LlamaLuLu/EEE4022S-AR-Spine-Registration/docs/figures/fig_atp6_timing.pdf

## Wireframe on Wireframe off

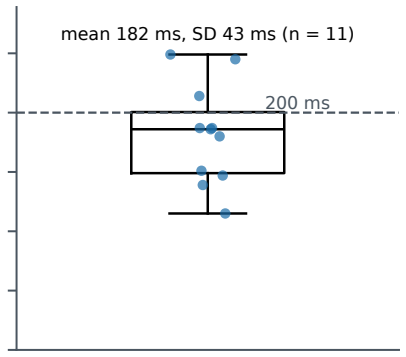
[picture p6: figure]
mean 182 ms, SD 43 ms (n = 11)

0

10

20

30

40

## Processing time per frame (ms)

29.7 ms
30.4 FPS

10.6 ms
31.3 FPS

## (a) Pipeline timing

Frame grab
Detect + PnP
Overlay
Qt display

0

50

100

150

200

250

## Camera-to-screen latency (ms)

## (b) End-to-end latency
