LlamaLuLu/EEE4022S-AR-Spine-Registration/docs/figures/fig_calib_depth.pdf

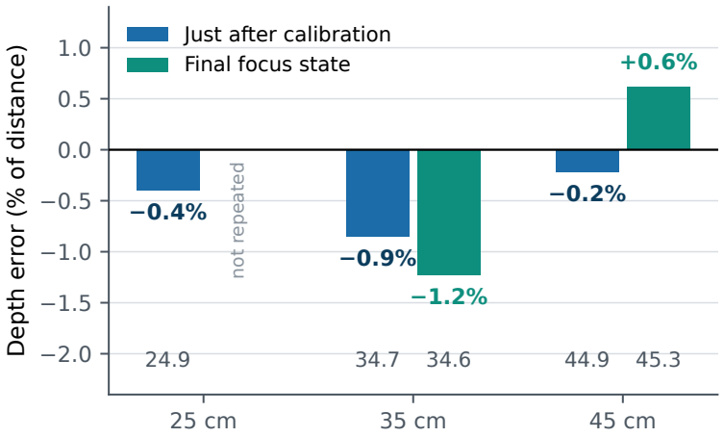
[picture p7: figure]
Depth error (% of distance); not repeated; Just after calibration Final focus state

Measured distance (ruler). Grey numbers: recovered depth (cm)
