LlamaLuLu/EEE4022S-AR-Spine-Registration/docs/figures/fig_envelope_diagram.pdf

(a) Plan view: azimuth and distance
(b) Side view: elevation and distance

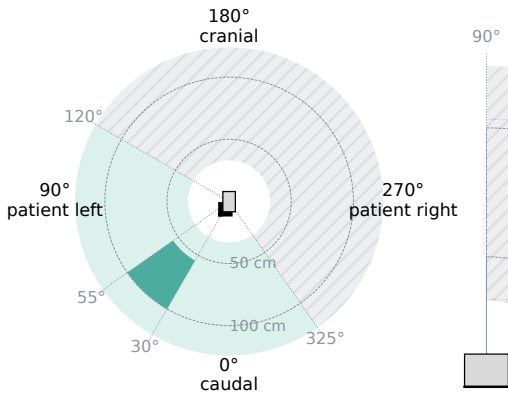
[picture p8: figure]
0° caudal; 90° patient left; 180° cranial; 270° patient right
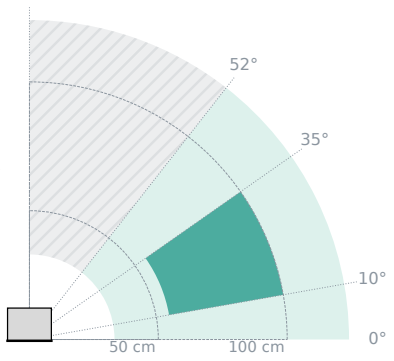
[picture p9: figure]

Full accuracy: both faces, 55-100 cm, azimuth 30-55°, elevation 10-35°
Reduced: tracking holds, one face or steeper view (to 124 cm, elevation up to 52°) Outside: tracking unreliable or lost
