LlamaLuLu/EEE4022S-AR-Spine-Registration/docs/figures/fig_error_budget.pdf

L5 | L4 | L3 | L2 | L1
Pedicle level (L5 nearest the markers)

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
Overlay error, RMS (mm)

Calibrated focus

L5 | L4 | L3 | L2 | L1
Pedicle level (L5 nearest the markers)

Drifted focus

Measured | Random (simulated) | Remaining error
