LlamaLuLu/EEE4022S-AR-Spine-Registration/docs/figures/fig_method_states.pdf

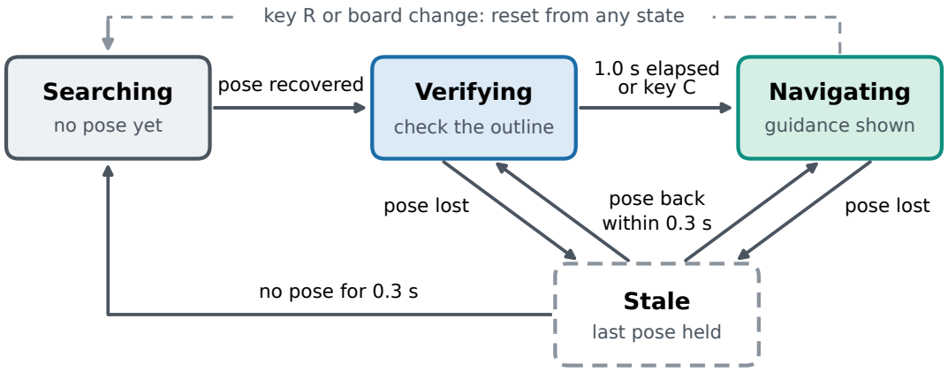
[picture p10: figure]
Searching; no pose yet; Verifying; check the outline; Navigating; guidance shown; Stale; last pose held; pose recovered; 1.0 s elapsed or key C; pose lost; pose lost pose back; within 0.3 s; no pose for 0.3 s

a pose that returns resumes the state it left key R or board change: reset from any state
