LlamaLuLu/EEE4022S-AR-Spine-Registration/docs/figures/fig_method_visibility.pdf

marker

θ | normal
w ∝ cos θ | image camera
(a) What the detector sees
(b) Falls with view angle

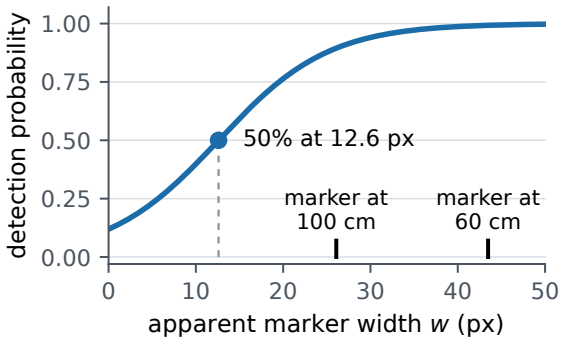
[picture p11: figure]
apparent marker width w (px); detection probability; marker at 100 cm; marker at 60 cm

(c) Rises with apparent width

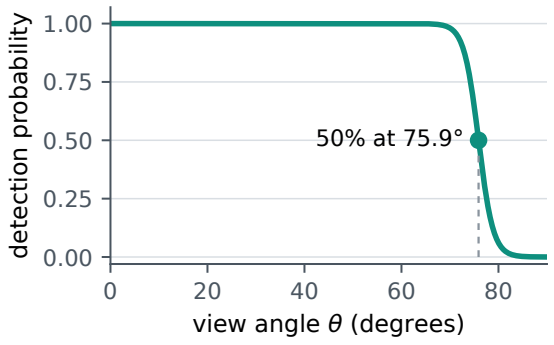
[picture p12: figure]
view angle θ (degrees); detection probability
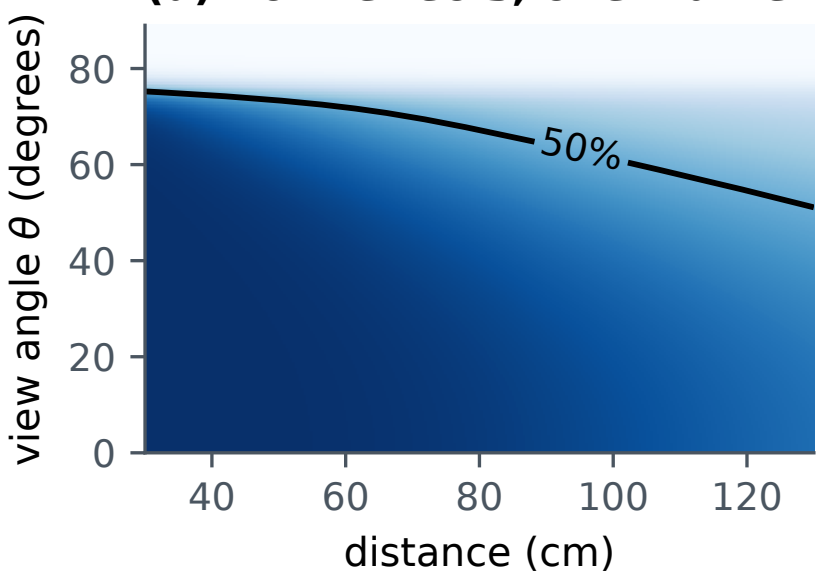
[picture p13: figure]
distance (cm); vie; w angle; gre

(d) Both effects, one marker

0.0

0.2

0.4

0.6

0.8

1.0
detection probability
