LlamaLuLu/EEE4022S-AR-Spine-Registration/docs/figures/fig_method_visibility_row.pdf

marker

θ | normal
w ∝ cos θ | image

camera

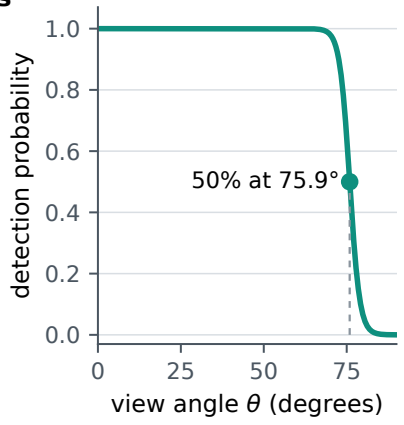
[picture p14: figure]
view angle θ (degrees); detection probability

(a) What the detector sees
(b) Falls with view angle

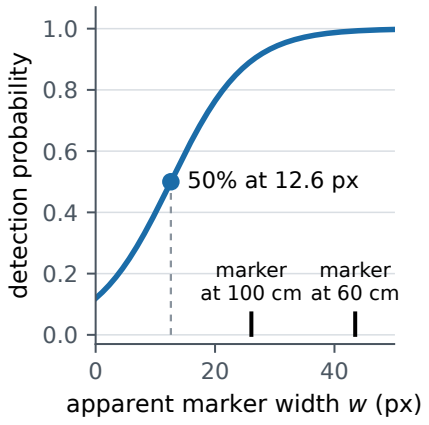
[picture p15: figure]
apparent marker width w (px); detection probability; marker at 100 cm; marker at 60 cm

(c) Rises with width

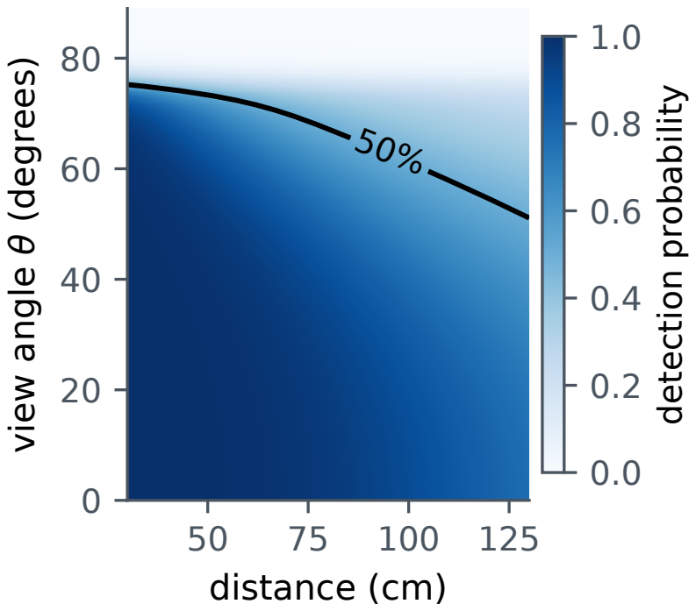
[picture p16: figure]
distance (cm); vie; w angle; gre; detection probability

(d) Both effects, one marker
