LlamaLuLu/EEE4022S-AR-Spine-Registration/docs/figures/fig_tier_comparison.pdf

Full
(6.8)

Reduced
(5.4)

Outside
(2.0)

0

25

50

75

100

Share of frames (%)

(a) Tracking

PnP success
Overlay lost

Full
(6.8)

Reduced
(5.4)

Outside
(2.0)

0

1

2

3

4

Predicted TRE (mm)

(b) Predicted TRE

Mean over targets
Worst target, p95
