LlamaLuLu/EEE4022S-AR-Spine-Registration/docs/figures/lit_registration_taxonomy.pdf

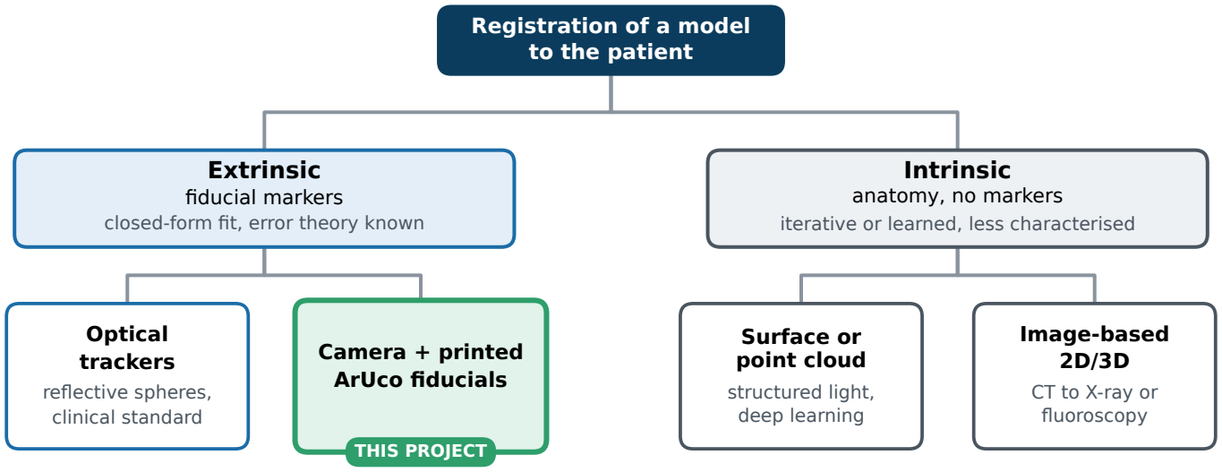
[picture p18: figure]
Registration of a model to the patient; Extrinsic fiducial markers closed-form fit, error theory known; Intrinsic anatomy, no markers iterative or learned, less characterised; Optical trackers reflective spheres, clinical standard; Camera + printed ArUco fiducials; THIS PROJECT; Surface or point cloud; structured light, deep learning; Image-based 2D/3D; CT to X-ray or fluoroscopy
