LlamaLuLu/EEE4022S-AR-Spine-Registration/docs/figures/fig_method_variants.pdf

## V0 Flat baseline board

4 coplanar markers on the base plate, seen from above

## V1 L-bracket, spread

6 markers, centres 15 to 65 mm from the face edges

## V2 L-bracket, clustered

6 markers, centres 27 to 53 mm from the face edges

## V3 L-bracket, 8 markers (fabricated)

8 markers, centres 15 to 65 mm from the face edges

Key

Face A, caudal wall

Face B, patient-left wall

n | 20 mm marker, ID n
| 20 mm, same scale

Plan view at left: where the bracket sits on the plate. V1 to V3 are
unfolded as seen from outside the bracket corner (arrow), junction in the middle.

spine (occludes the plate markers)

patient left

patient right

caudal end | cranial end

1 0

2

3

Face B | Face A
| 0 1

2

3 4

5

Face B | Face A

0 1

2

3 4

5

Face B | Face A
| 0 1

2 3

4 5

6 7

A

B
