LlamaLuLu/EEE4022S-AR-Spine-Registration/data/atp/azimuth_dial.pdf

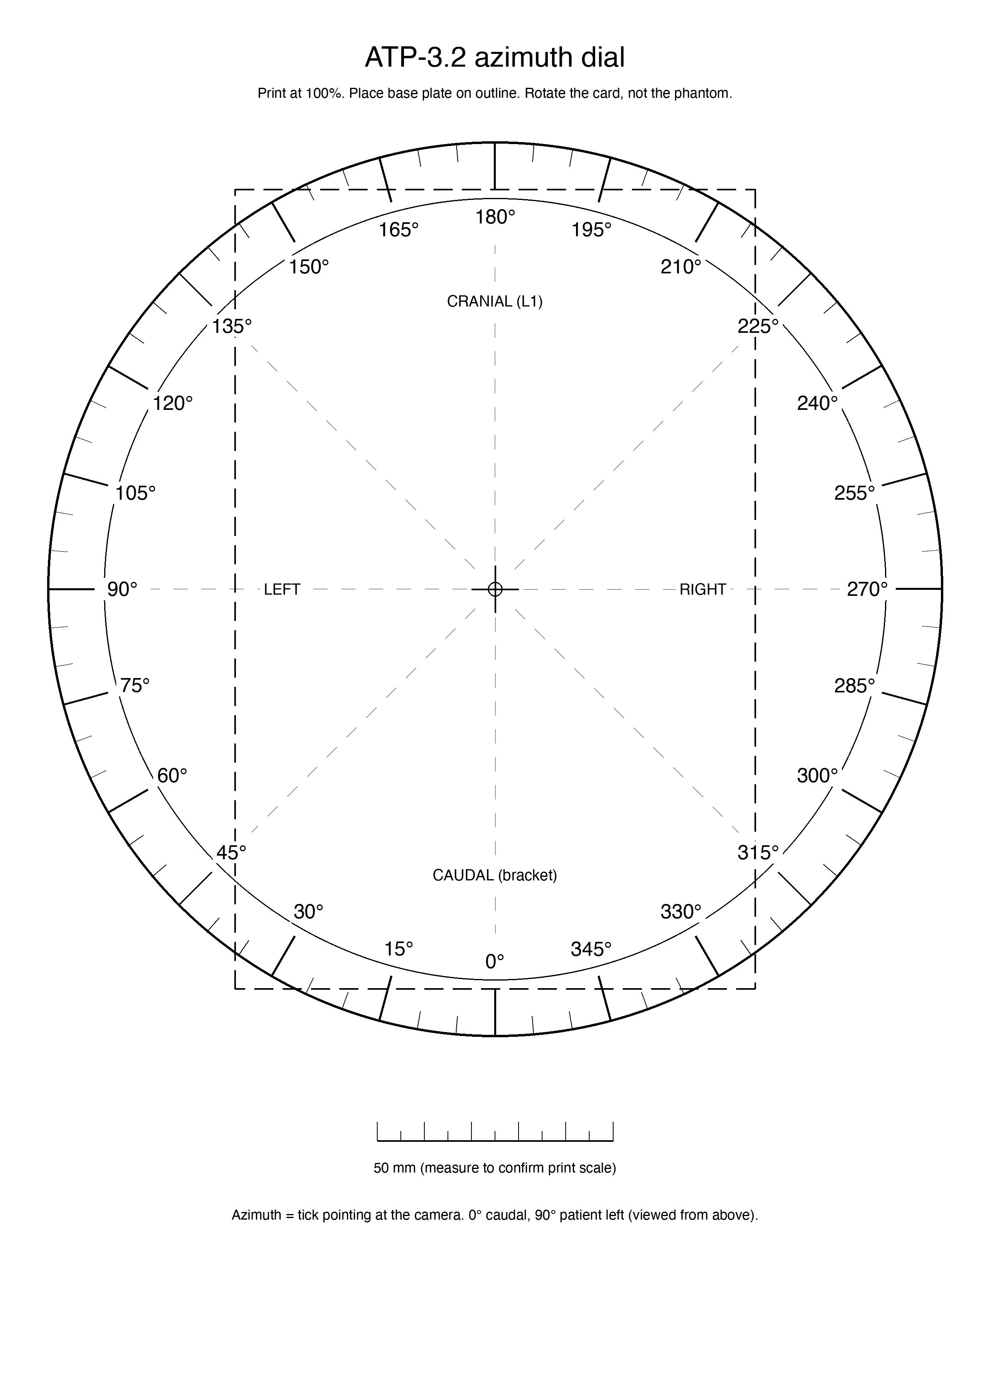
[picture p19: page 1]
