LlamaLuLu/EEE4022S-AR-Spine-Registration/data/bracket_markers/bracket_face_blocks.pdf

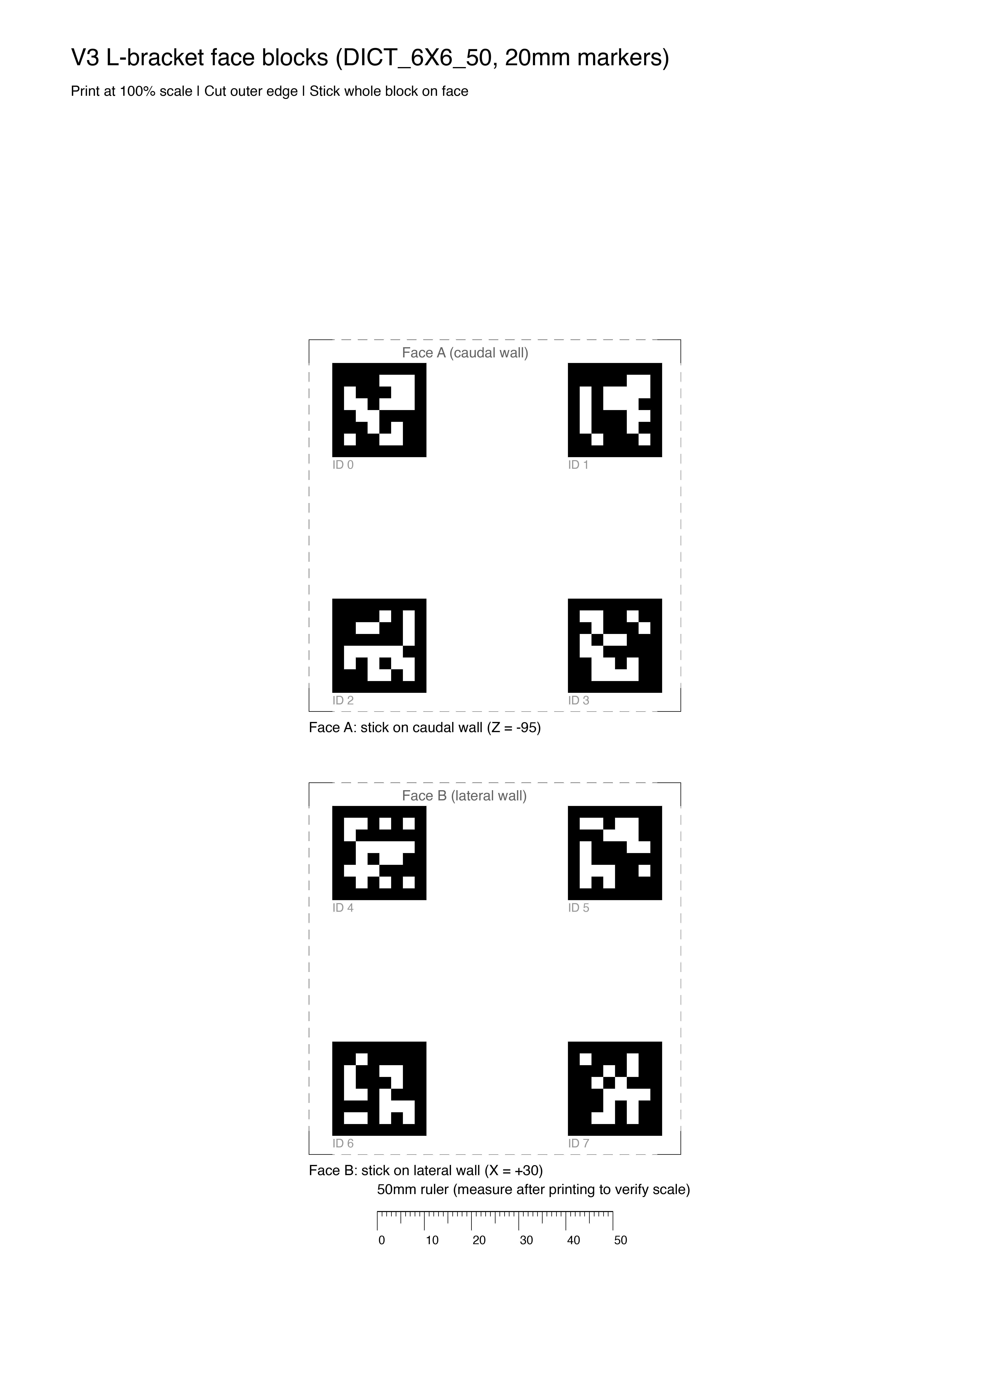
[picture p20: page 1]
