LlamaLuLu/EEE4022S-AR-Spine-Registration/data/bracket_markers/bracket_markers.pdf

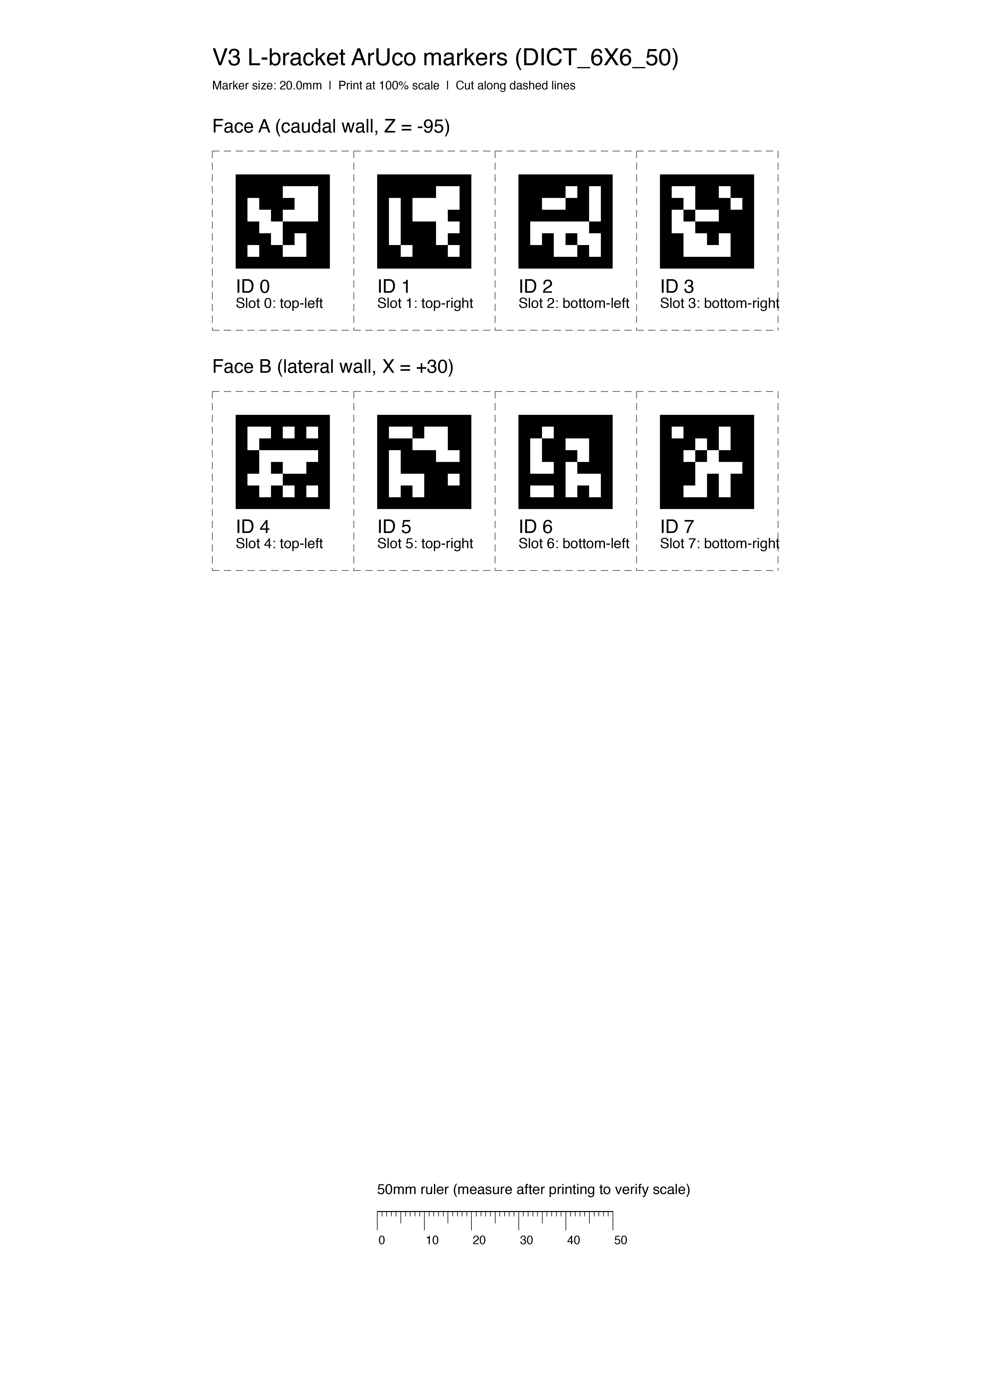
[picture p21: page 1]
