LlamaLuLu/EEE4022S-AR-Spine-Registration/appendix_figs/new_ui/ui_a_p1_tracking_good.png

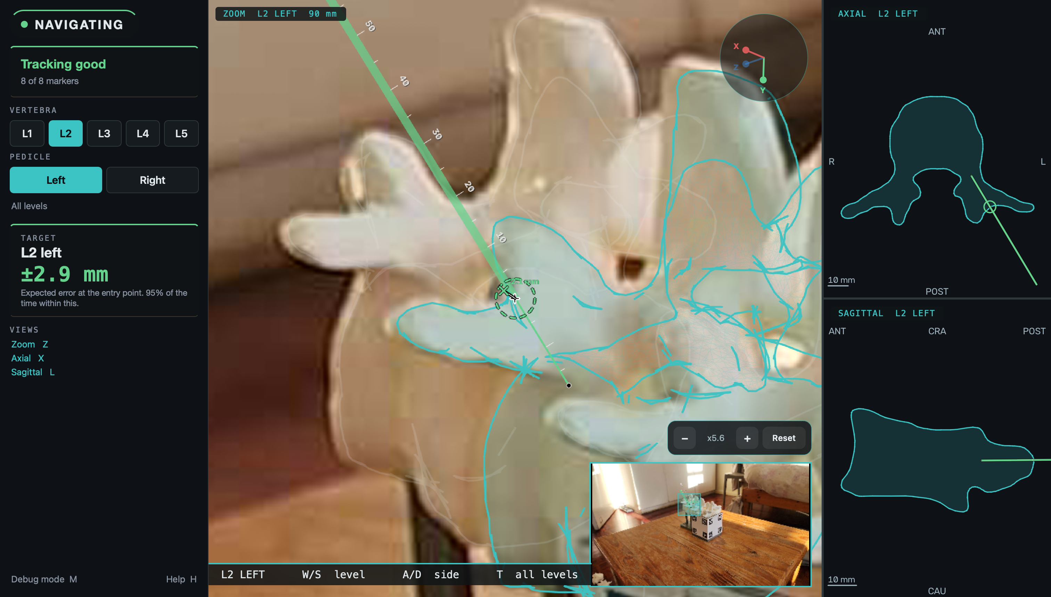
appendix_figs/new_ui/ui_a_p1_tracking_good.png
