LlamaLuLu/EEE4022S-AR-Spine-Registration/appendix_figs/new_ui/ui_b_p1_tracking_limited.png

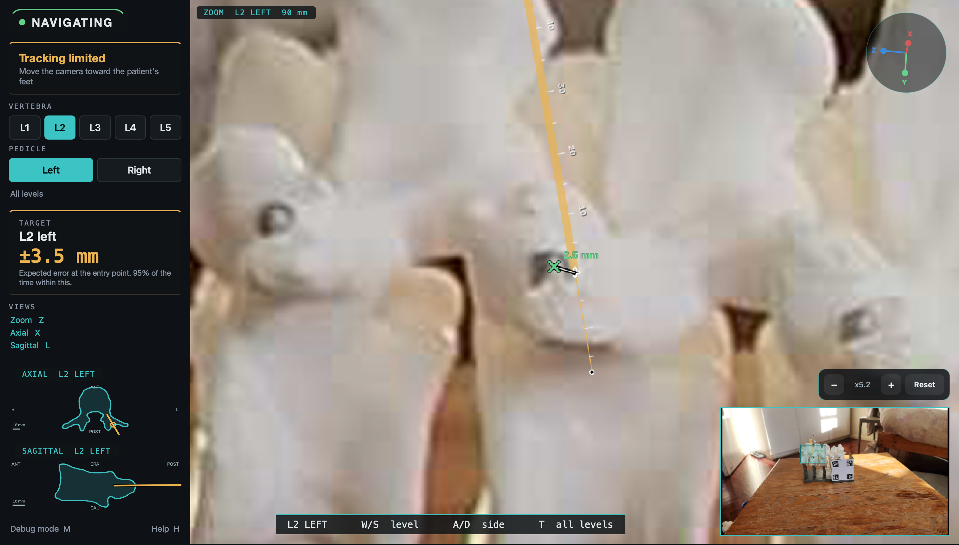
appendix_figs/new_ui/ui_b_p1_tracking_limited.png
