LlamaLuLu/EEE4022S-AR-Spine-Registration/appendix_figs/new_ui/ui_c_p1_poor_4of8.png

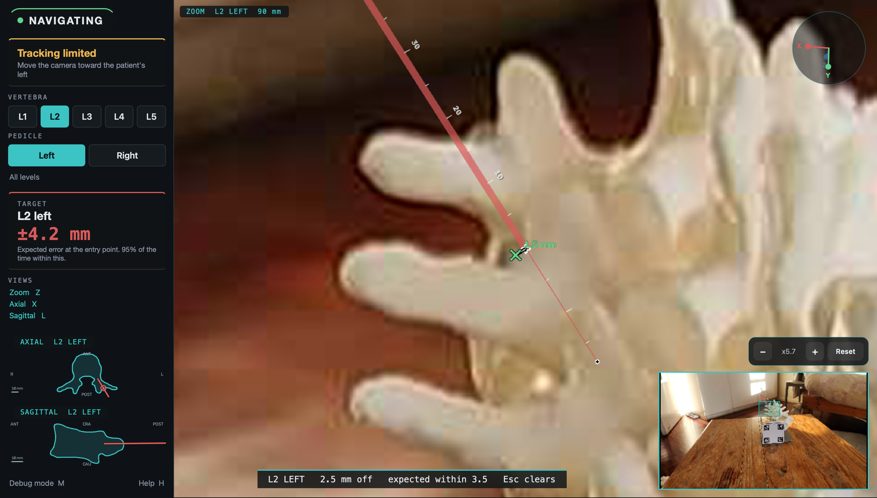
appendix_figs/new_ui/ui_c_p1_poor_4of8.png
