LlamaLuLu/EEE4022S-AR-Spine-Registration/appendix_figs/new_ui/ui_d_p2_tracking_good.png

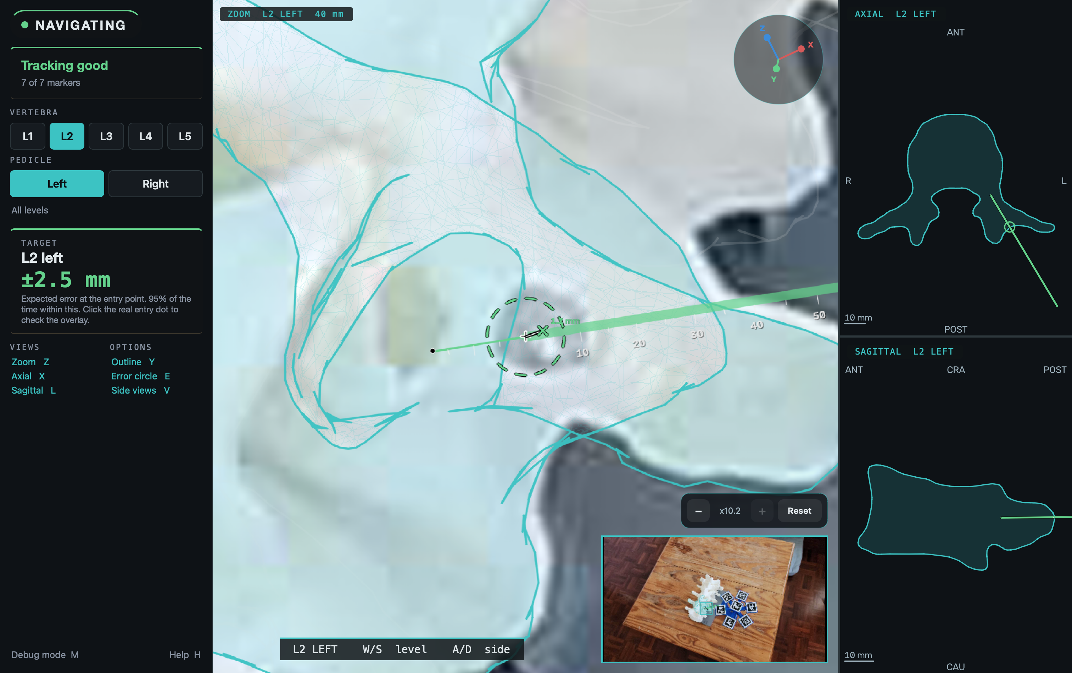
appendix_figs/new_ui/ui_d_p2_tracking_good.png
