LlamaLuLu/EEE4022S-AR-Spine-Registration/appendix_figs/p1_lighting/p1_light_a_normal.png

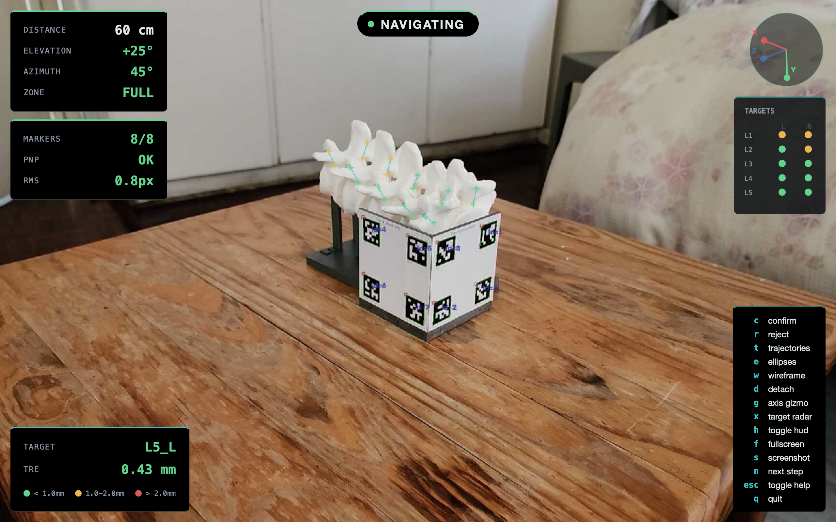
appendix_figs/p1_lighting/p1_light_a_normal.png
