LlamaLuLu/EEE4022S-AR-Spine-Registration/appendix_figs/p1_occlusion/p1_occ_a_8of8.png

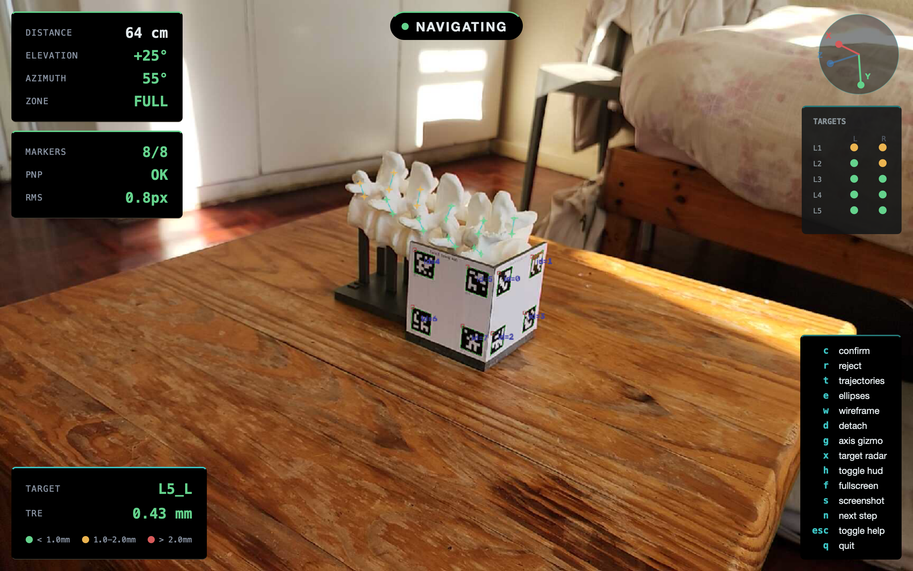
appendix_figs/p1_occlusion/p1_occ_a_8of8.png
