LlamaLuLu/EEE4022S-AR-Spine-Registration/appendix_figs/p1_occlusion/p1_occ_b_4of8_reduced.png

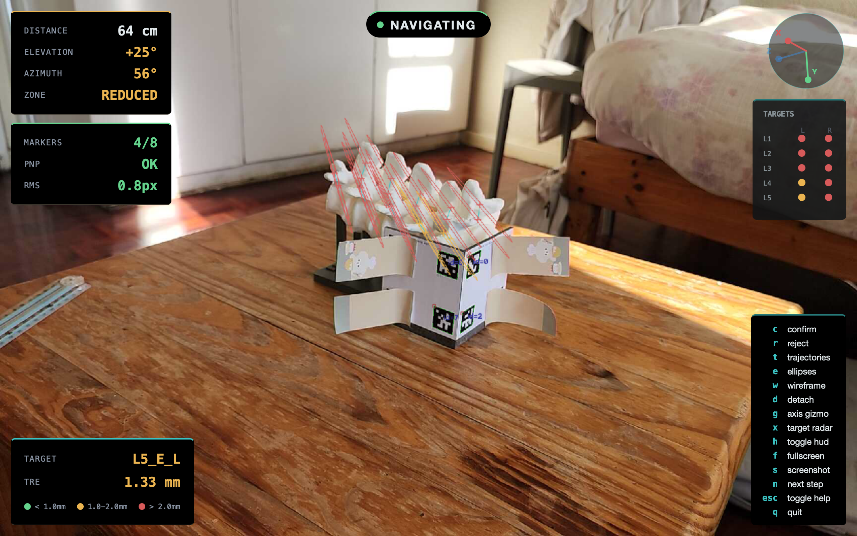
appendix_figs/p1_occlusion/p1_occ_b_4of8_reduced.png
