LlamaLuLu/EEE4022S-AR-Spine-Registration/appendix_figs/p1_occlusion/p1_occ_c_3of8_fail_searching.png

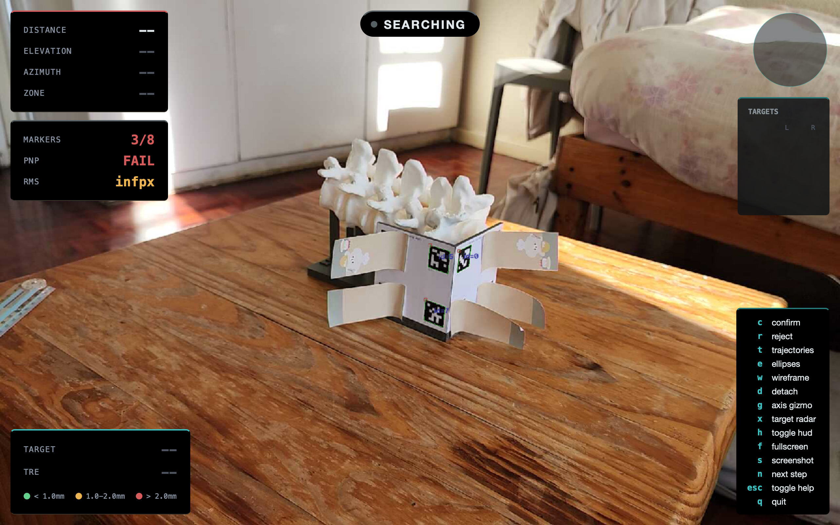
appendix_figs/p1_occlusion/p1_occ_c_3of8_fail_searching.png
