LlamaLuLu/EEE4022S-AR-Spine-Registration/appendix_figs/p1_occlusion/p1_occ_d_3of8_stale_pose.png

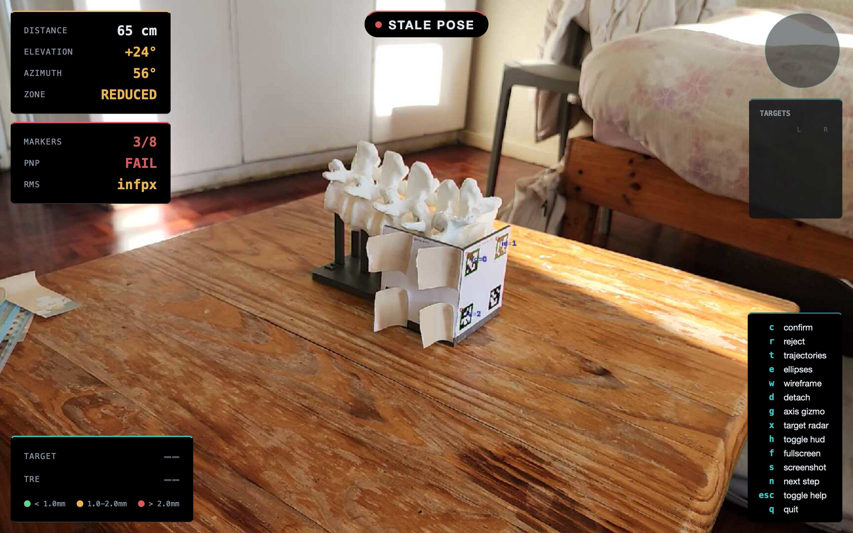
appendix_figs/p1_occlusion/p1_occ_d_3of8_stale_pose.png
