LlamaLuLu/EEE4022S-AR-Spine-Registration/appendix_figs/p1_viewpoints/p1_view_a_8of8_az45_el26.png

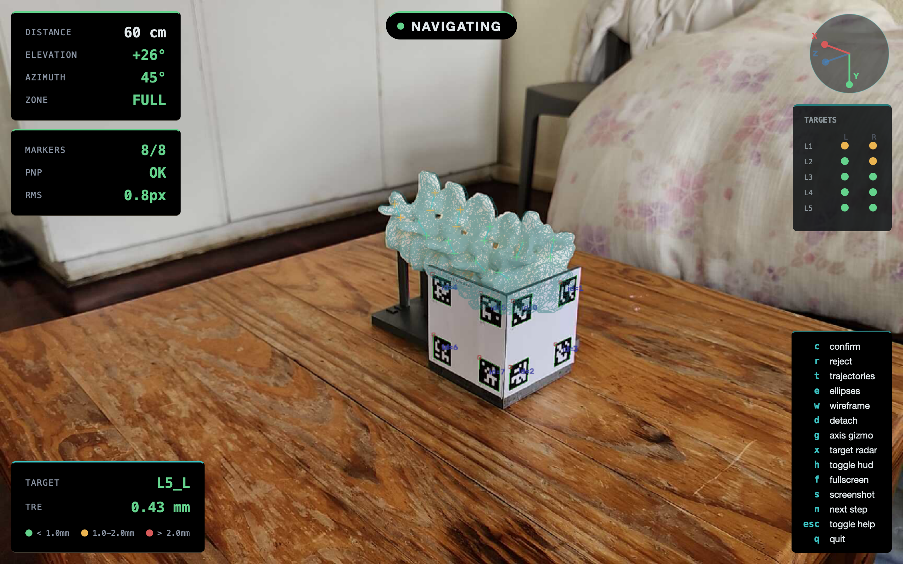
appendix_figs/p1_viewpoints/p1_view_a_8of8_az45_el26.png
