LlamaLuLu/EEE4022S-AR-Spine-Registration/appendix_figs/p1_viewpoints/p1_view_b_4of8_az90_el25.png

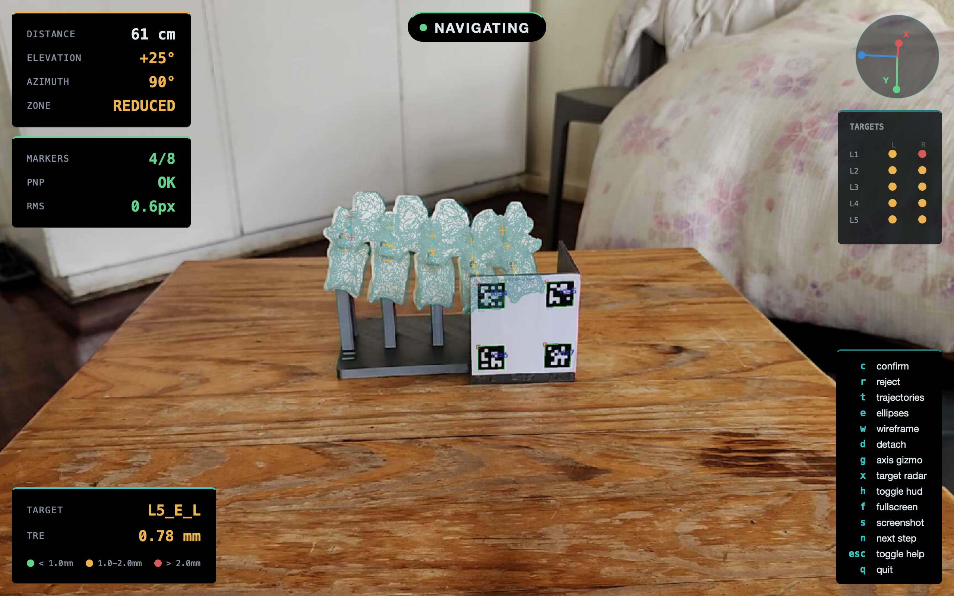
appendix_figs/p1_viewpoints/p1_view_b_4of8_az90_el25.png
