LlamaLuLu/EEE4022S-AR-Spine-Registration/appendix_figs/p1_viewpoints/p1_view_c_4of8_az10_el26.png

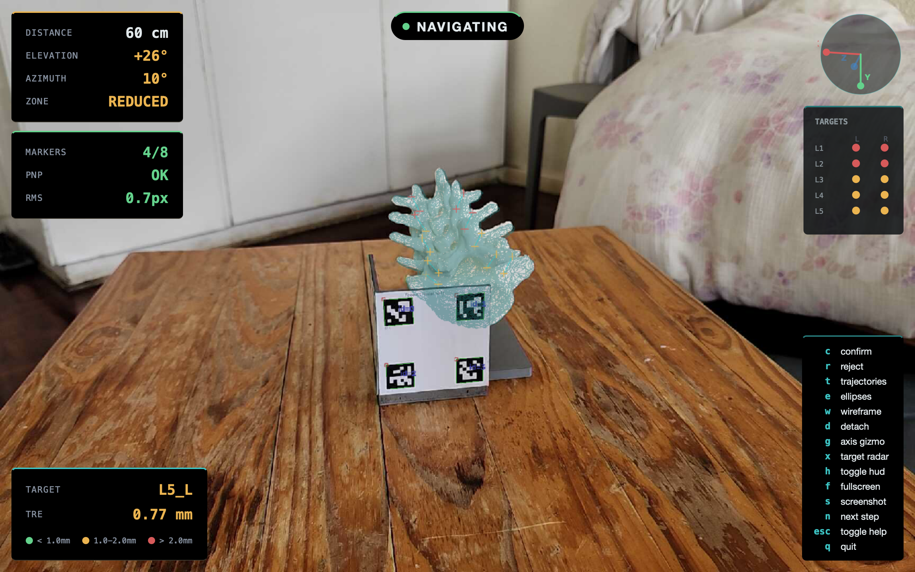
appendix_figs/p1_viewpoints/p1_view_c_4of8_az10_el26.png
