LlamaLuLu/EEE4022S-AR-Spine-Registration/appendix_figs/p2_glare/p2_glare_a_reference.png

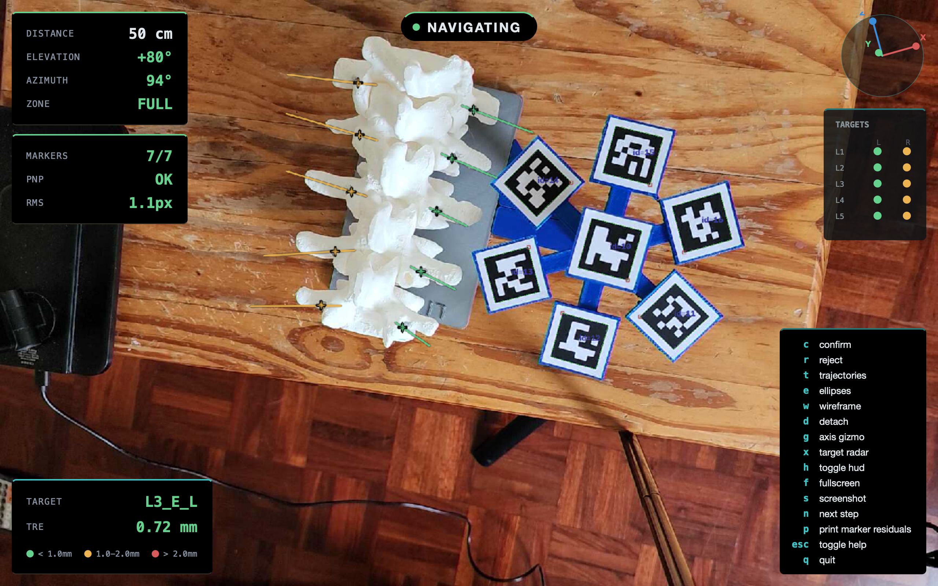
appendix_figs/p2_glare/p2_glare_a_reference.png
