LlamaLuLu/EEE4022S-AR-Spine-Registration/appendix_figs/p2_glare/p2_glare_b_lamp.png

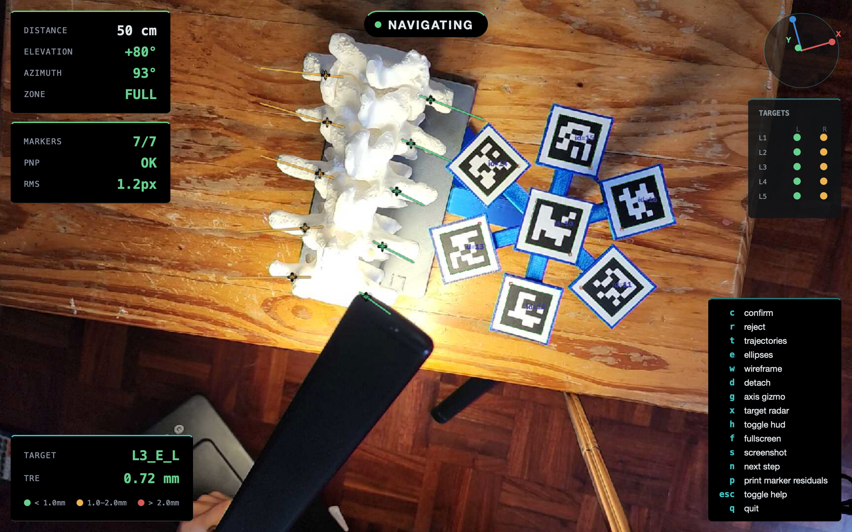
appendix_figs/p2_glare/p2_glare_b_lamp.png
