LlamaLuLu/EEE4022S-AR-Spine-Registration/appendix_figs/p2_glare/p2_glare_c.png

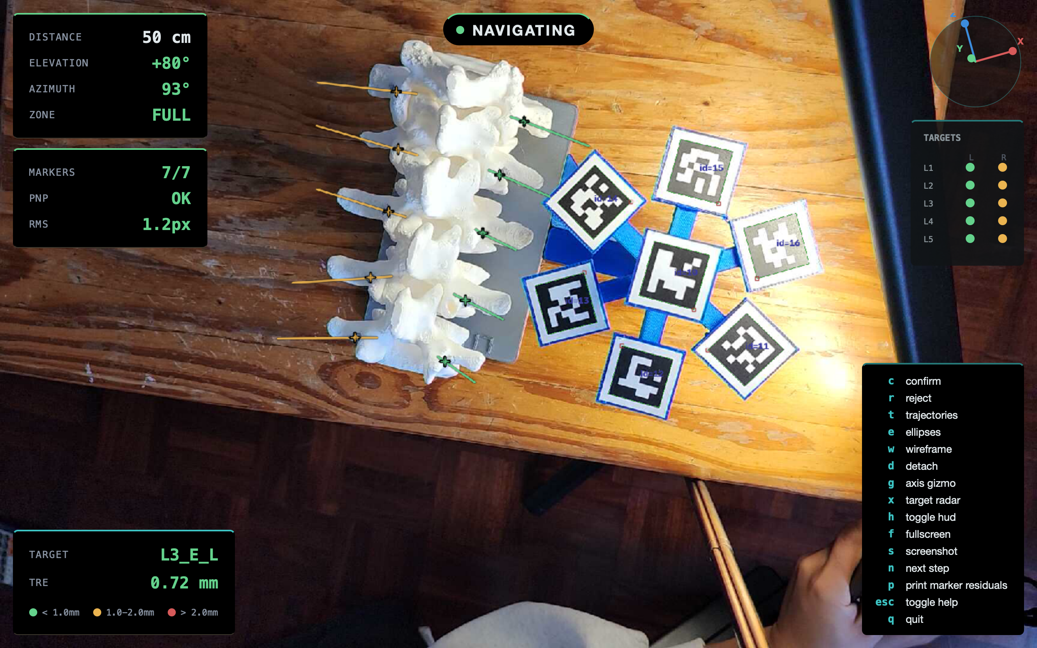
appendix_figs/p2_glare/p2_glare_c.png
