LlamaLuLu/EEE4022S-AR-Spine-Registration/appendix_figs/p2_lighting/p2_light_a.png

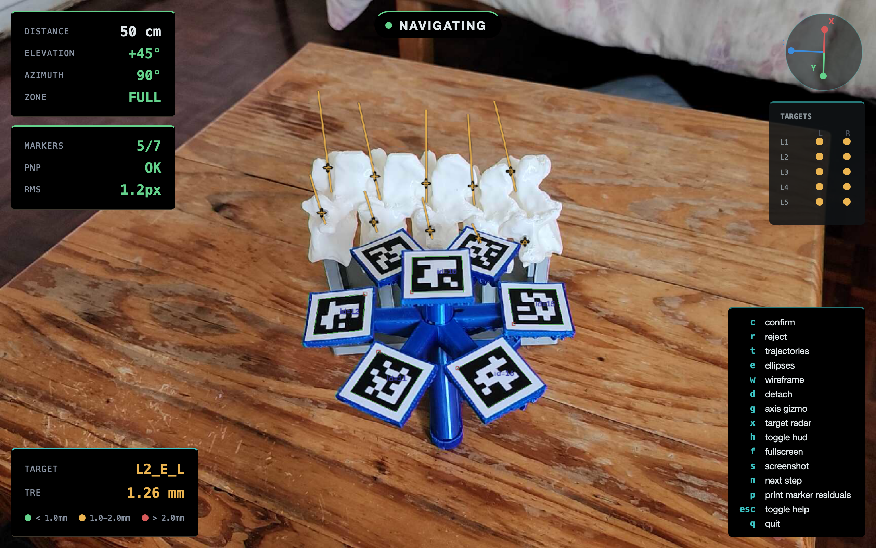
appendix_figs/p2_lighting/p2_light_a.png
