LlamaLuLu/EEE4022S-AR-Spine-Registration/appendix_figs/p2_lighting/p2_light_d_partial_shadow.png

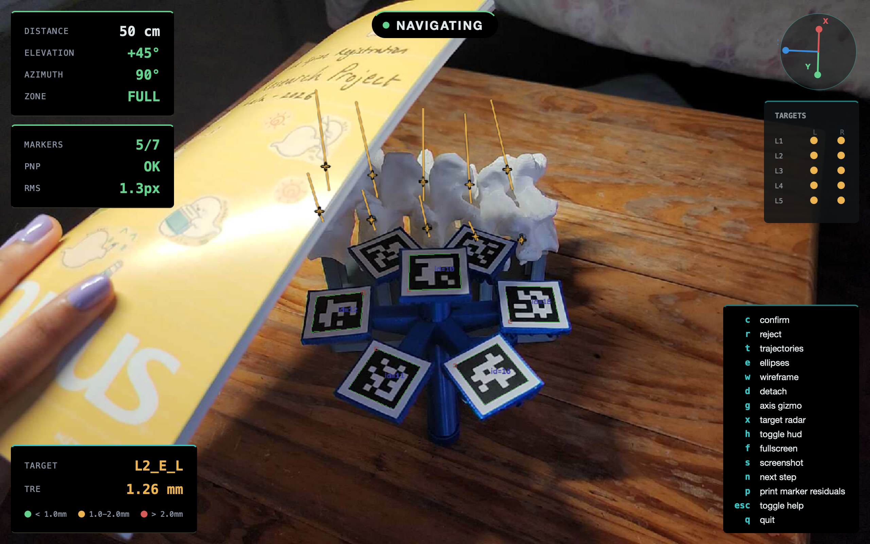
appendix_figs/p2_lighting/p2_light_d_partial_shadow.png
