LlamaLuLu/EEE4022S-AR-Spine-Registration/appendix_figs/p2_viewpoints/p2_view_a_az3_el25.png

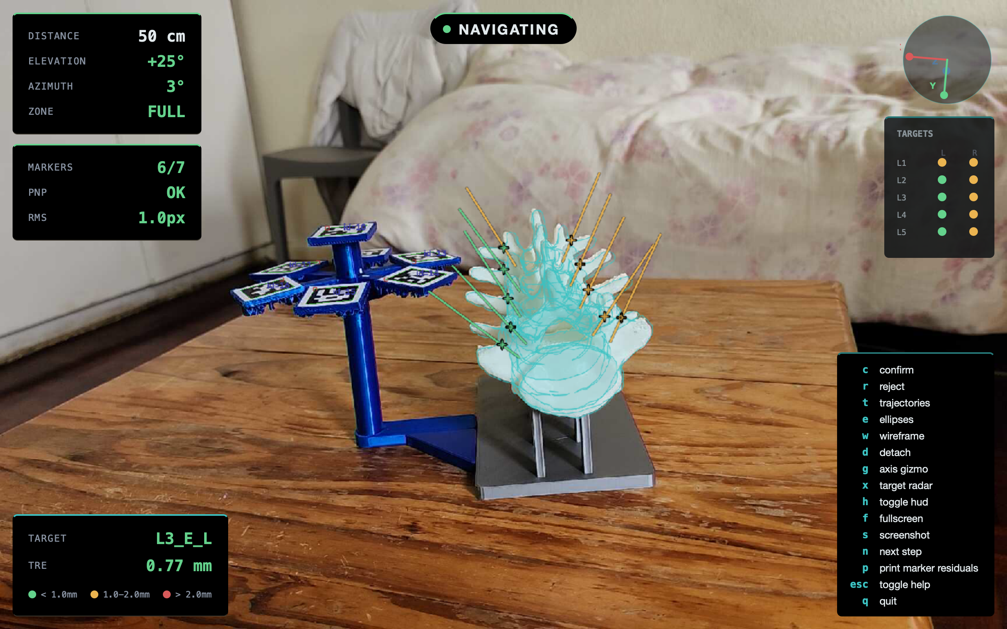
appendix_figs/p2_viewpoints/p2_view_a_az3_el25.png
