LlamaLuLu/EEE4022S-AR-Spine-Registration/appendix_figs/p2_viewpoints/p2_view_b_az90_el61.png

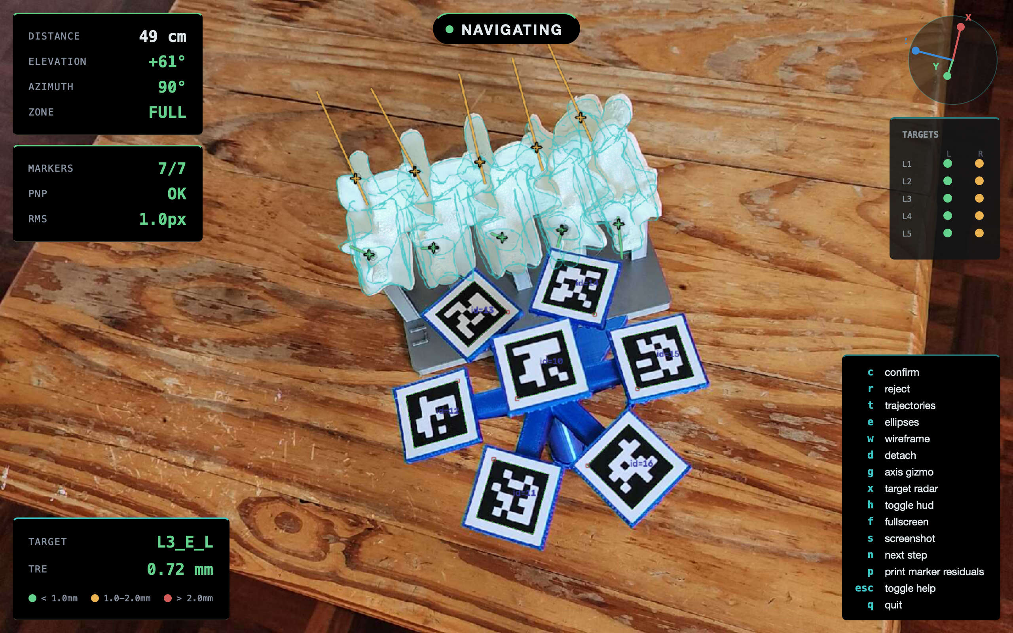
appendix_figs/p2_viewpoints/p2_view_b_az90_el61.png
