LlamaLuLu/EEE4022S-AR-Spine-Registration/appendix_figs/p2_viewpoints/p2_view_c_az90_el77.png

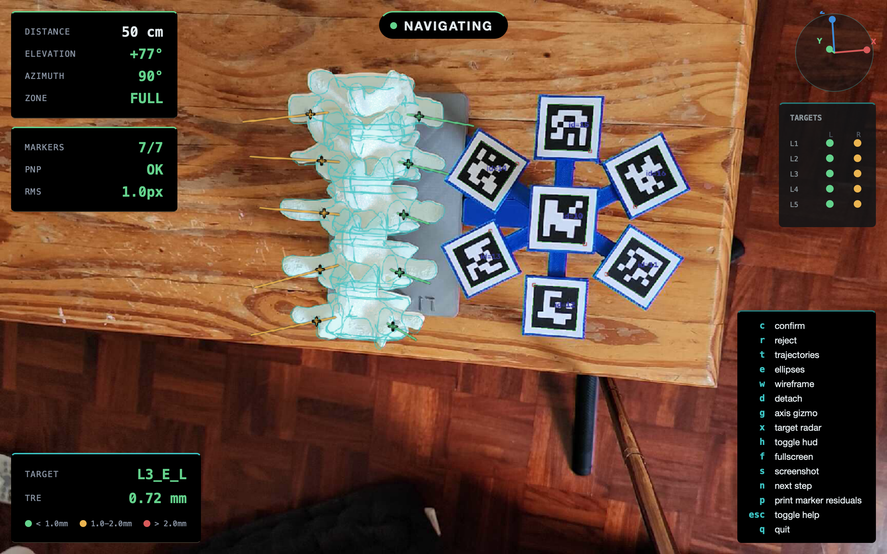
appendix_figs/p2_viewpoints/p2_view_c_az90_el77.png
