LlamaLuLu/EEE4022S-AR-Spine-Registration/data/bracket_markers/bracket_sheet.png

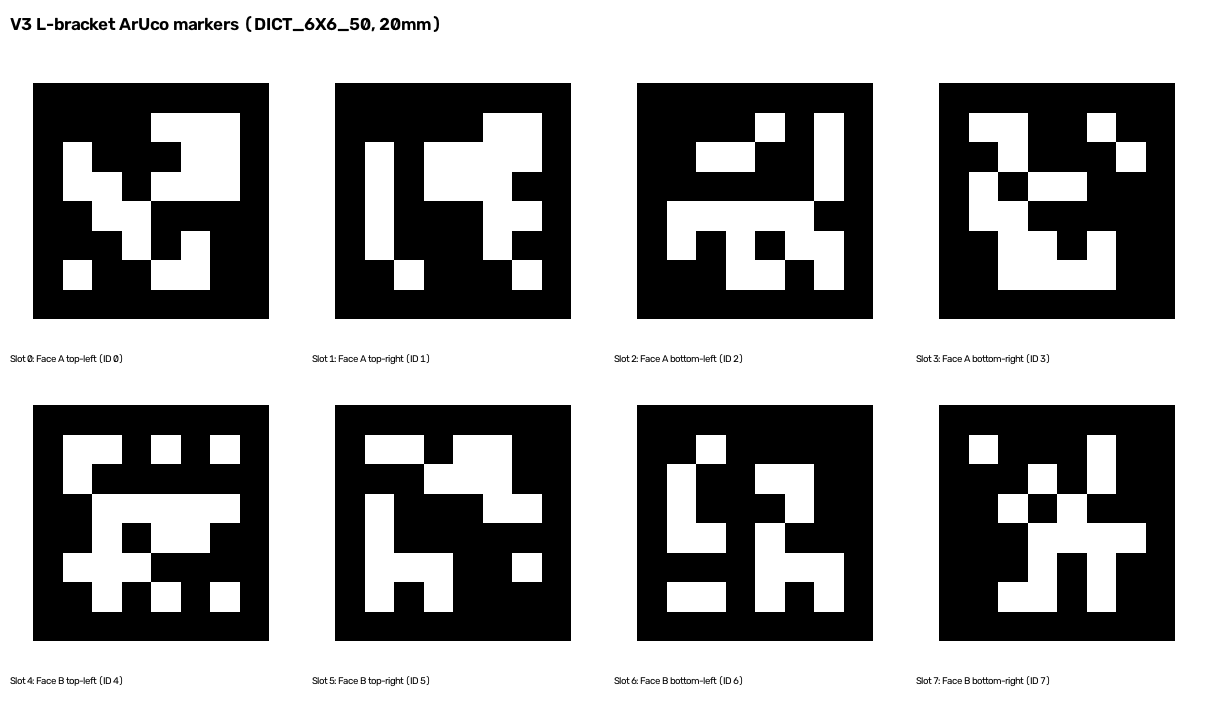
data/bracket_markers/bracket_sheet.png
