LlamaLuLu/EEE4022S-AR-Spine-Registration/data/bracket_markers/marker_slot0_id0.png

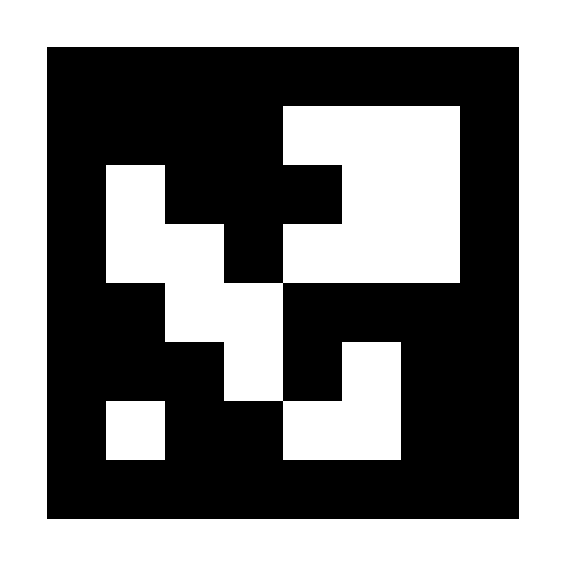
data/bracket_markers/marker_slot0_id0.png
