LlamaLuLu/EEE4022S-AR-Spine-Registration/data/bracket_markers/marker_slot1_id1.png

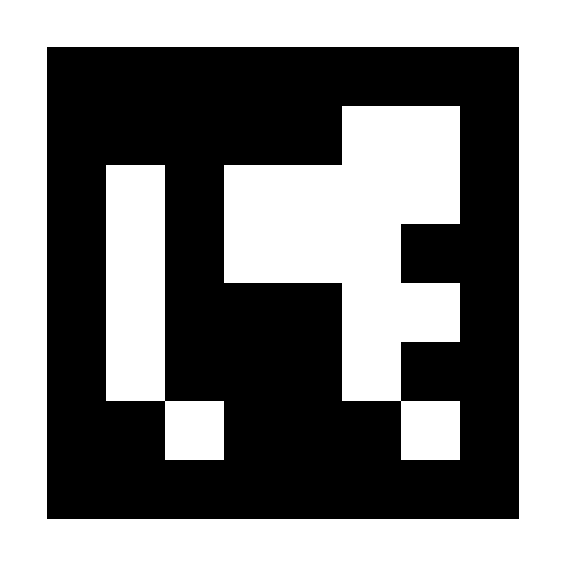
data/bracket_markers/marker_slot1_id1.png
