LlamaLuLu/EEE4022S-AR-Spine-Registration/data/bracket_markers/marker_slot2_id2.png

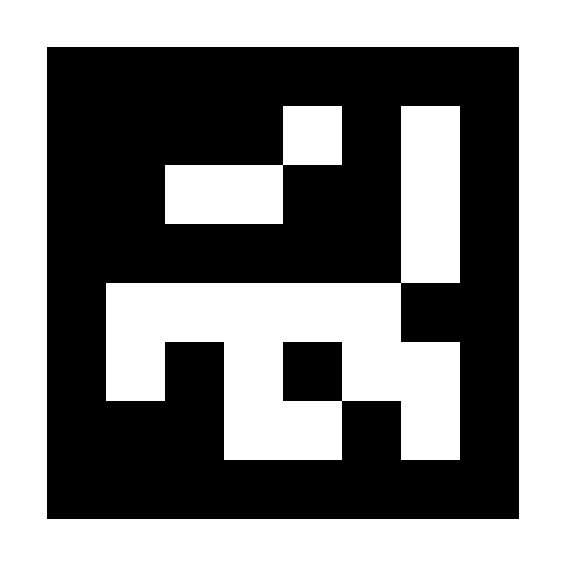
data/bracket_markers/marker_slot2_id2.png
