LlamaLuLu/EEE4022S-AR-Spine-Registration/data/bracket_markers/marker_slot3_id3.png

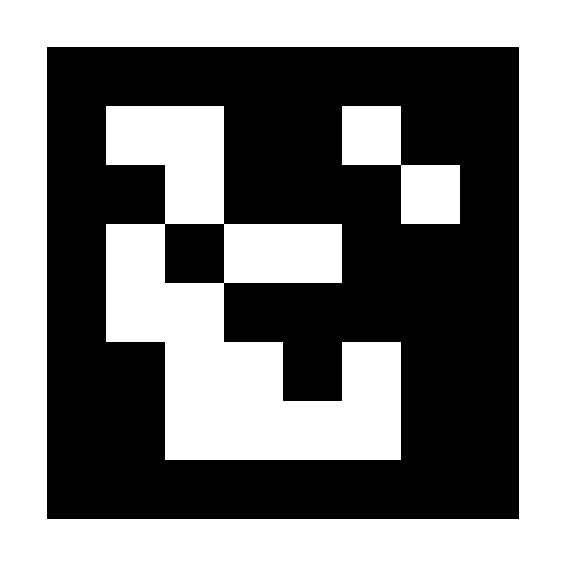
data/bracket_markers/marker_slot3_id3.png
