LlamaLuLu/EEE4022S-AR-Spine-Registration/data/bracket_markers/marker_slot4_id4.png

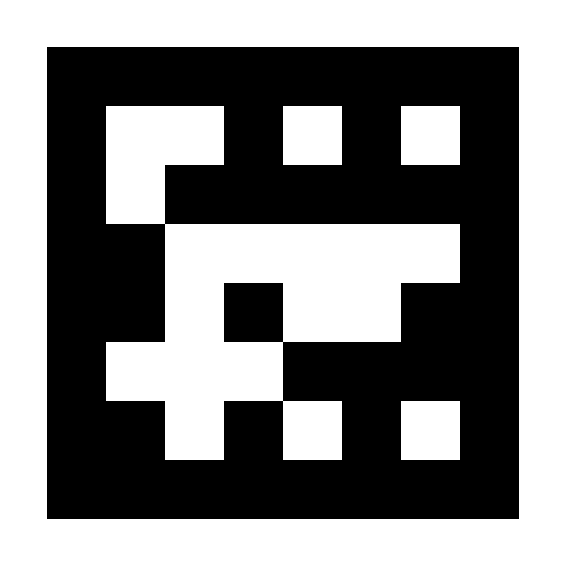
data/bracket_markers/marker_slot4_id4.png
