LlamaLuLu/EEE4022S-AR-Spine-Registration/data/bracket_markers/marker_slot5_id5.png

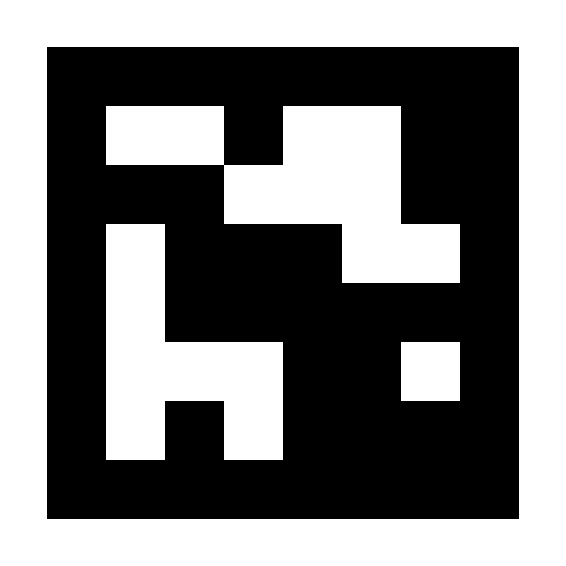
data/bracket_markers/marker_slot5_id5.png
