LlamaLuLu/EEE4022S-AR-Spine-Registration/data/bracket_markers/marker_slot6_id6.png

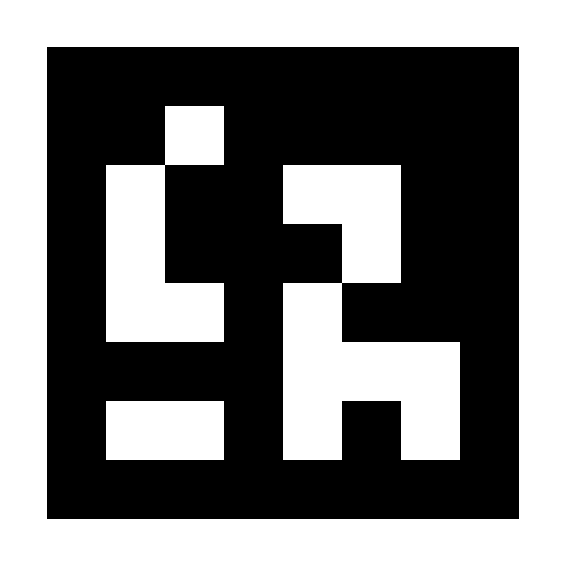
data/bracket_markers/marker_slot6_id6.png
