LlamaLuLu/EEE4022S-AR-Spine-Registration/data/bracket_markers/marker_slot7_id7.png

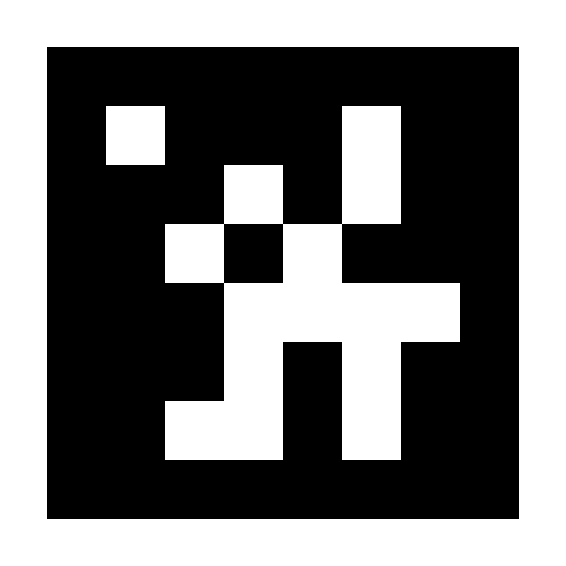
data/bracket_markers/marker_slot7_id7.png
