LlamaLuLu/EEE4022S-AR-Spine-Registration/data/verse20/derivatives/sub-gl003/sub-gl003_dir-ax_seg-vert_snp.png

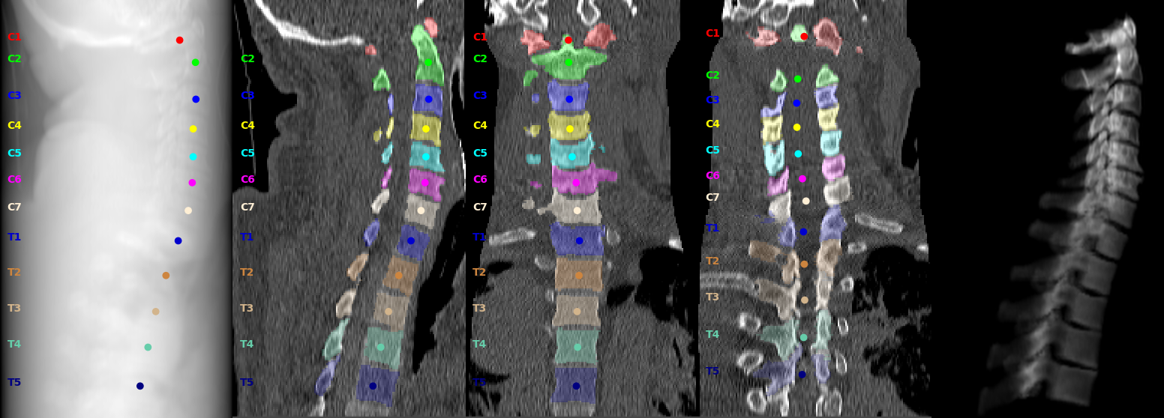
data/verse20/derivatives/sub-gl003/sub-gl003_dir-ax_seg-vert_snp.png
