LlamaLuLu/EEE4022S-AR-Spine-Registration/data/verse20/derivatives/sub-gl047/sub-gl047_dir-ax_seg-vert_snp.png

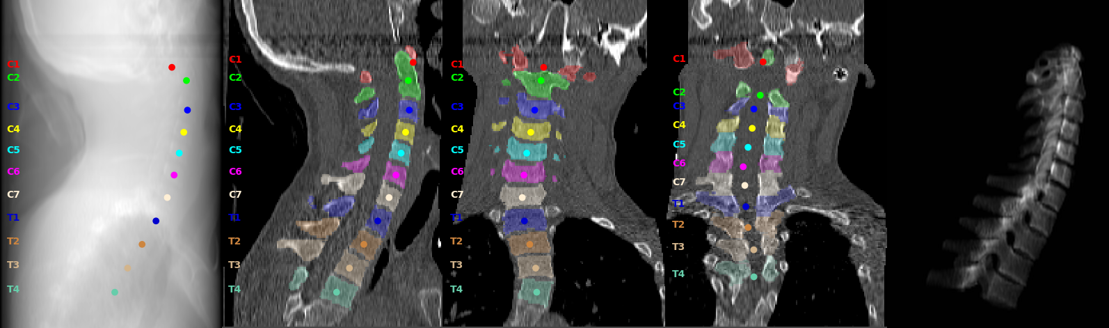
data/verse20/derivatives/sub-gl047/sub-gl047_dir-ax_seg-vert_snp.png
