LlamaLuLu/EEE4022S-AR-Spine-Registration/data/verse20/derivatives/sub-verse500/sub-verse500_dir-ax_seg-vert_snp.png

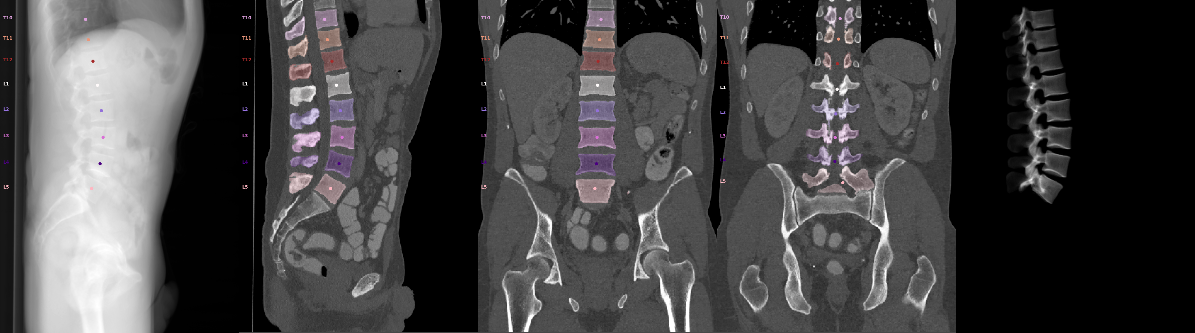
data/verse20/derivatives/sub-verse500/sub-verse500_dir-ax_seg-vert_snp.png
