LlamaLuLu/EEE4022S-AR-Spine-Registration/data/verse20/derivatives/sub-verse504/sub-verse504_dir-iso_seg-vert_snp.png

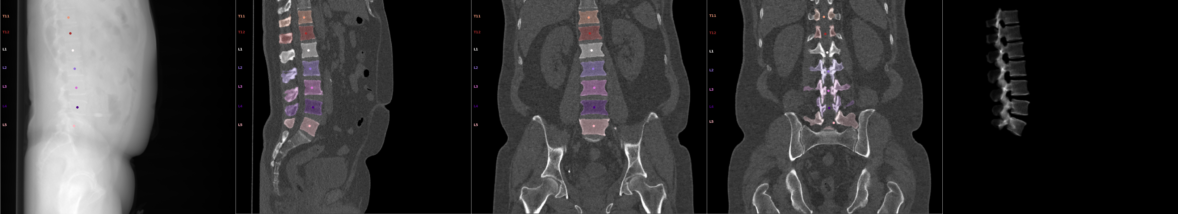
data/verse20/derivatives/sub-verse504/sub-verse504_dir-iso_seg-vert_snp.png
