LlamaLuLu/EEE4022S-AR-Spine-Registration/data/verse20/derivatives/sub-verse519/sub-verse519_dir-iso_seg-vert_snp.png

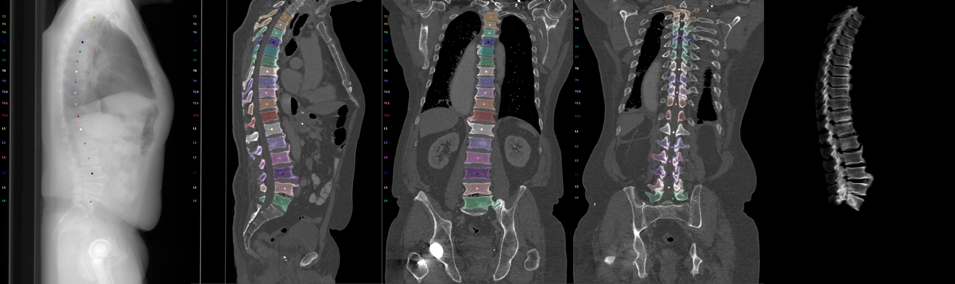
data/verse20/derivatives/sub-verse519/sub-verse519_dir-iso_seg-vert_snp.png
