LlamaLuLu/EEE4022S-AR-Spine-Registration/data/verse20/derivatives/sub-verse521/sub-verse521_dir-ax_seg-vert_snp.png

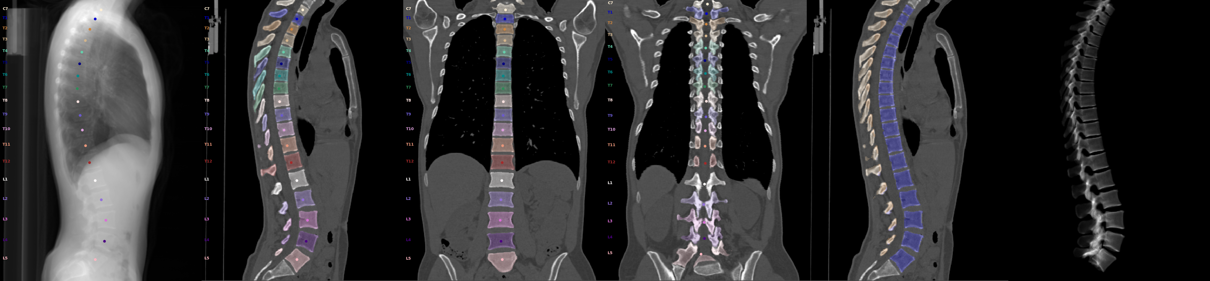
data/verse20/derivatives/sub-verse521/sub-verse521_dir-ax_seg-vert_snp.png
