LlamaLuLu/EEE4022S-AR-Spine-Registration/data/verse20/derivatives/sub-verse525/sub-verse525_dir-sag_seg-vert_snp.png

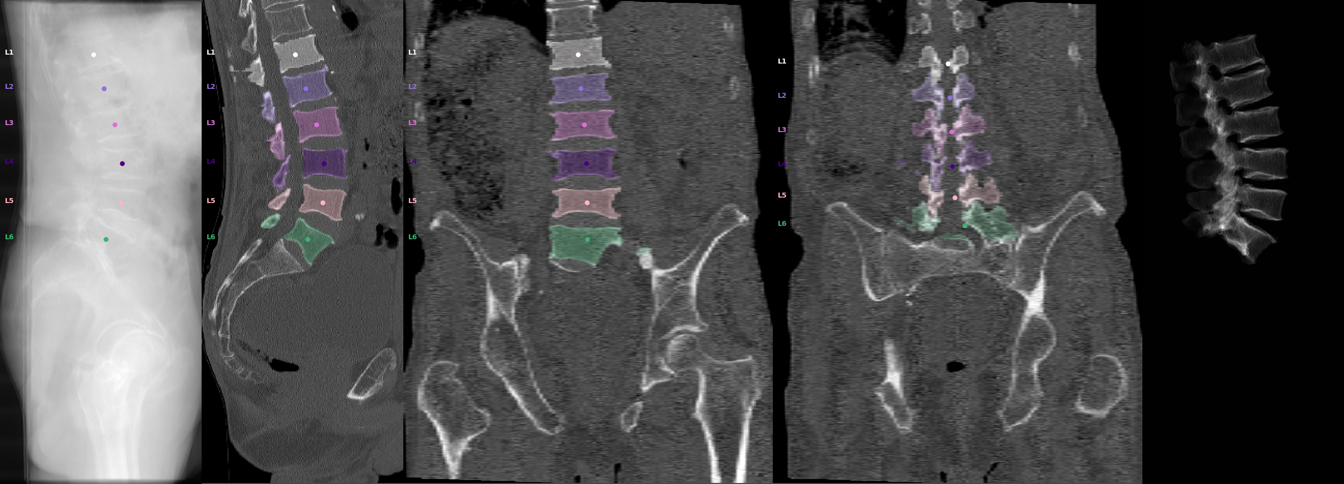
data/verse20/derivatives/sub-verse525/sub-verse525_dir-sag_seg-vert_snp.png
