LlamaLuLu/EEE4022S-AR-Spine-Registration/data/verse20/derivatives/sub-verse527/sub-verse527_dir-ax_seg-vert_snp.png

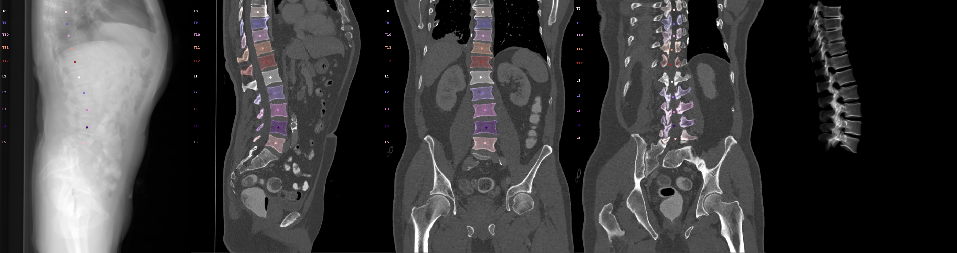
data/verse20/derivatives/sub-verse527/sub-verse527_dir-ax_seg-vert_snp.png
