LlamaLuLu/EEE4022S-AR-Spine-Registration/data/verse20/derivatives/sub-verse534/sub-verse534_dir-iso_seg-vert_snp.png

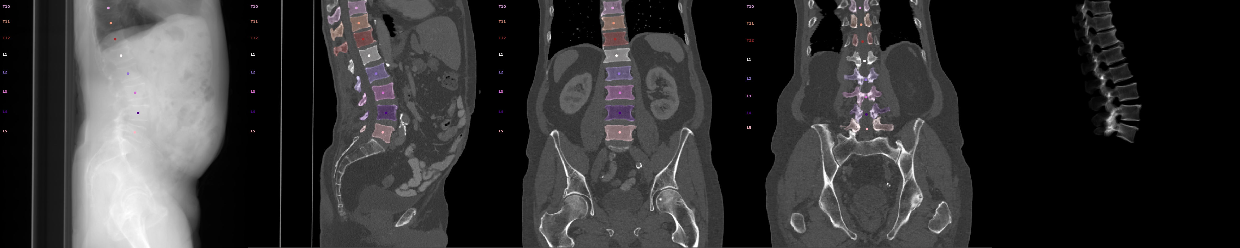
data/verse20/derivatives/sub-verse534/sub-verse534_dir-iso_seg-vert_snp.png
