LlamaLuLu/EEE4022S-AR-Spine-Registration/data/verse20/derivatives/sub-verse536/sub-verse536_dir-ax_seg-vert_snp.png

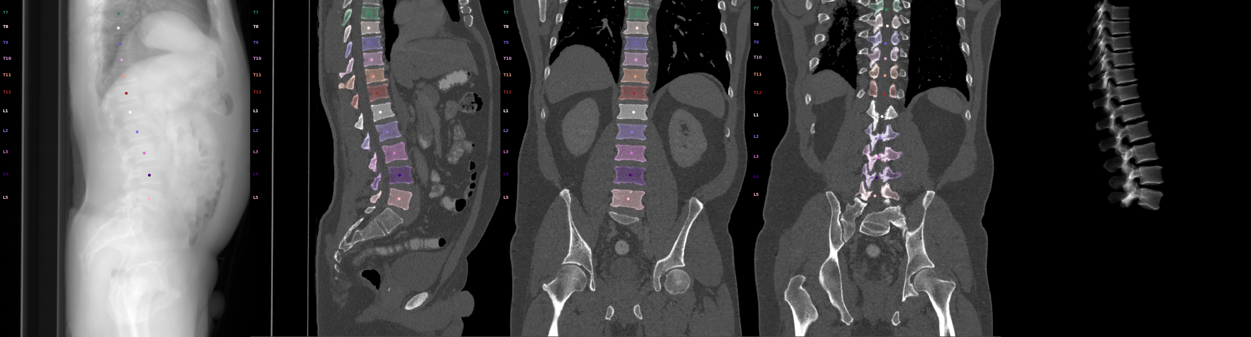
data/verse20/derivatives/sub-verse536/sub-verse536_dir-ax_seg-vert_snp.png
