LlamaLuLu/EEE4022S-AR-Spine-Registration/data/verse20/derivatives/sub-verse537/sub-verse537_dir-iso_seg-vert_snp.png

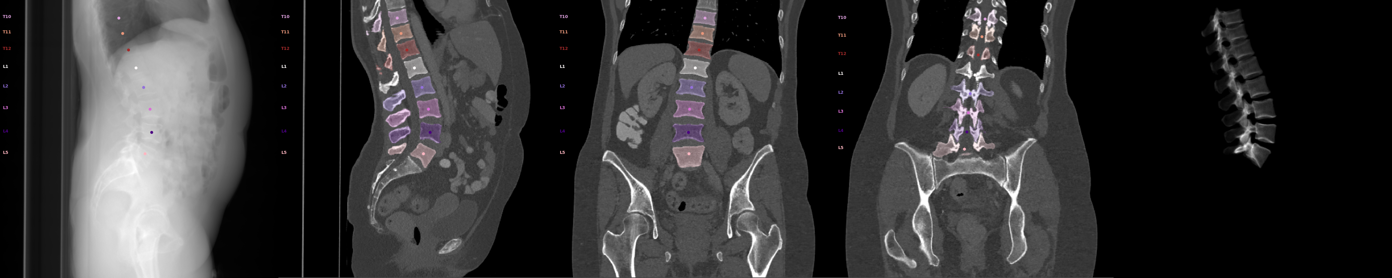
data/verse20/derivatives/sub-verse537/sub-verse537_dir-iso_seg-vert_snp.png
