LlamaLuLu/EEE4022S-AR-Spine-Registration/data/verse20/derivatives/sub-verse542/sub-verse542_dir-iso_seg-vert_snp.png

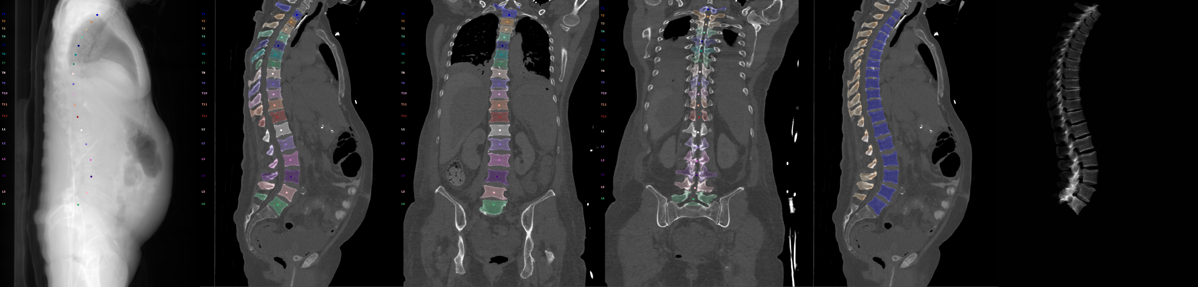
data/verse20/derivatives/sub-verse542/sub-verse542_dir-iso_seg-vert_snp.png
