LlamaLuLu/EEE4022S-AR-Spine-Registration/data/verse20/derivatives/sub-verse564/sub-verse564_dir-iso_seg-vert_snp.png

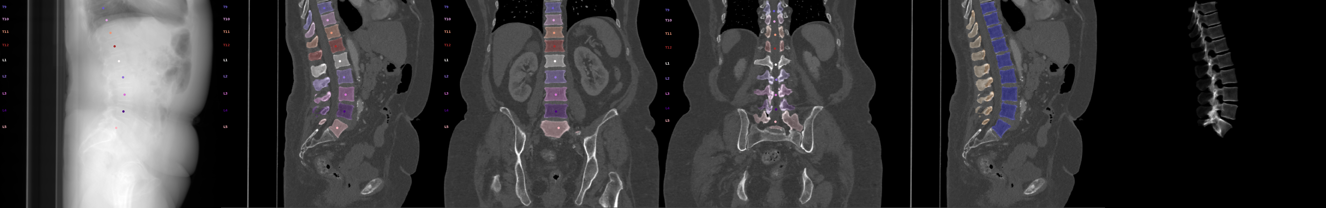
data/verse20/derivatives/sub-verse564/sub-verse564_dir-iso_seg-vert_snp.png
