LlamaLuLu/EEE4022S-AR-Spine-Registration/data/verse20/derivatives/sub-verse581/sub-verse581_dir-ax_seg-vert_snp.png

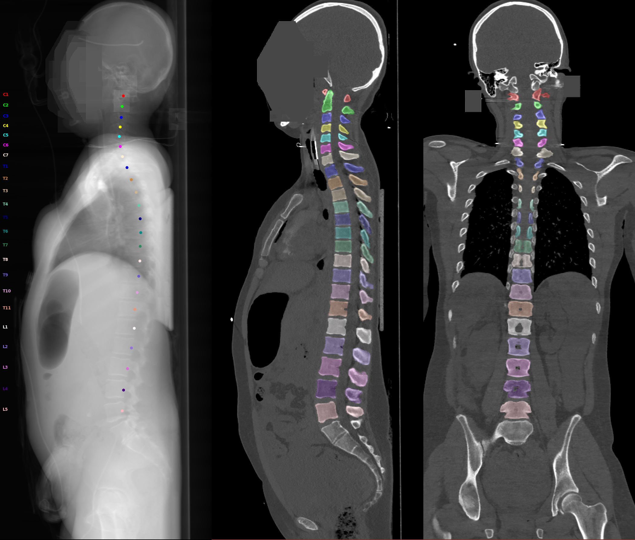
data/verse20/derivatives/sub-verse581/sub-verse581_dir-ax_seg-vert_snp.png
