LlamaLuLu/EEE4022S-AR-Spine-Registration/data/verse20/derivatives/sub-verse588/sub-verse588_seg-vert_snp.png

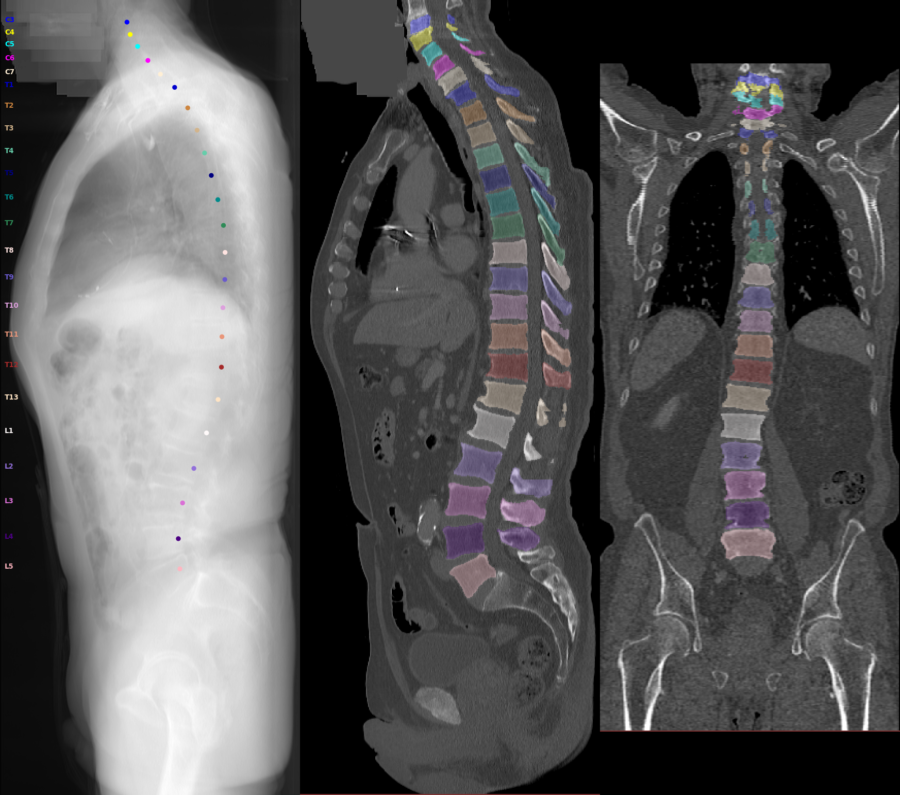
data/verse20/derivatives/sub-verse588/sub-verse588_seg-vert_snp.png
