LlamaLuLu/EEE4022S-AR-Spine-Registration/data/verse20/derivatives/sub-verse594/sub-verse594_dir-ax_seg-vert_snp.png

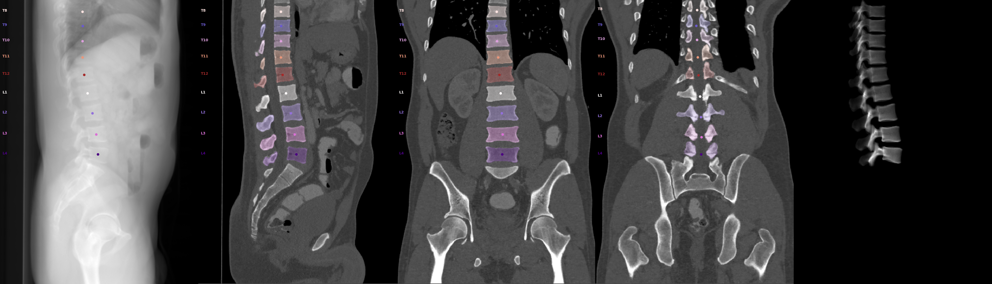
data/verse20/derivatives/sub-verse594/sub-verse594_dir-ax_seg-vert_snp.png
