LlamaLuLu/EEE4022S-AR-Spine-Registration/data/verse20/derivatives/sub-verse631/sub-verse631_seg-vert_snp.png

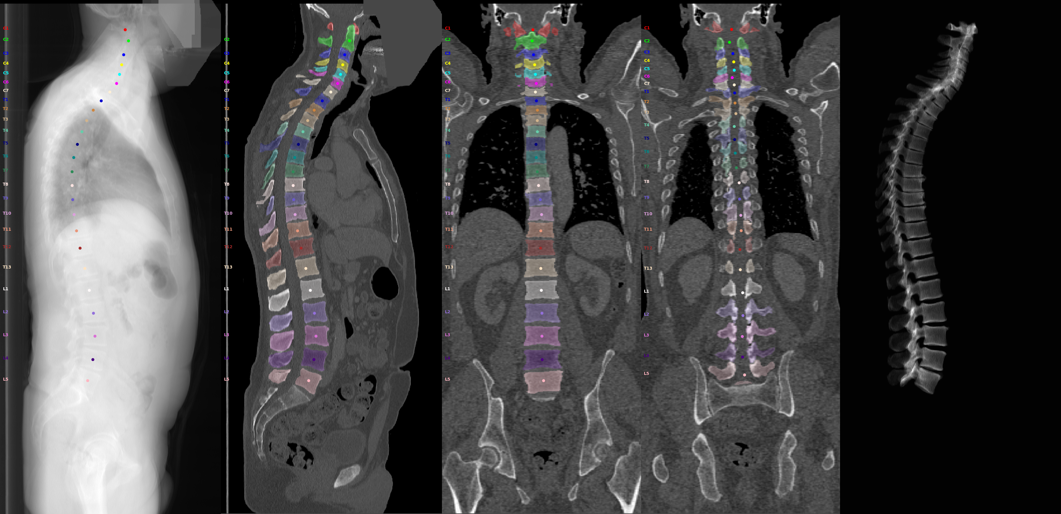
data/verse20/derivatives/sub-verse631/sub-verse631_seg-vert_snp.png
