LlamaLuLu/EEE4022S-AR-Spine-Registration/data/verse20/derivatives/sub-verse823/sub-verse823_dir-iso_seg-vert_snp.png

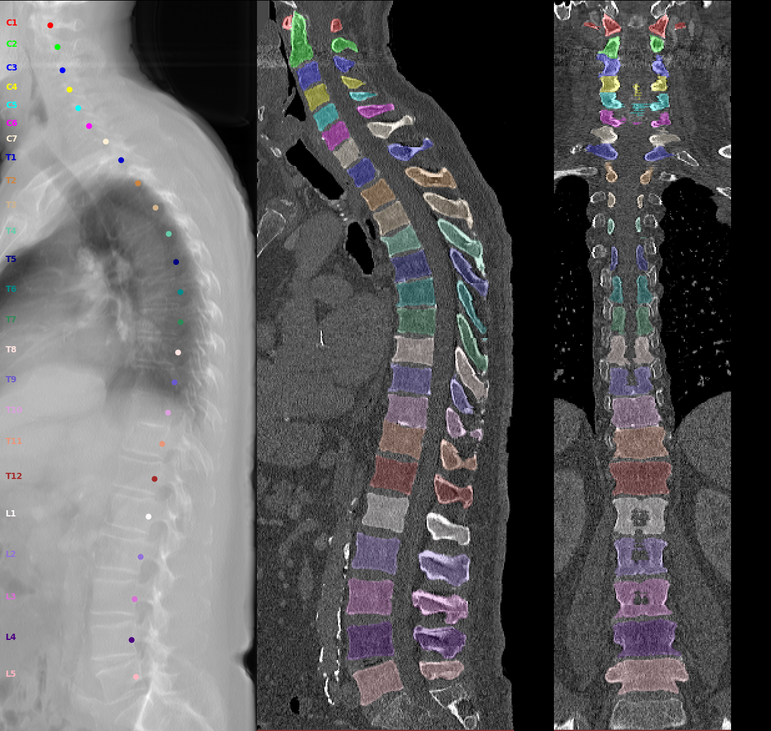
data/verse20/derivatives/sub-verse823/sub-verse823_dir-iso_seg-vert_snp.png
