LlamaLuLu/EEE4022S-AR-Spine-Registration/data/verse20/derivatives/sub-verse833/sub-verse833_dir-ax_seg-vert_snp.png

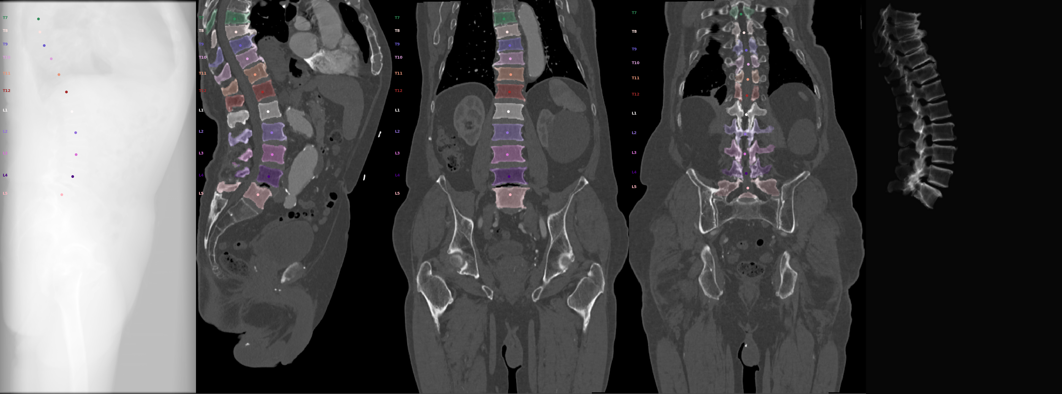
data/verse20/derivatives/sub-verse833/sub-verse833_dir-ax_seg-vert_snp.png
