LlamaLuLu/EEE4022S-AR-Spine-Registration/docs/figures/3d_slicer_view.png

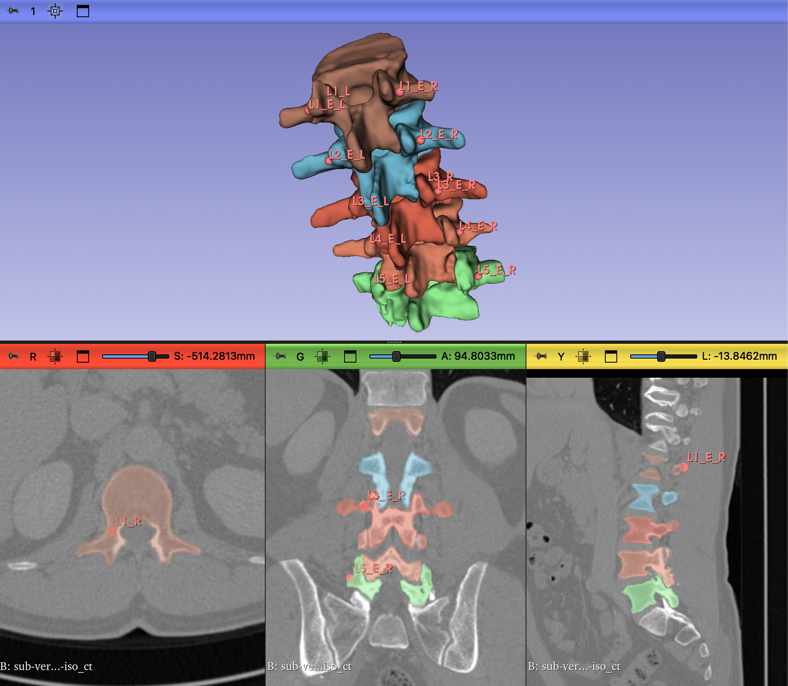
docs/figures/3d_slicer_view.png
