LlamaLuLu/EEE4022S-AR-Spine-Registration/docs/figures/baseplate_CAD.png

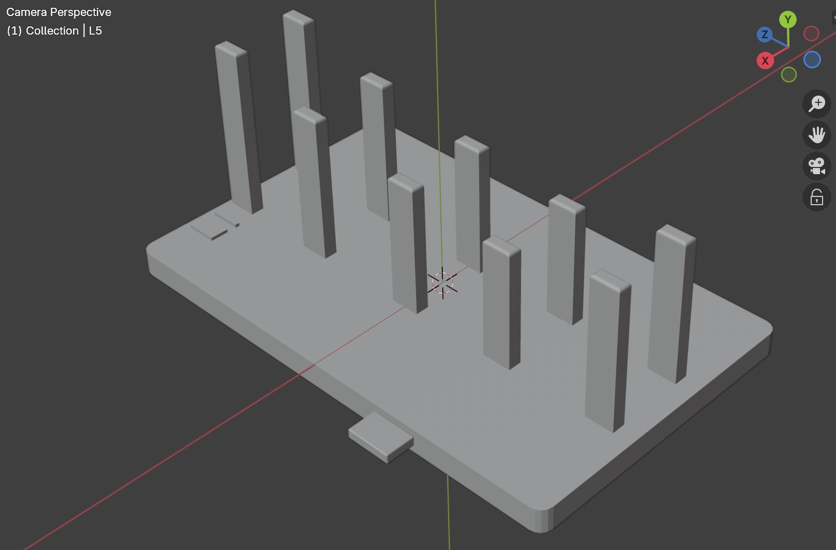
docs/figures/baseplate_CAD.png
