LlamaLuLu/EEE4022S-AR-Spine-Registration/docs/figures/fig_atp2_by_level.png

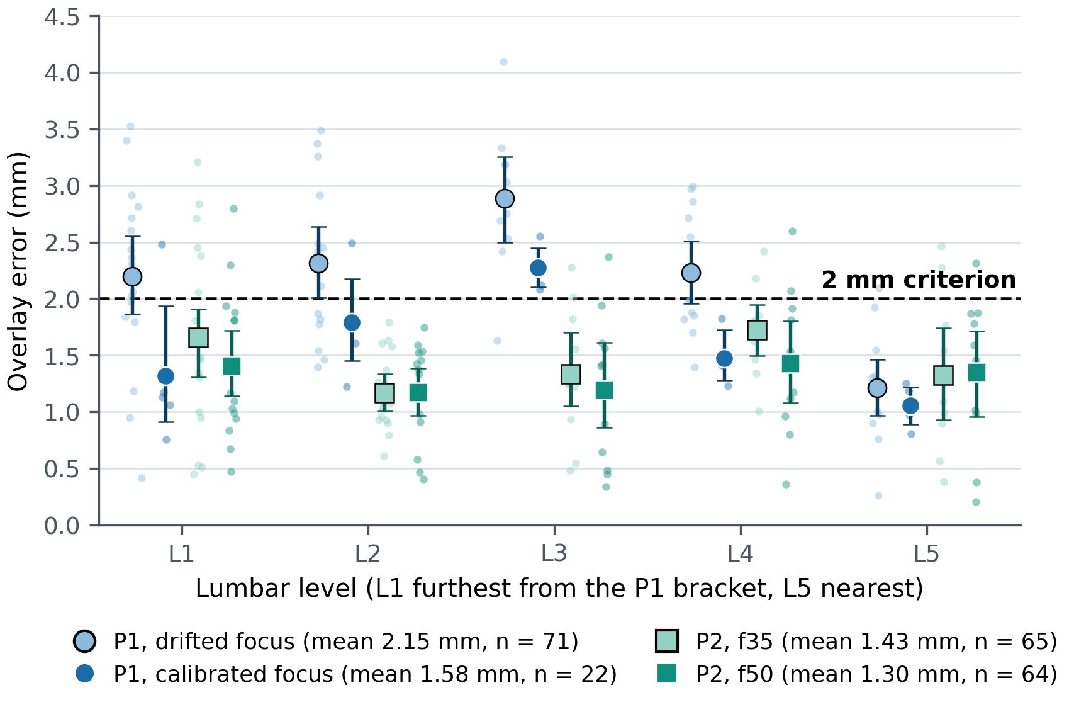
docs/figures/fig_atp2_by_level.png
