LlamaLuLu/EEE4022S-AR-Spine-Registration/docs/figures/fig_atp2_overlay_error.png

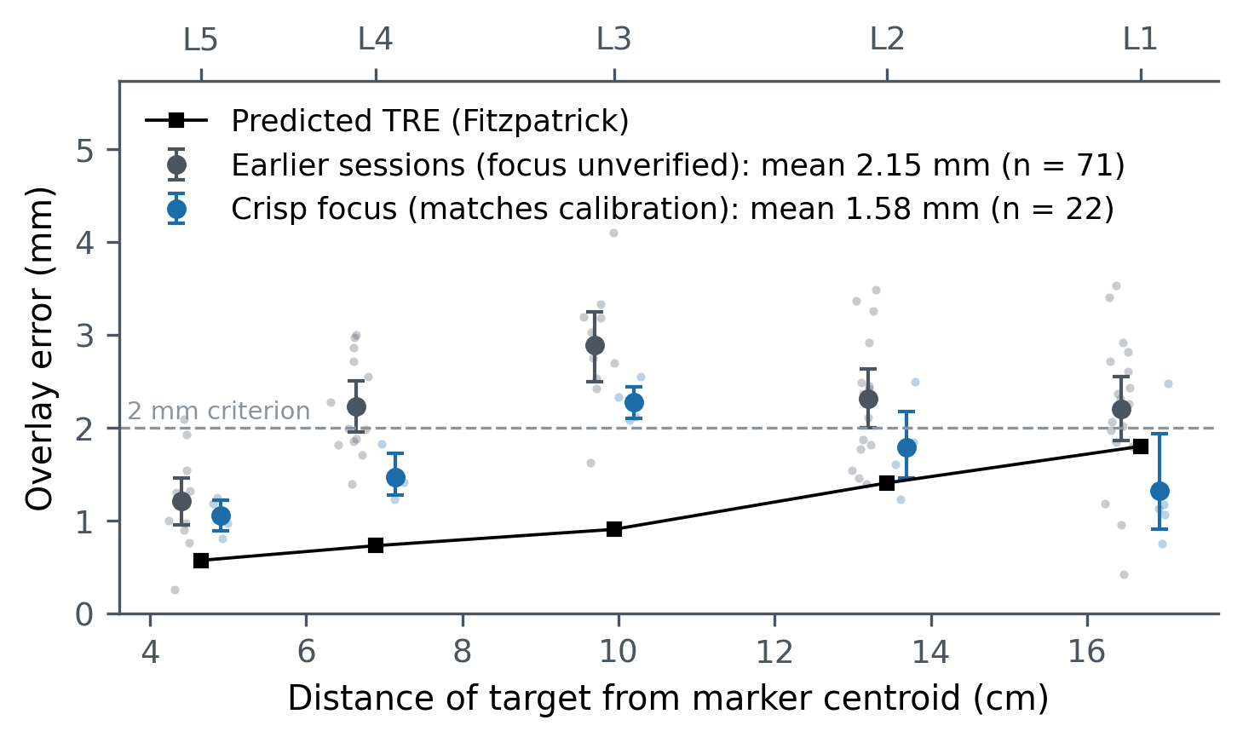
docs/figures/fig_atp2_overlay_error.png
