LlamaLuLu/EEE4022S-AR-Spine-Registration/docs/figures/fig_atp3_tracking.png

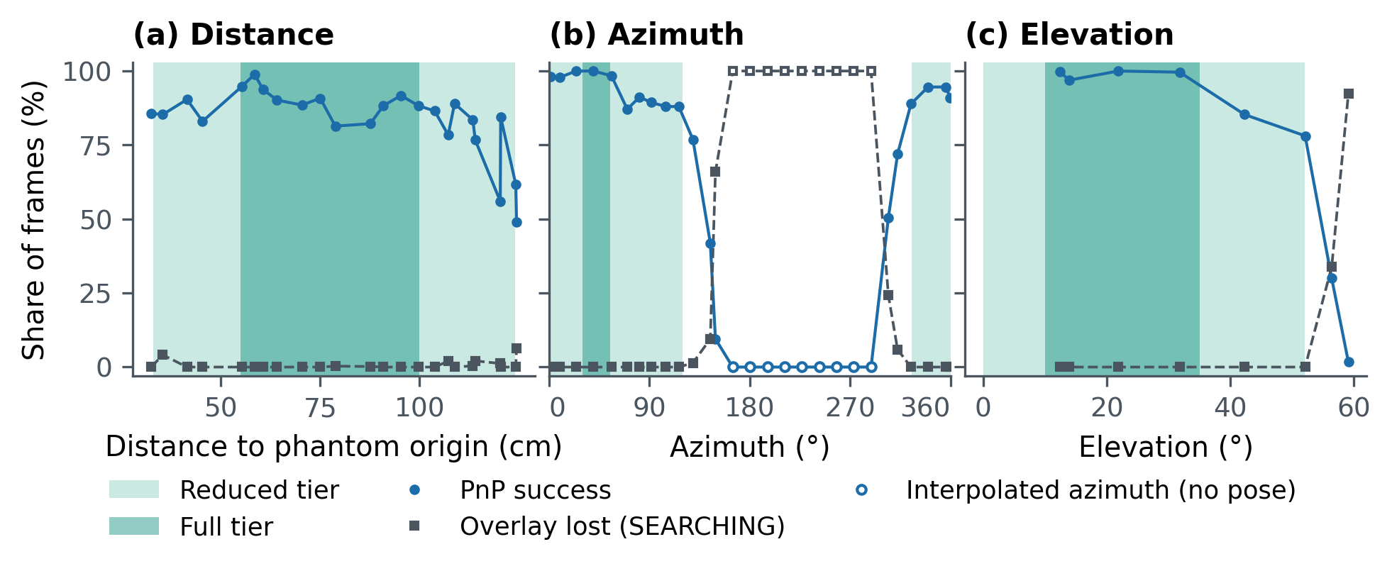
docs/figures/fig_atp3_tracking.png
