LlamaLuLu/EEE4022S-AR-Spine-Registration/docs/figures/fig_atp4_occlusion.png

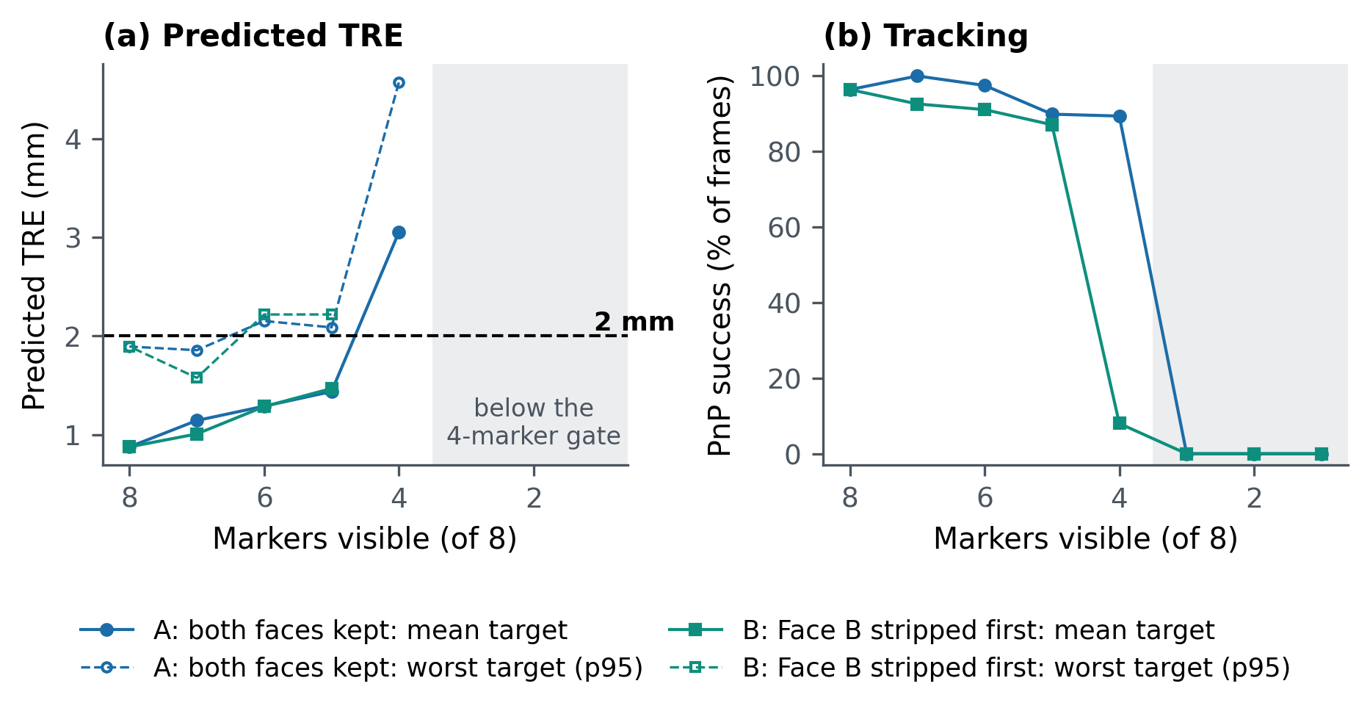
docs/figures/fig_atp4_occlusion.png
