LlamaLuLu/EEE4022S-AR-Spine-Registration/docs/figures/fig_atp6_timing.png

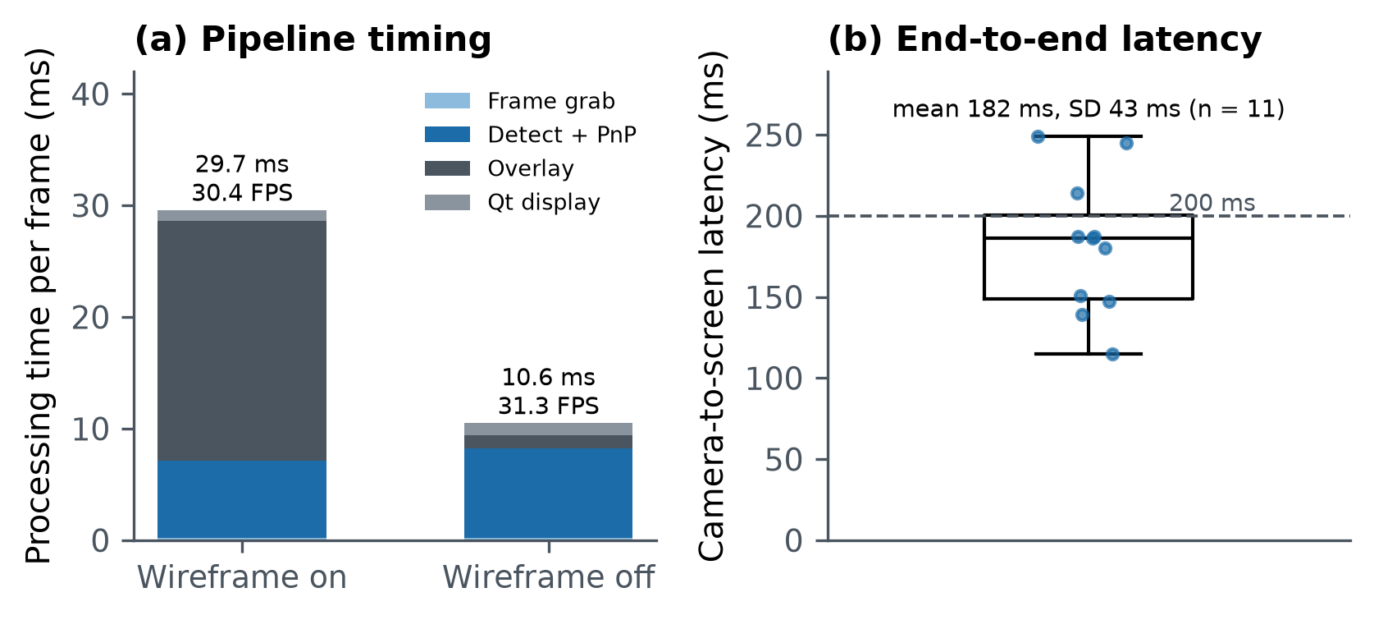
docs/figures/fig_atp6_timing.png
