LlamaLuLu/EEE4022S-AR-Spine-Registration/docs/figures/fig_calib_depth.png

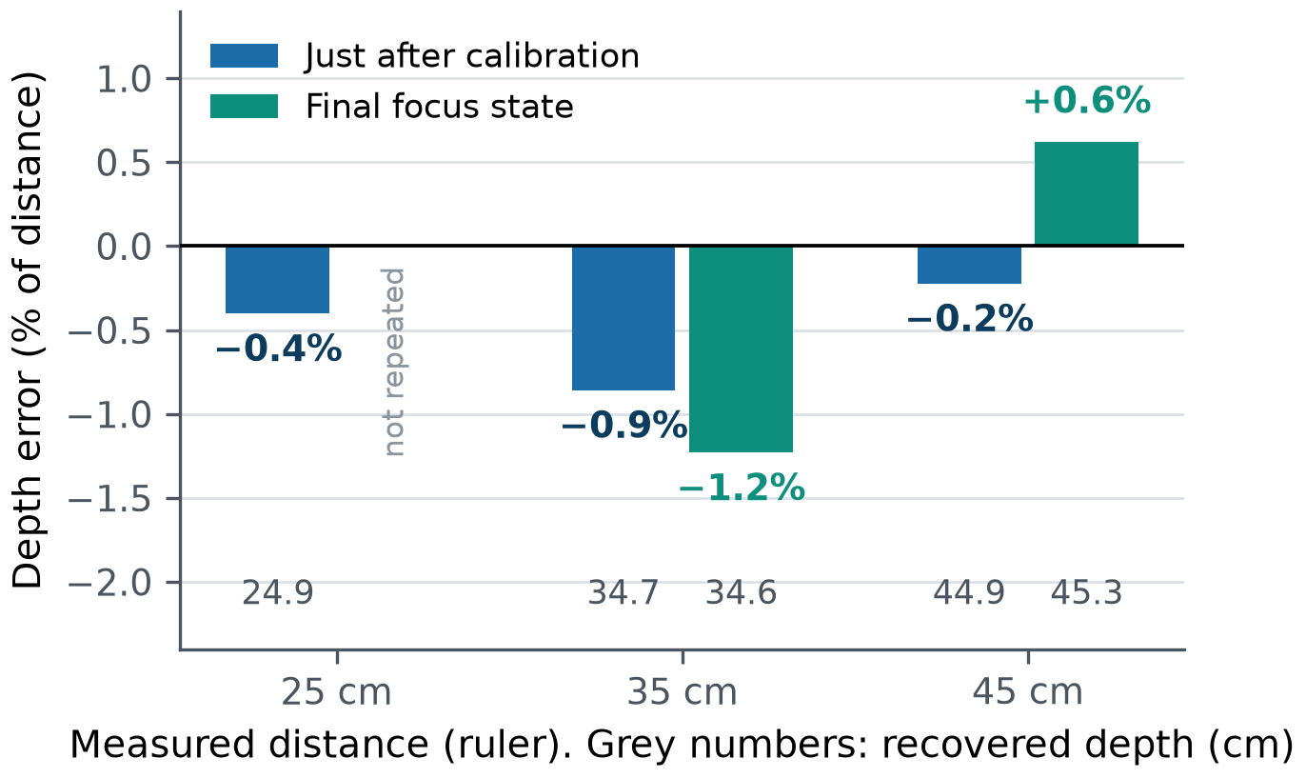
docs/figures/fig_calib_depth.png
