LlamaLuLu/EEE4022S-AR-Spine-Registration/docs/figures/fig_envelope_3d.png

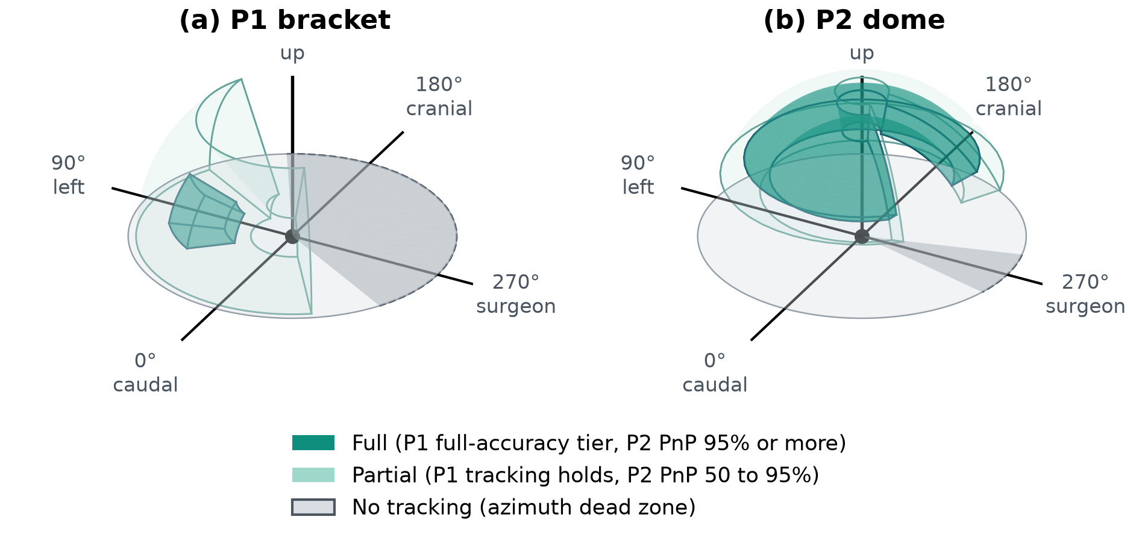
docs/figures/fig_envelope_3d.png
