LlamaLuLu/EEE4022S-AR-Spine-Registration/docs/figures/fig_envelope_diagram.png

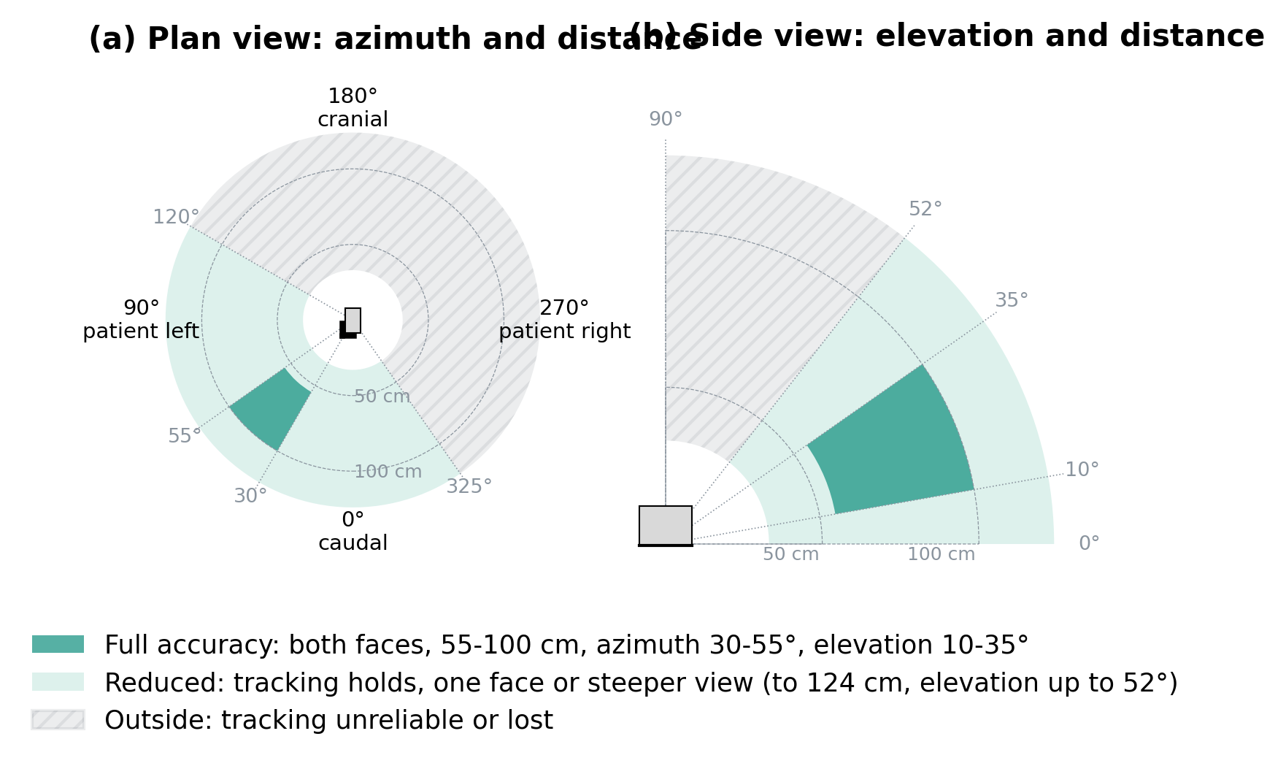
docs/figures/fig_envelope_diagram.png
