LlamaLuLu/EEE4022S-AR-Spine-Registration/docs/figures/fig_envelope_p1p2.png

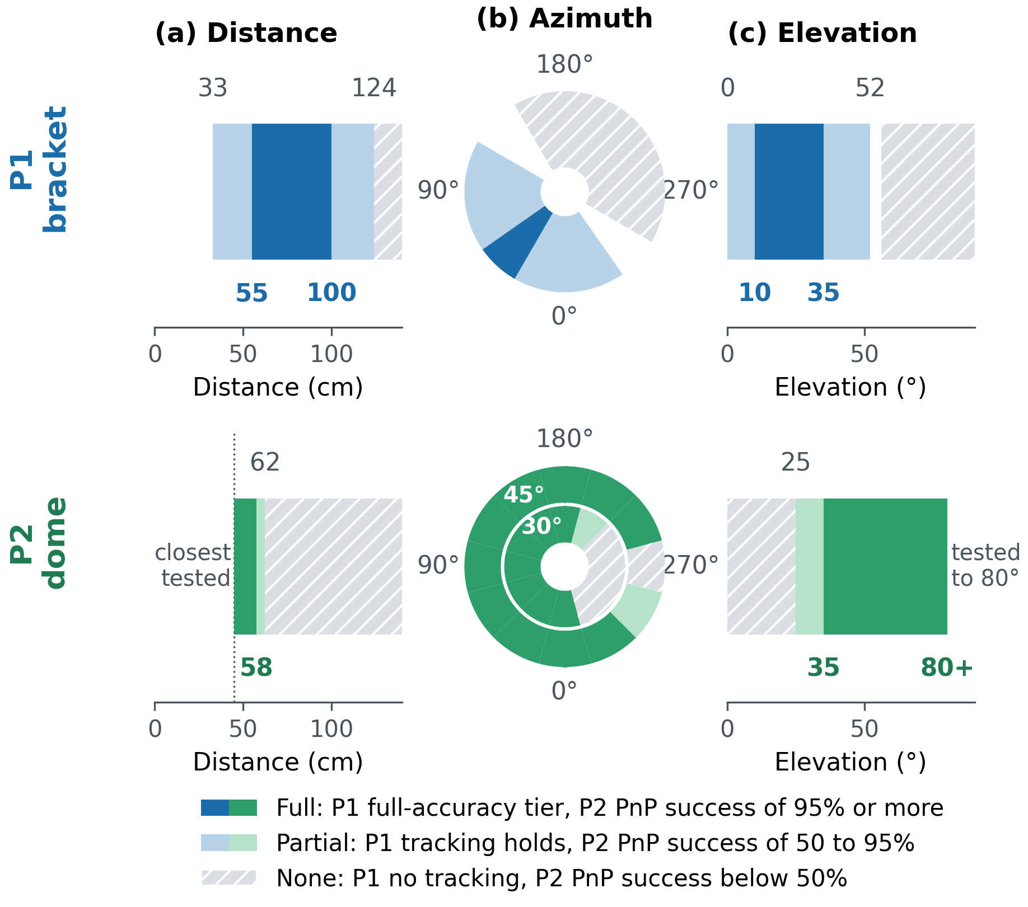
docs/figures/fig_envelope_p1p2.png
