LlamaLuLu/EEE4022S-AR-Spine-Registration/docs/figures/fig_error_budget.png

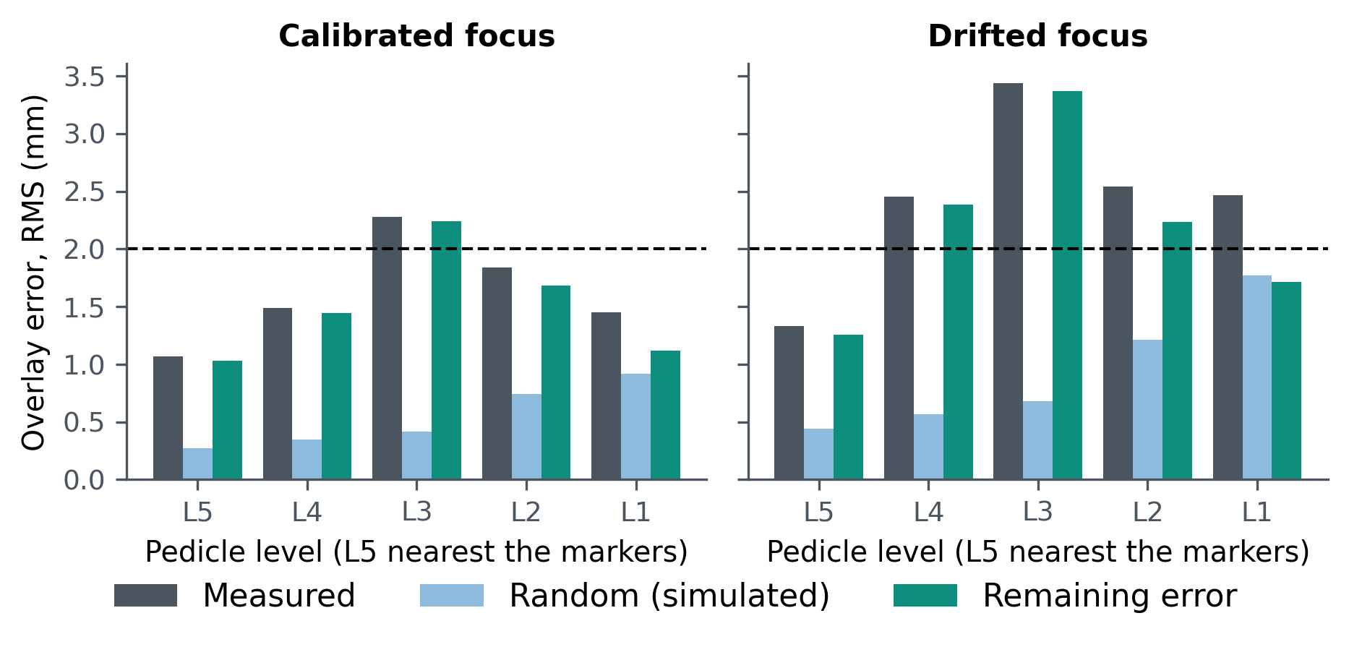
docs/figures/fig_error_budget.png
