LlamaLuLu/EEE4022S-AR-Spine-Registration/docs/figures/fig_method_mcflow.png

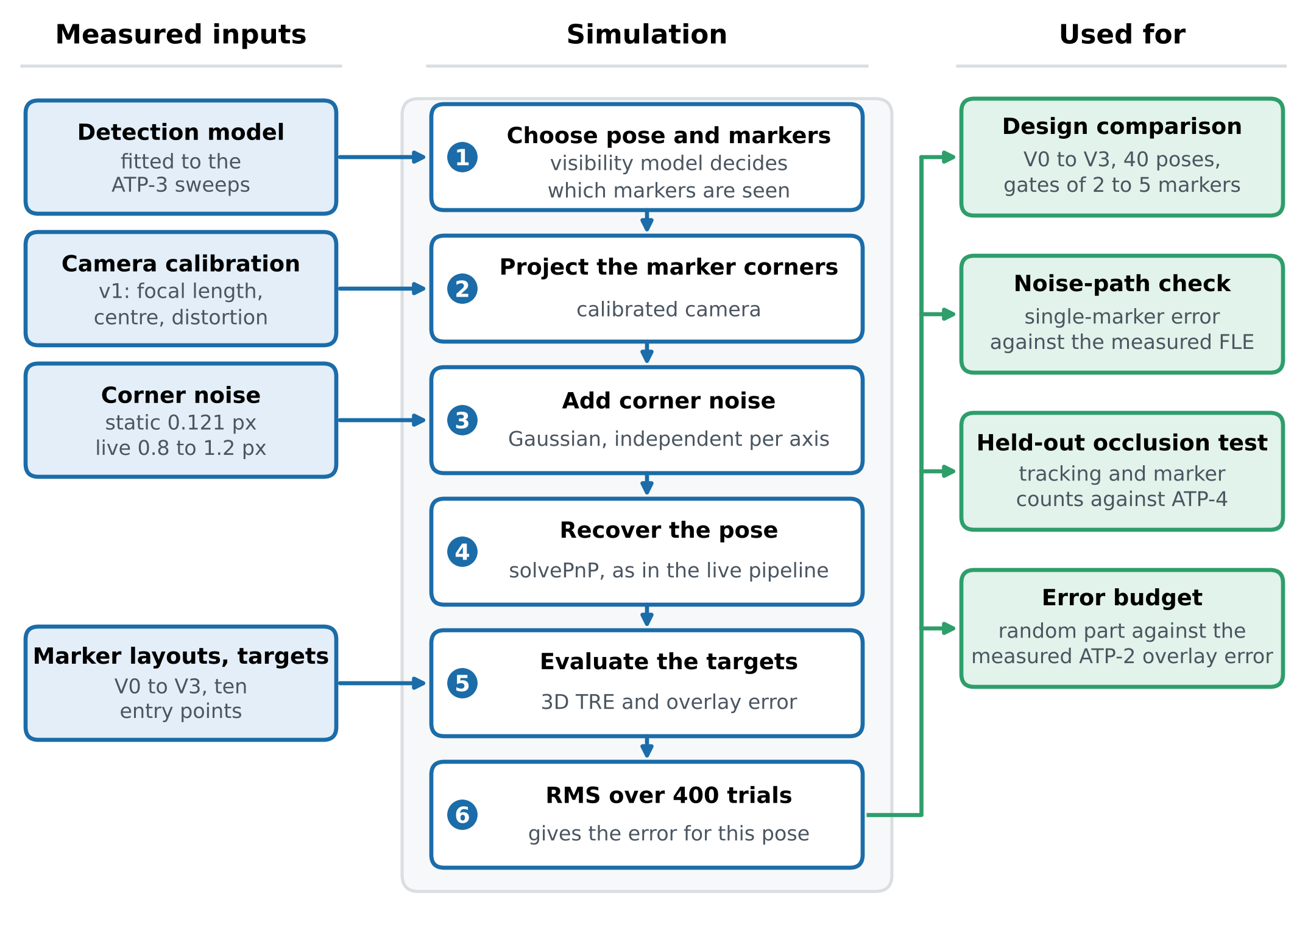
docs/figures/fig_method_mcflow.png
