LlamaLuLu/EEE4022S-AR-Spine-Registration/docs/figures/fig_method_states.png

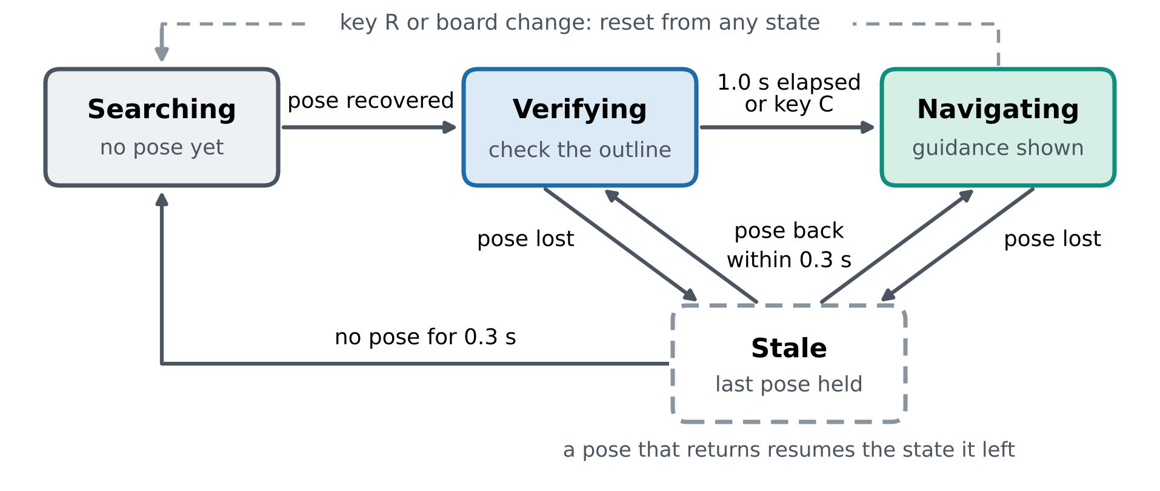
docs/figures/fig_method_states.png
