LlamaLuLu/EEE4022S-AR-Spine-Registration/docs/figures/fig_method_variants.png

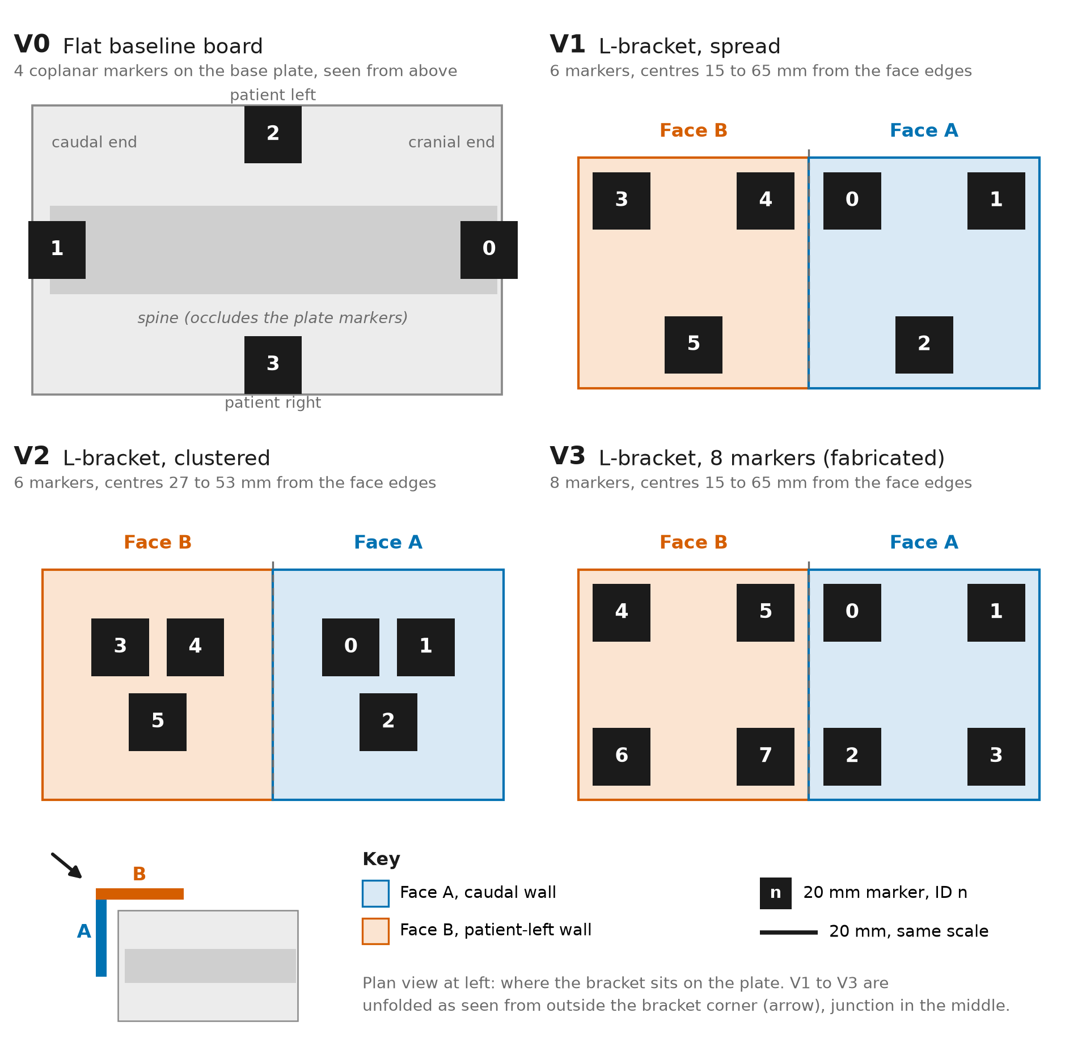
docs/figures/fig_method_variants.png
