LlamaLuLu/EEE4022S-AR-Spine-Registration/docs/figures/fig_method_visibility_row.png

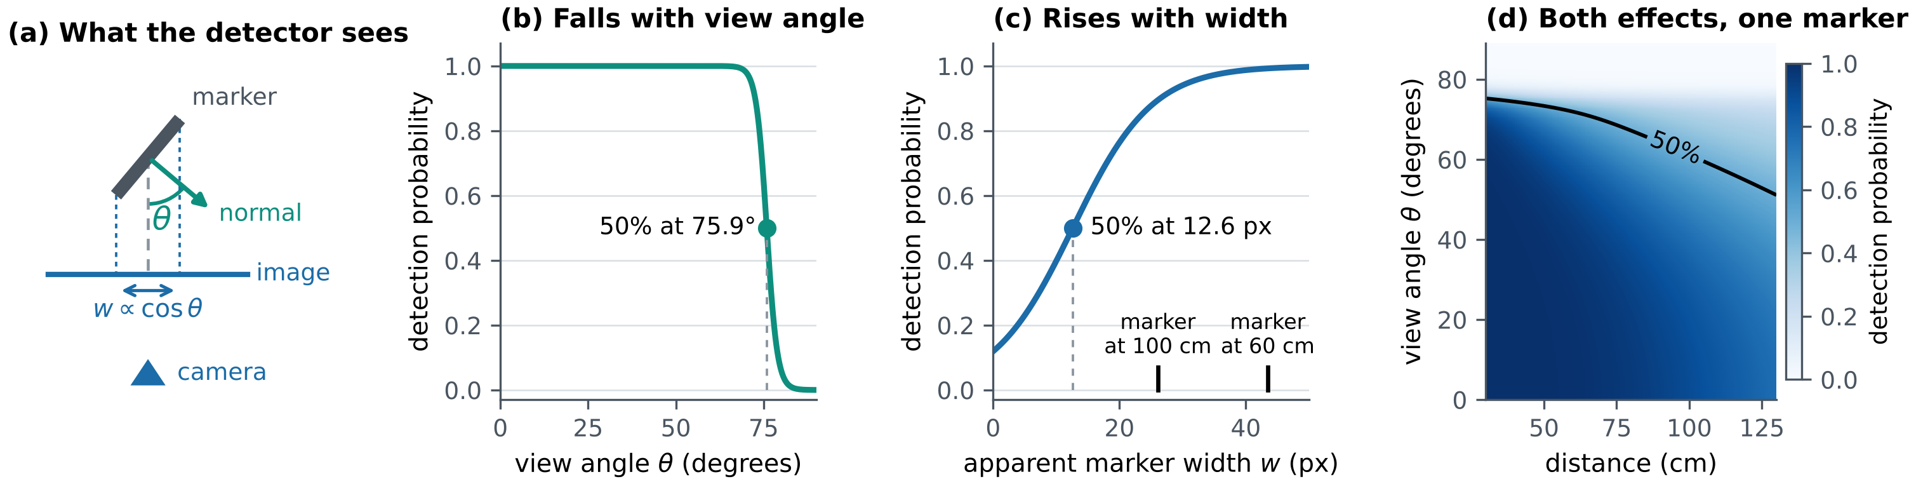
docs/figures/fig_method_visibility_row.png
