LlamaLuLu/EEE4022S-AR-Spine-Registration/docs/figures/fig_p2_range.png

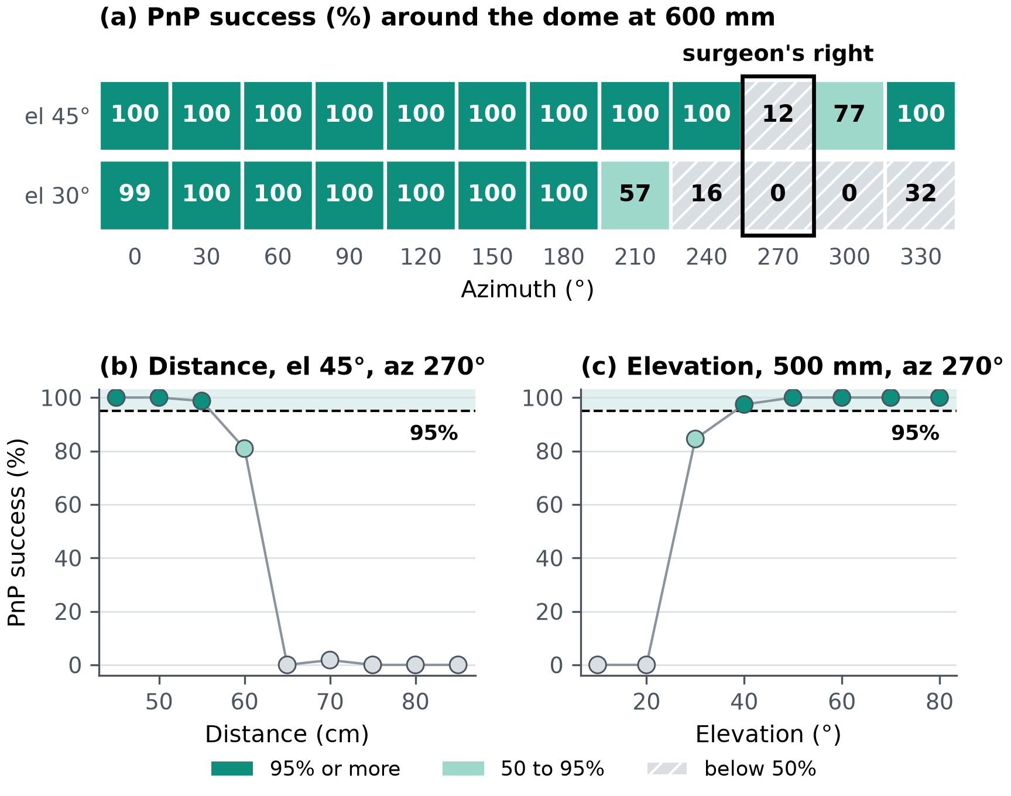
docs/figures/fig_p2_range.png
