LlamaLuLu/EEE4022S-AR-Spine-Registration/docs/figures/fig_p2_range_row.png

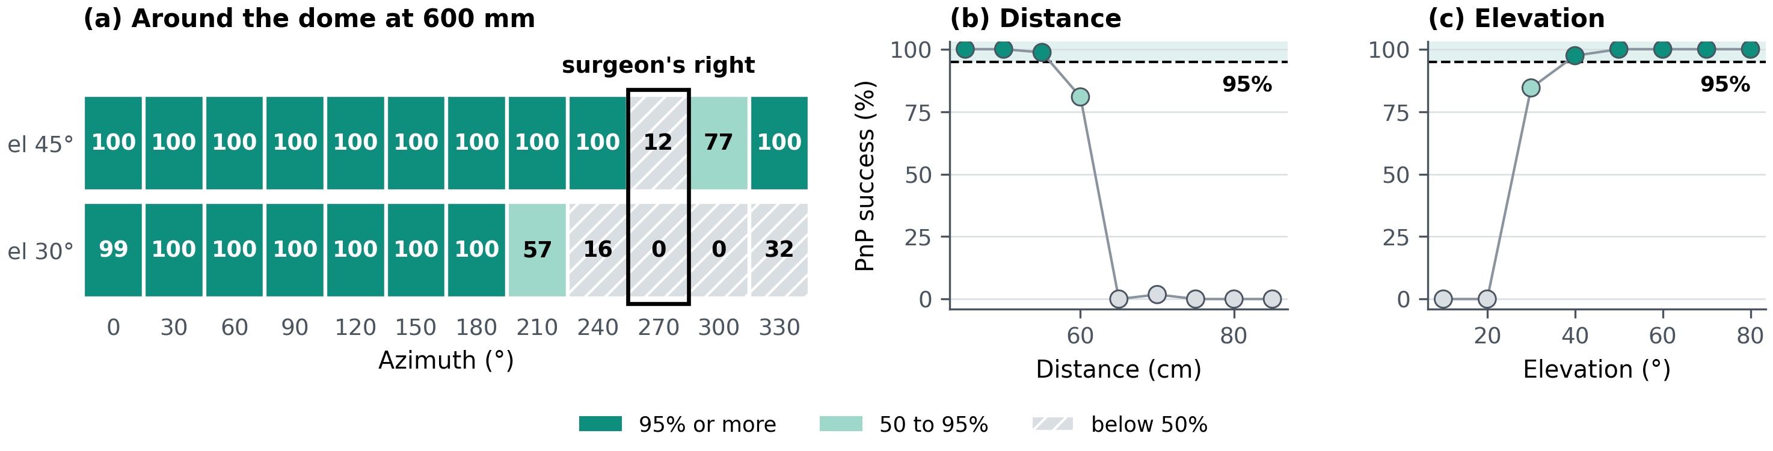
docs/figures/fig_p2_range_row.png
