LlamaLuLu/EEE4022S-AR-Spine-Registration/docs/figures/fig_sweep_grids.png

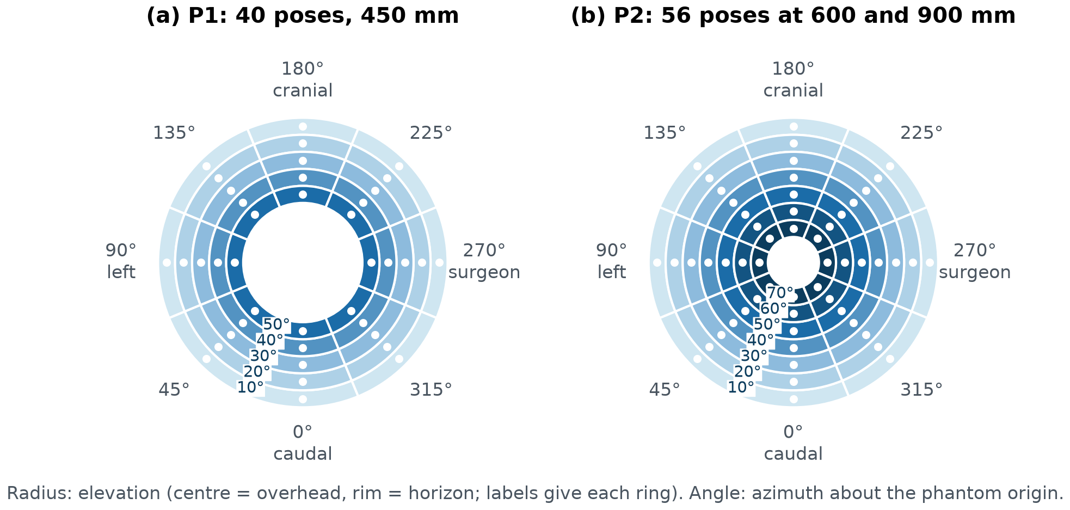
docs/figures/fig_sweep_grids.png
