LlamaLuLu/EEE4022S-AR-Spine-Registration/docs/figures/fig_tier_comparison.png

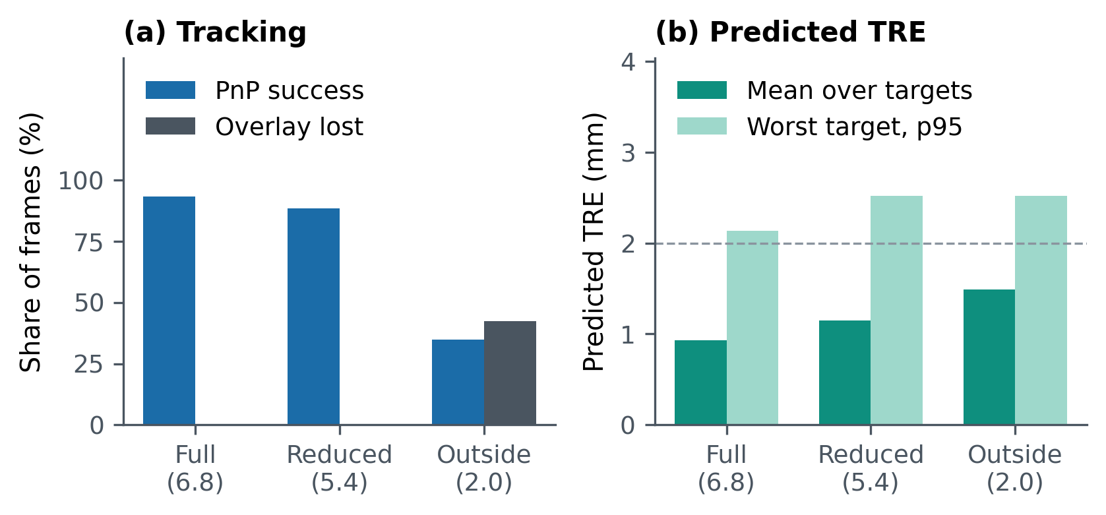
docs/figures/fig_tier_comparison.png
