LlamaLuLu/EEE4022S-AR-Spine-Registration/docs/figures/lit_accuracy_landscape.png

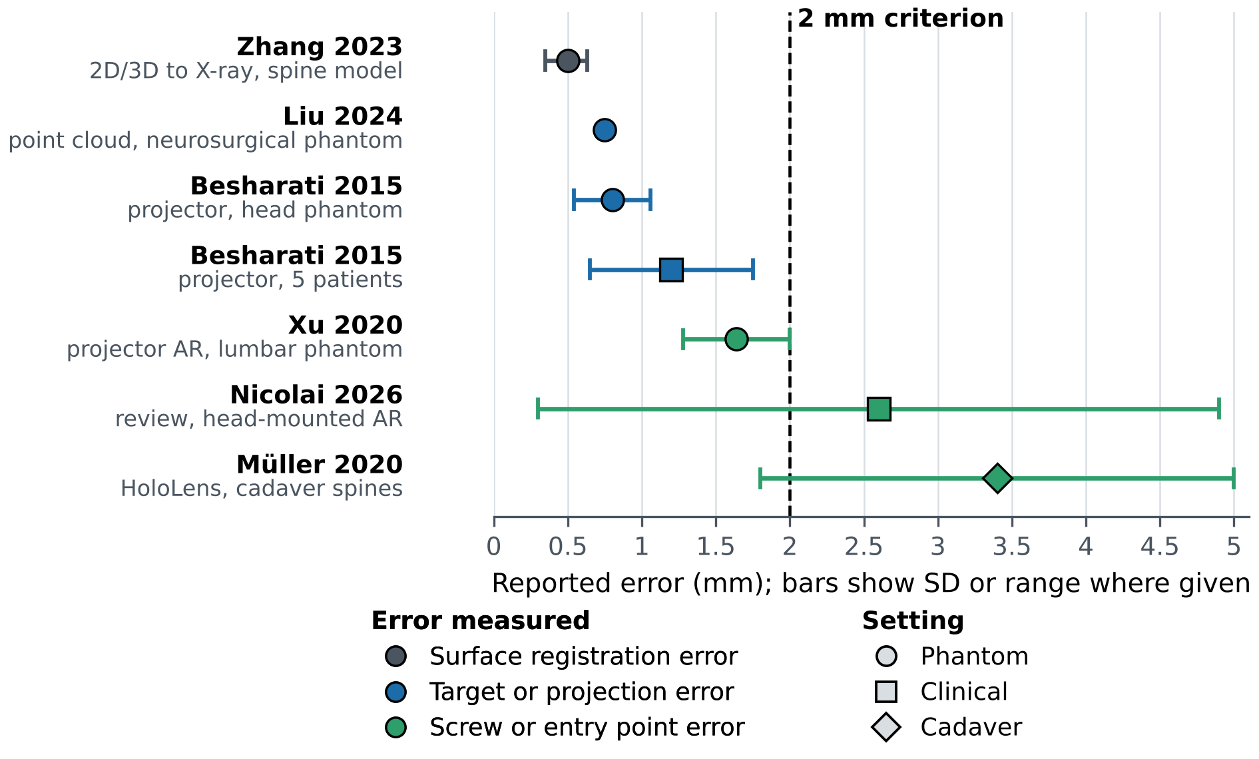
docs/figures/lit_accuracy_landscape.png
