LlamaLuLu/EEE4022S-AR-Spine-Registration/docs/figures/lit_fre_tre_layout.png

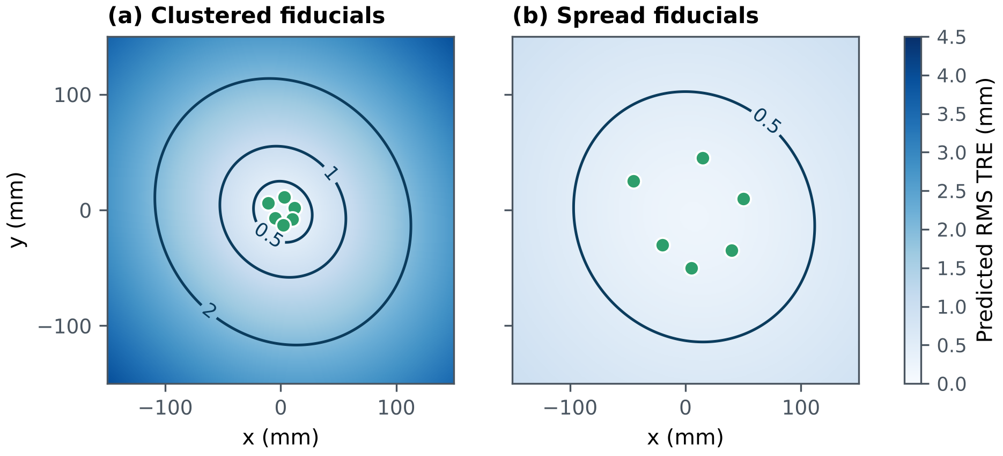
docs/figures/lit_fre_tre_layout.png
