LlamaLuLu/EEE4022S-AR-Spine-Registration/docs/figures/lit_registration_taxonomy.png

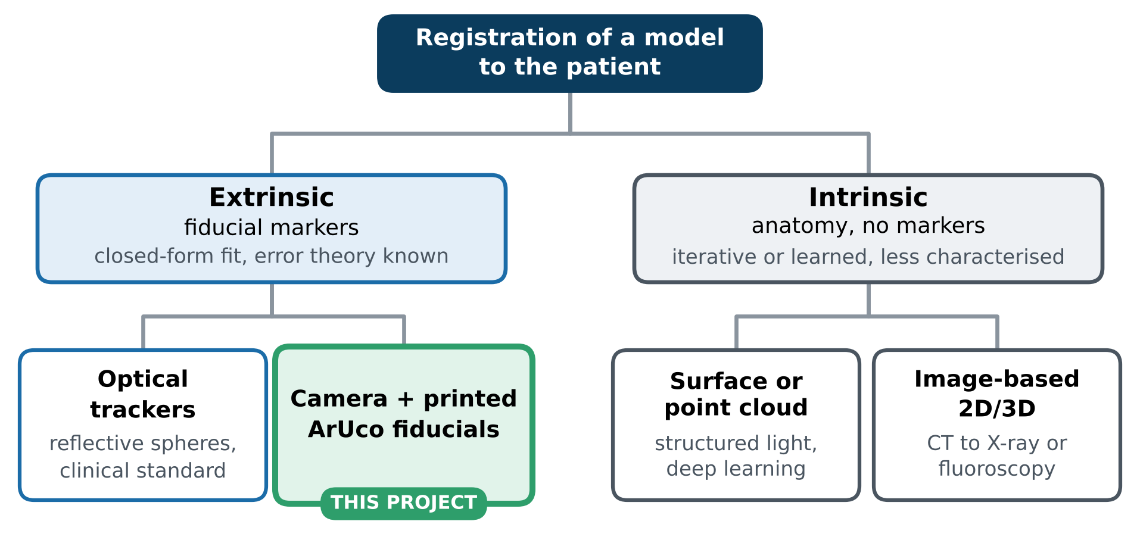
docs/figures/lit_registration_taxonomy.png
