LlamaLuLu/EEE4022S-AR-Spine-Registration/docs/figures/marker_page_p2.png

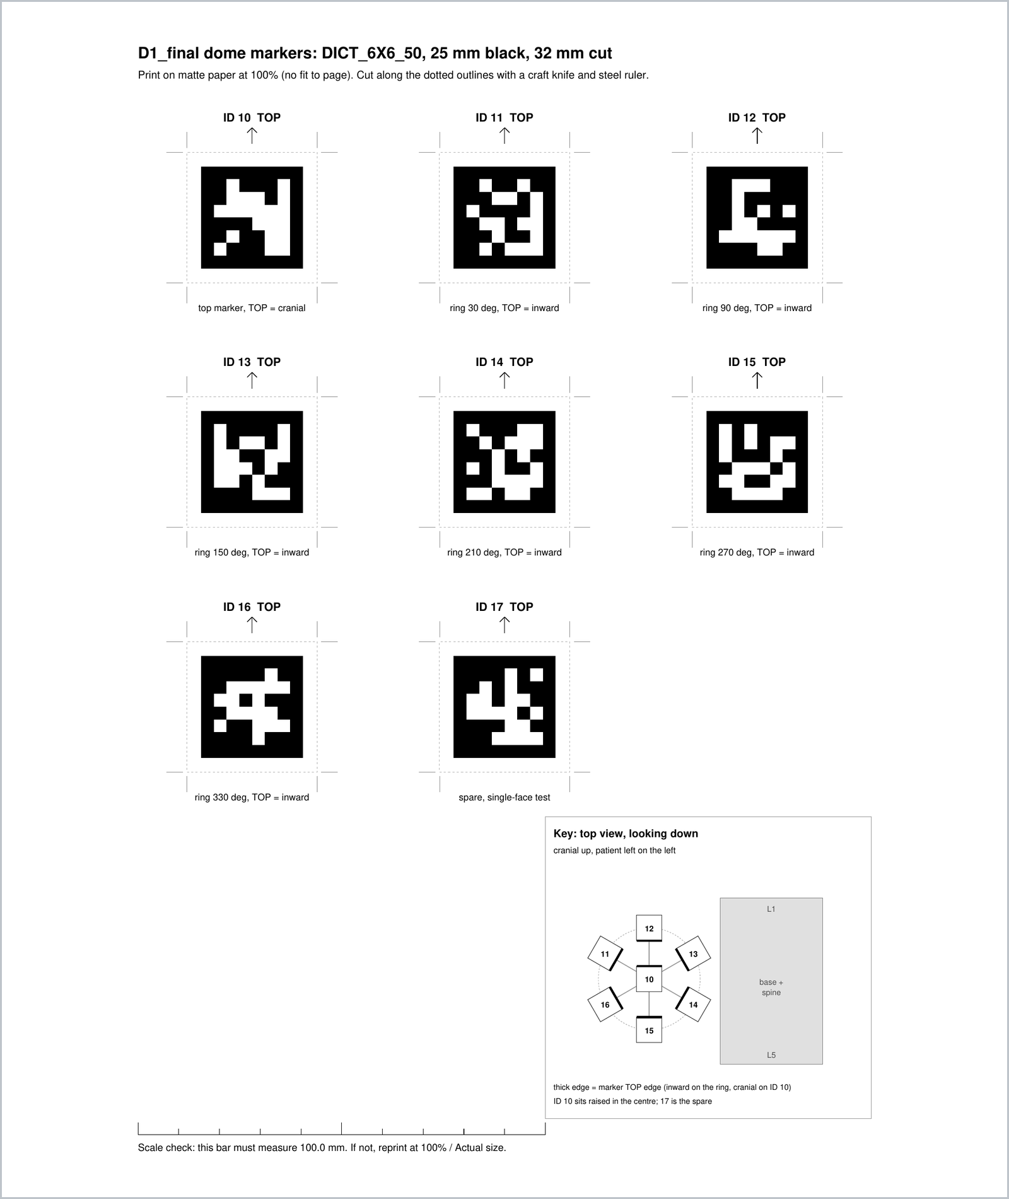
docs/figures/marker_page_p2.png
