LlamaLuLu/EEE4022S-AR-Spine-Registration/docs/figures/method_architecture.png

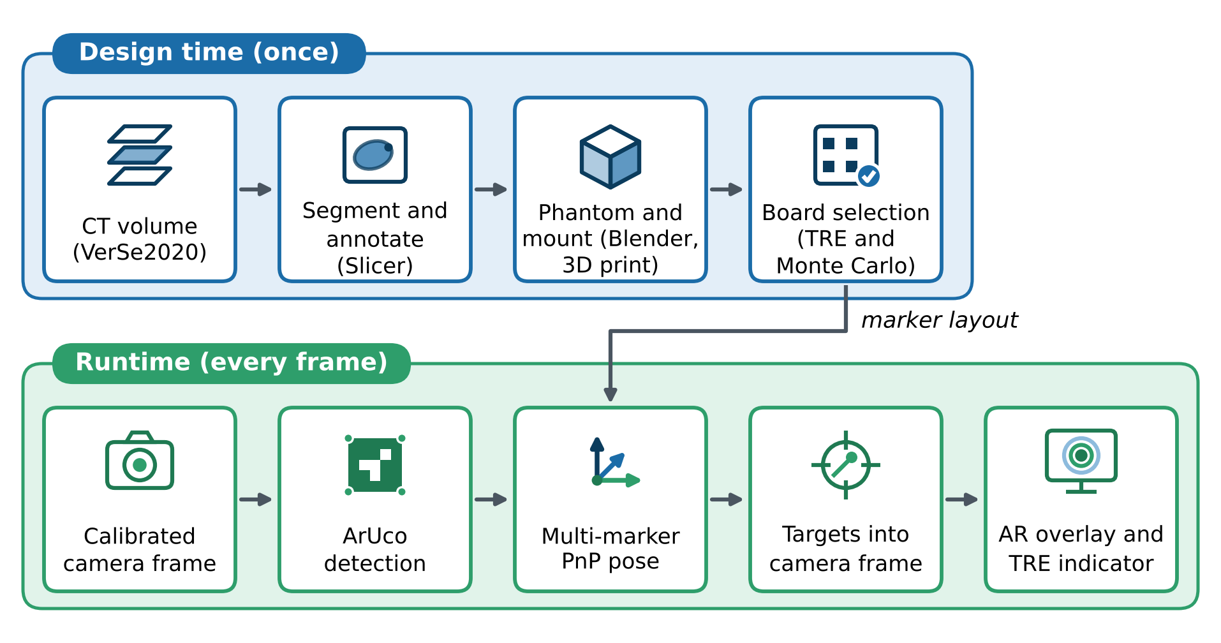
docs/figures/method_architecture.png
