LlamaLuLu/EEE4022S-AR-Spine-Registration/docs/figures/method_cycles.png

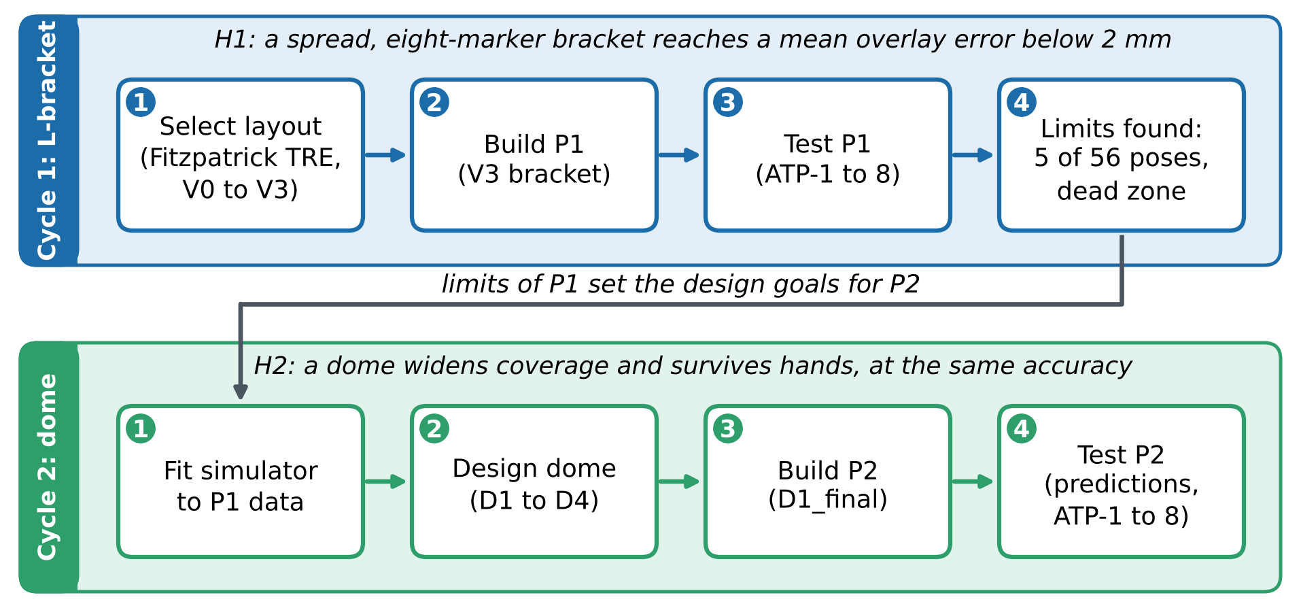
docs/figures/method_cycles.png
