LlamaLuLu/EEE4022S-AR-Spine-Registration/docs/figures/pedicle_dots1.jpeg

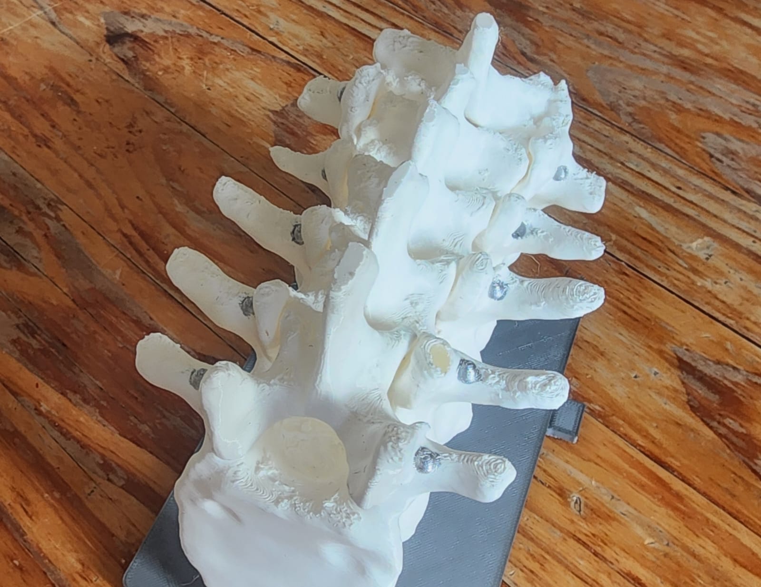
docs/figures/pedicle_dots1.jpeg
