LlamaLuLu/EEE4022S-AR-Spine-Registration/docs/figures/phantom+baseplate_CAD.png

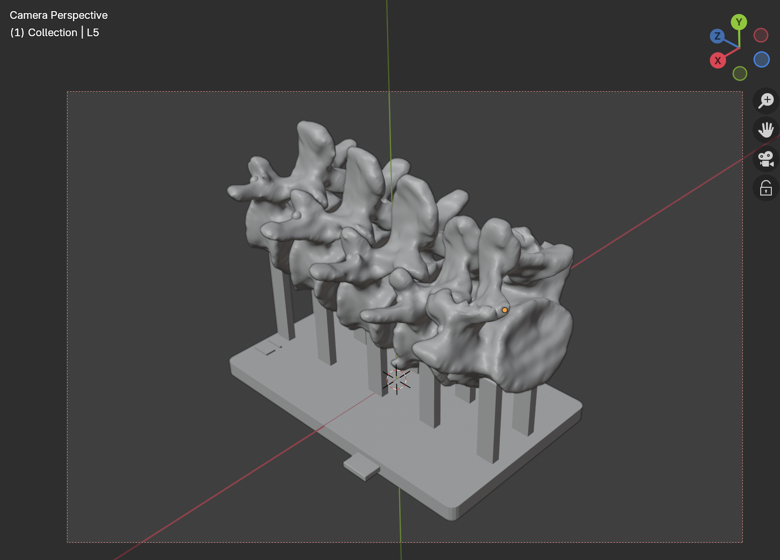
docs/figures/phantom+baseplate_CAD.png
