LlamaLuLu/EEE4022S-AR-Spine-Registration/phantom/dome_top_view.png

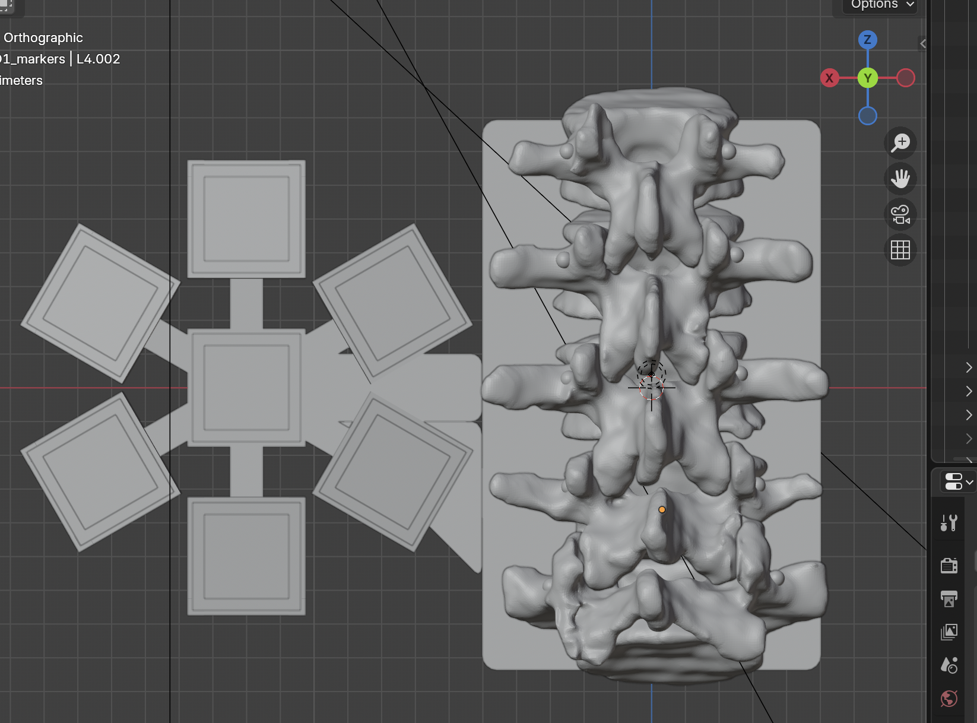
phantom/dome_top_view.png
