LlamaLuLu/EEE4022S-AR-Spine-Registration/phantom/meshes/marker_variations/variation0.png

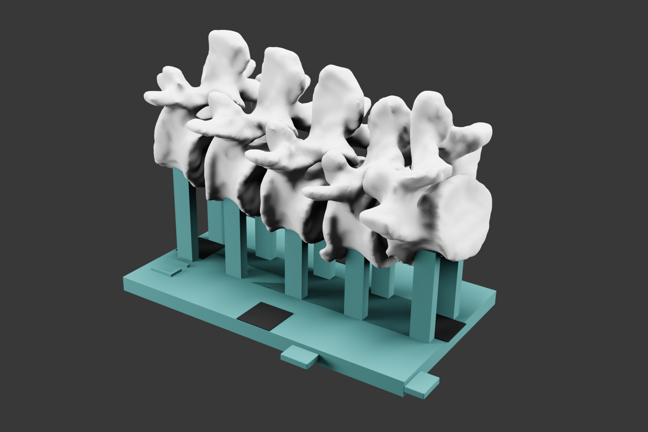
phantom/meshes/marker_variations/variation0.png
