LlamaLuLu/EEE4022S-AR-Spine-Registration/phantom/meshes/marker_variations/variation1.png

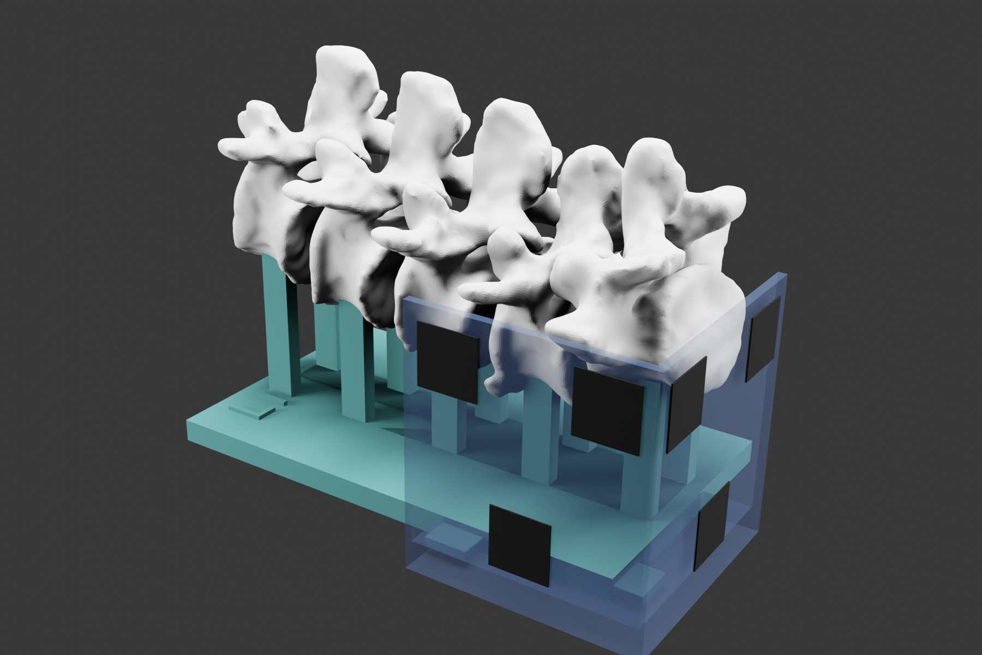
phantom/meshes/marker_variations/variation1.png
