LlamaLuLu/EEE4022S-AR-Spine-Registration/phantom/phantom_v1.1.png

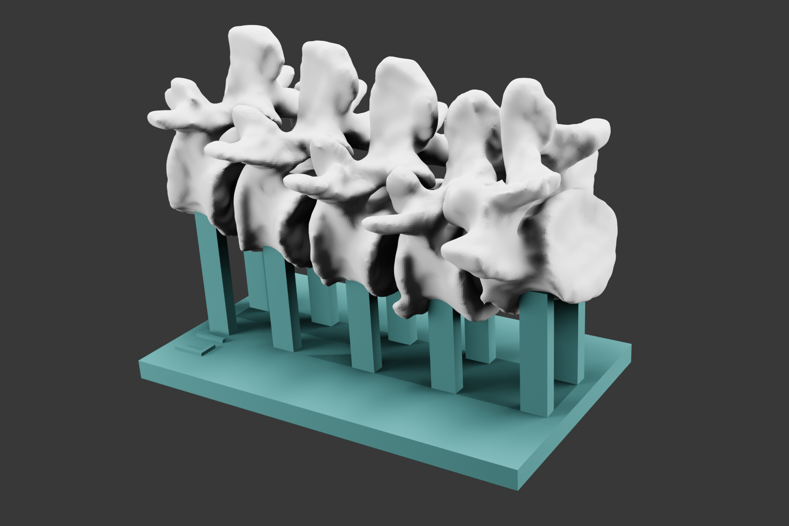
phantom/phantom_v1.1.png
