LlamaLuLu/EEE4022S-AR-Spine-Registration/phantom/phantom_v2.1.png

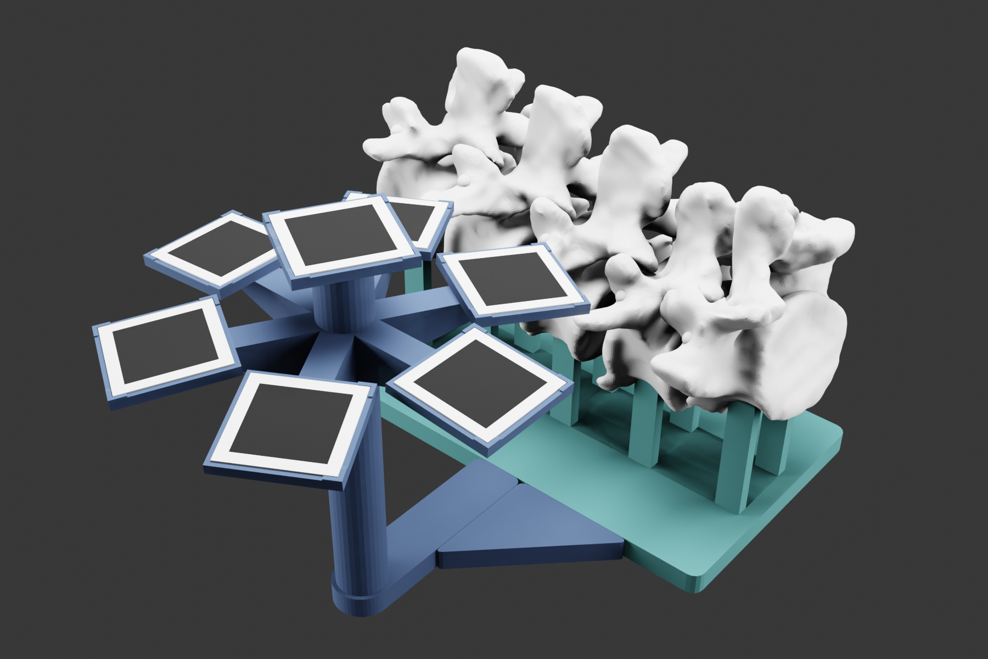
phantom/phantom_v2.1.png
