LlamaLuLu/EEE4022S-AR-Spine-Registration/phantom/phaontom_v1.png

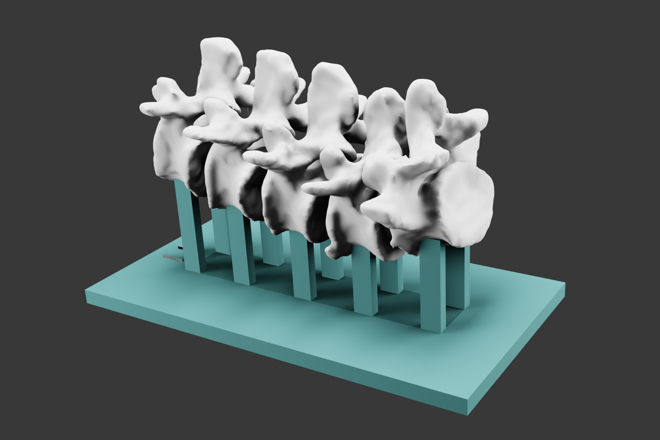
phantom/phaontom_v1.png
