LlamaLuLu/EEE4022S-AR-Spine-Registration/phantom/renders/dome_front_view.png

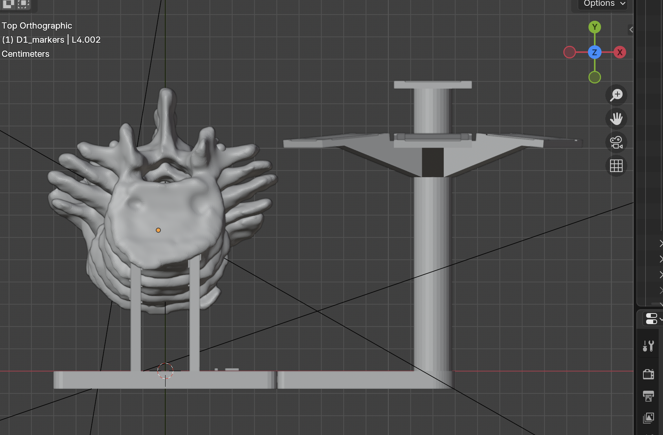
phantom/renders/dome_front_view.png
