LlamaLuLu/EEE4022S-AR-Spine-Registration/phantom/renders/phantom+baseplate.png

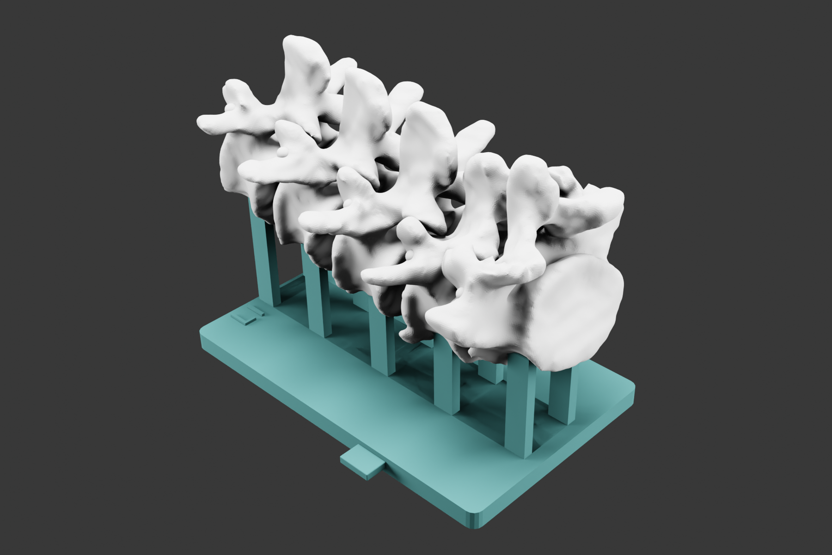
phantom/renders/phantom+baseplate.png
