LlamaLuLu/EEE4022S-AR-Spine-Registration/phantom/renders/phantom_v1.2-1.png

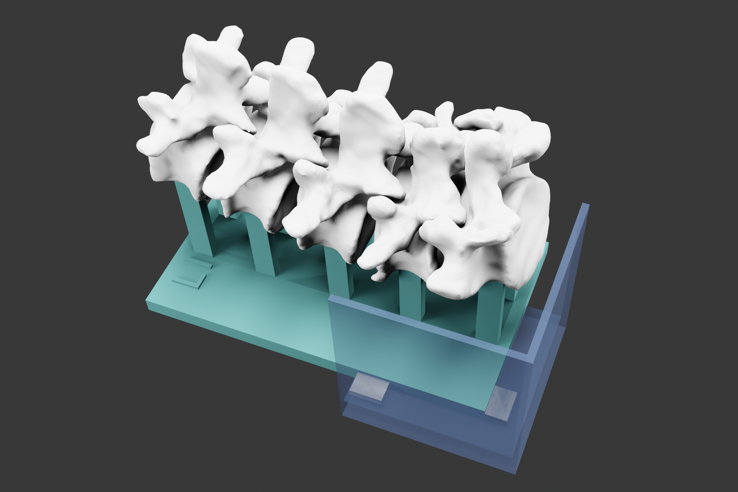
phantom/renders/phantom_v1.2-1.png
