LlamaLuLu/EEE4022S-AR-Spine-Registration/phantom/full_model_v0.2.stl

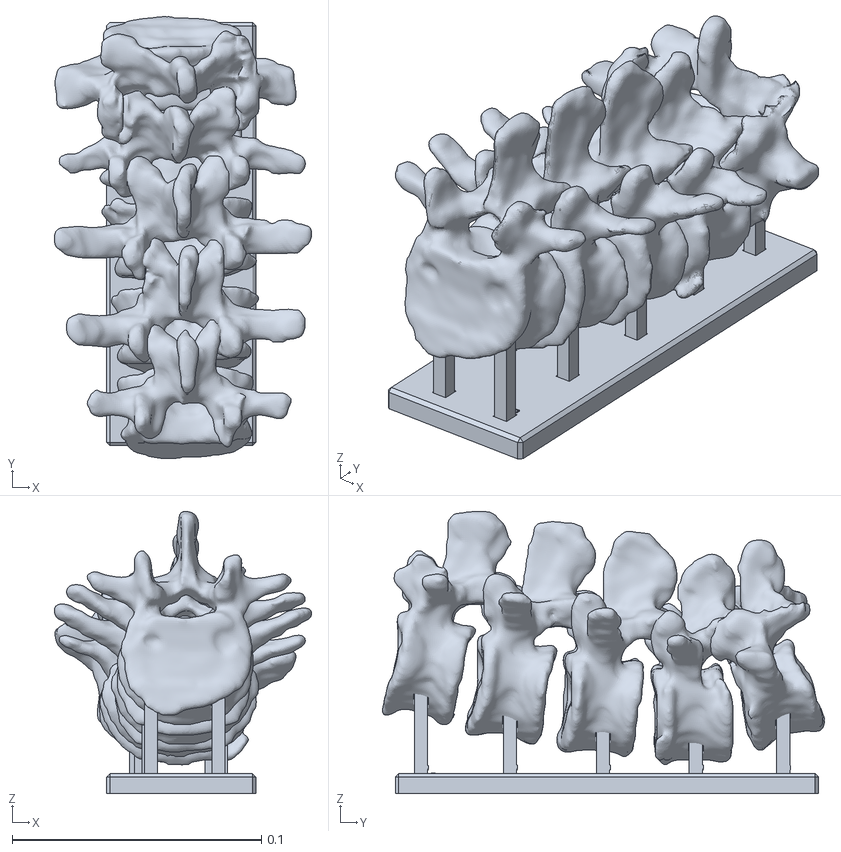
[picture p131: CAD file, 2026-09-13]
phantom/full_model_v0.2.stl
0.103 x 0.177 x 0.113
