LlamaLuLu/EEE4022S-AR-Spine-Registration/phantom/meshes/full_phantom_l4.stl

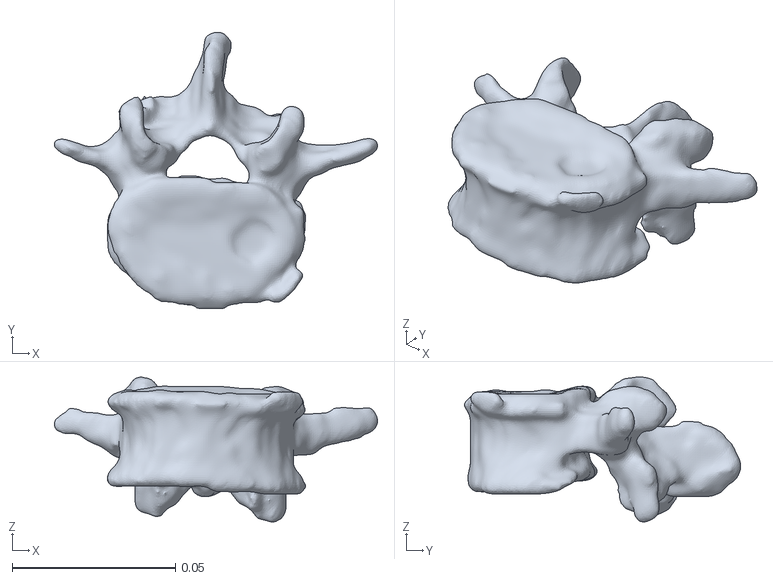
[picture p132: CAD file, 2026-10-11]
phantom/meshes/full_phantom_l4.stl
0.0988 x 0.0845 x 0.0443
