LlamaLuLu/EEE4022S-AR-Spine-Registration/phantom/meshes/full_phantom_l3.stl

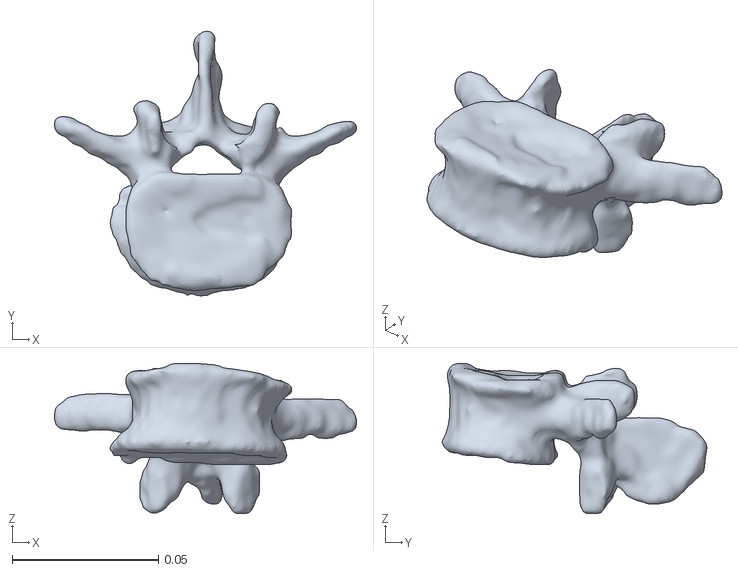
[picture p133: CAD file, 2026-10-11]
phantom/meshes/full_phantom_l3.stl
0.103 x 0.0905 x 0.0515
