LlamaLuLu/EEE4022S-AR-Spine-Registration/phantom/meshes/full_phantom_l5.stl

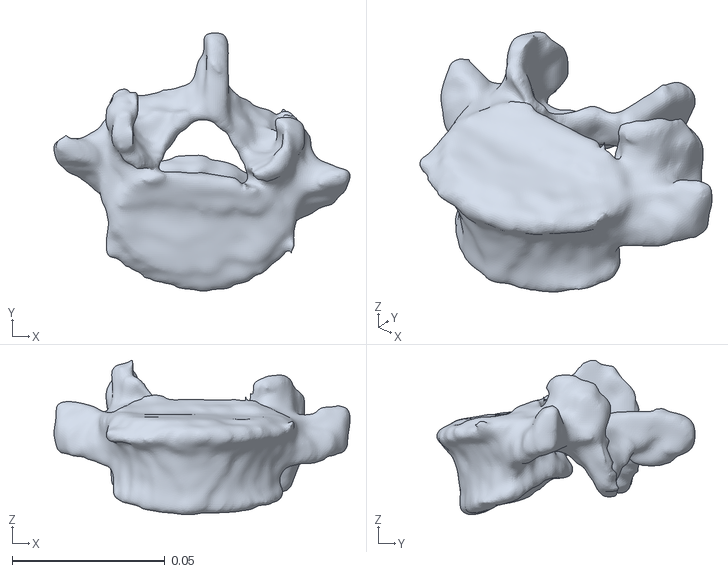
[picture p134: CAD file, 2026-10-11]
phantom/meshes/full_phantom_l5.stl
0.0968 x 0.0844 x 0.0505
