LlamaLuLu/EEE4022S-AR-Spine-Registration/phantom/meshes/full_phantom_l2.stl

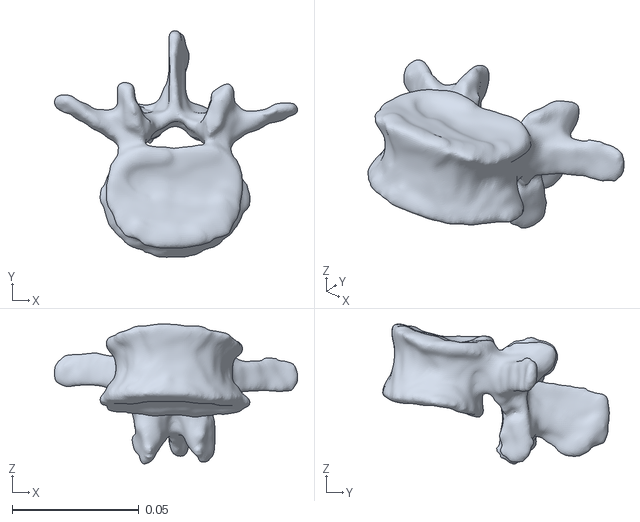
[picture p135: CAD file, 2026-10-11]
phantom/meshes/full_phantom_l2.stl
0.0958 x 0.0893 x 0.0552
