LlamaLuLu/EEE4022S-AR-Spine-Registration/phantom/meshes/full_phantom_l1.stl

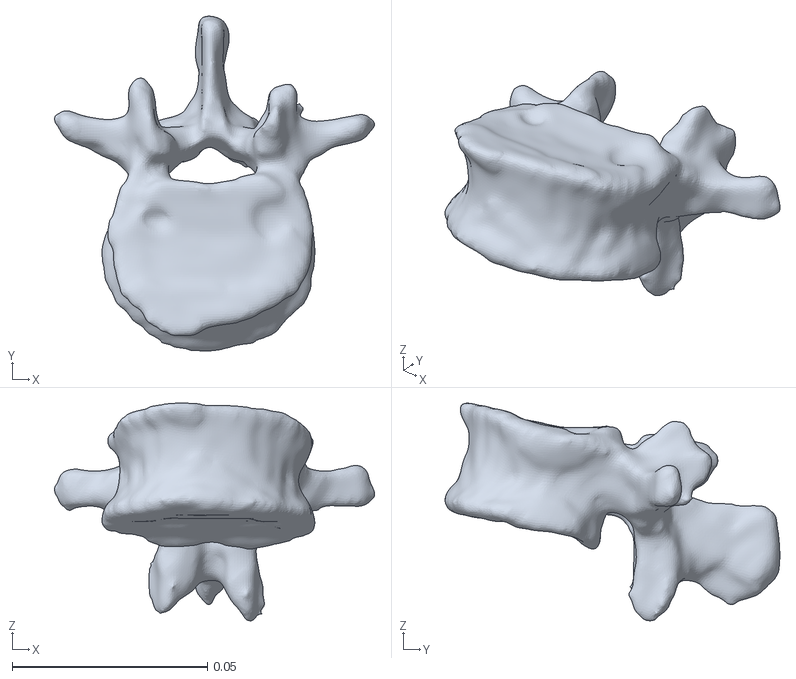
[picture p136: CAD file, 2026-10-11]
phantom/meshes/full_phantom_l1.stl
0.0819 x 0.0857 x 0.0557
