LlamaLuLu/EEE4022S-AR-Spine-Registration/phantom/meshes/marker_variations/variation0.stl

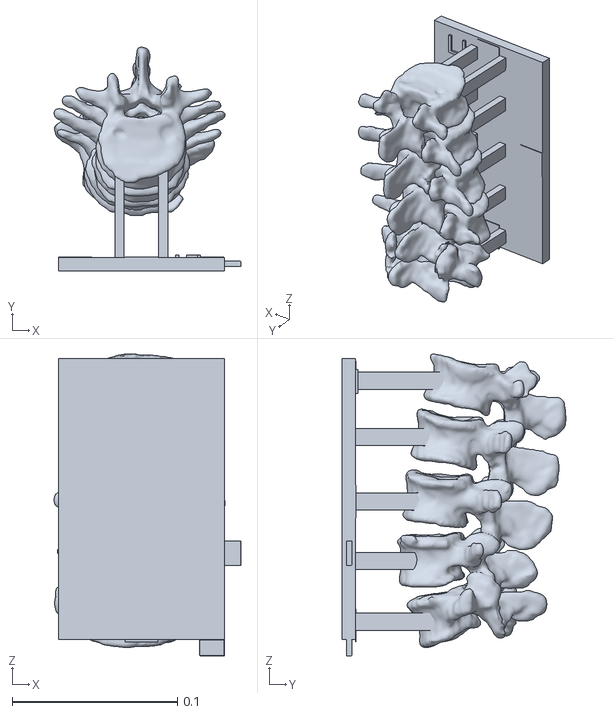
[picture p137: CAD file, 2026-09-14]
phantom/meshes/marker_variations/variation0.stl
0.113 x 0.135 x 0.182
