LlamaLuLu/EEE4022S-AR-Spine-Registration/phantom/meshes/v3_print/post_mid.stl

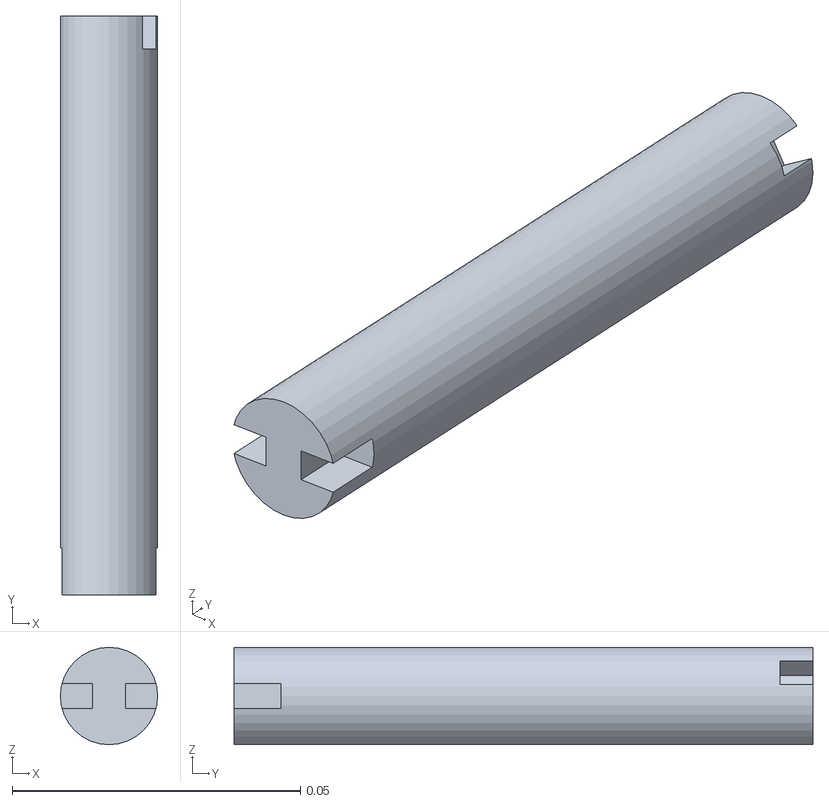
[picture p138: CAD file, 2026-10-11]
phantom/meshes/v3_print/post_mid.stl
0.0169 x 0.1 x 0.0169
