LlamaLuLu/EEE4022S-AR-Spine-Registration/phantom/meshes/marker_variations/variation2.stl

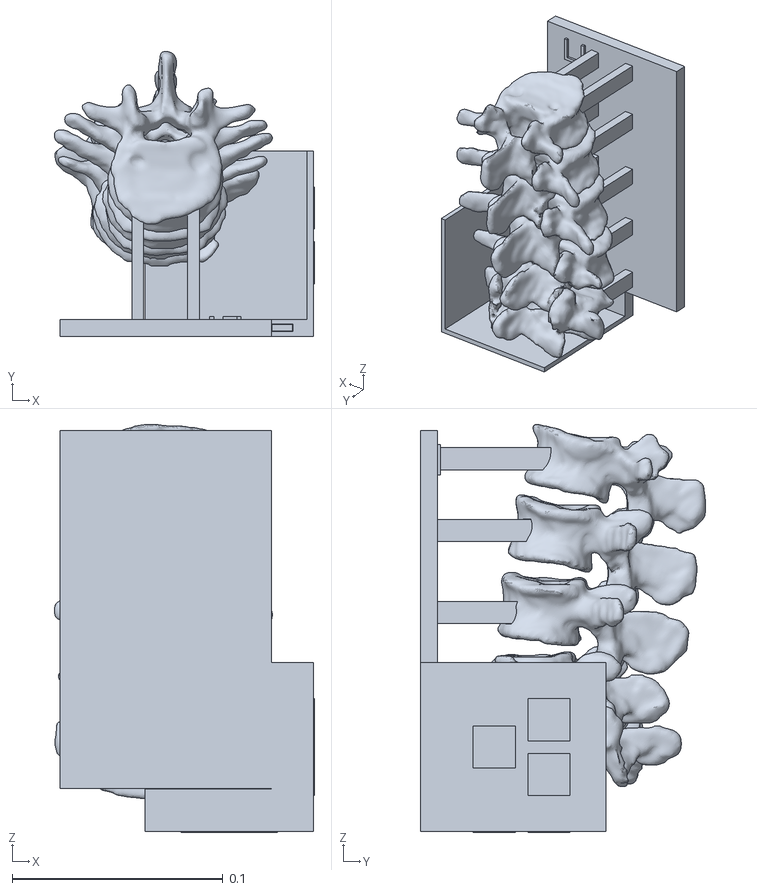
[picture p139: CAD file, 2026-09-14]
phantom/meshes/marker_variations/variation2.stl
0.123 x 0.135 x 0.193
