LlamaLuLu/EEE4022S-AR-Spine-Registration/phantom/meshes/v3_print/connector 3.stl

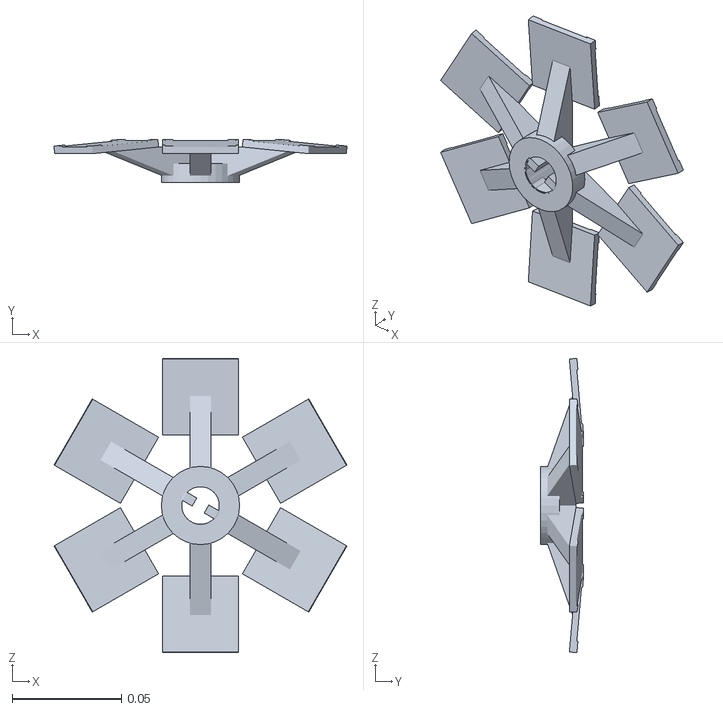
[picture p141: CAD file, 2026-10-11]
phantom/meshes/v3_print/connector 3.stl
0.134 x 0.0198 x 0.135
