LlamaLuLu/EEE4022S-AR-Spine-Registration/phantom/meshes/v3_print/post_top.stl

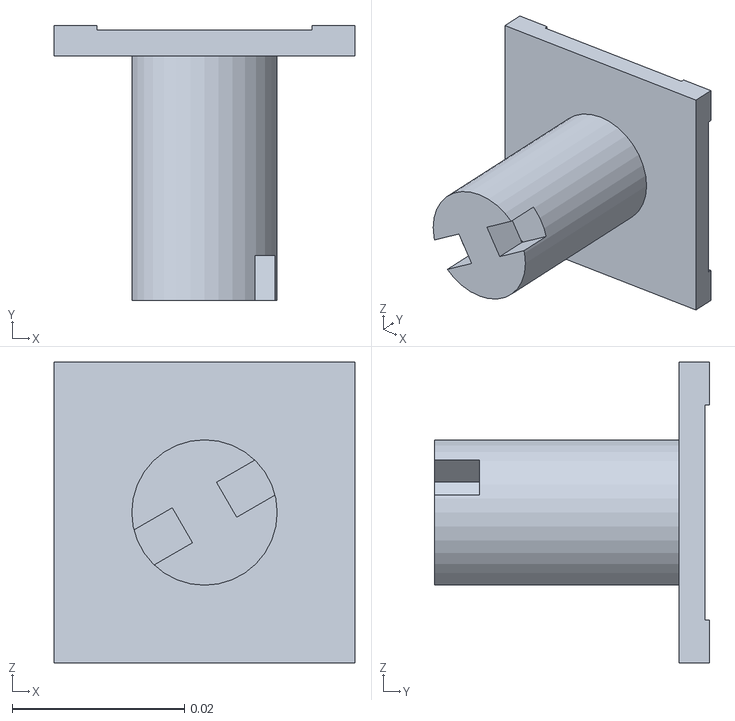
[picture p144: CAD file, 2026-10-11]
phantom/meshes/v3_print/post_top.stl
0.035 x 0.0319 x 0.035
