LlamaLuLu/EEE4022S-AR-Spine-Registration/phantom/meshes/L4.stl

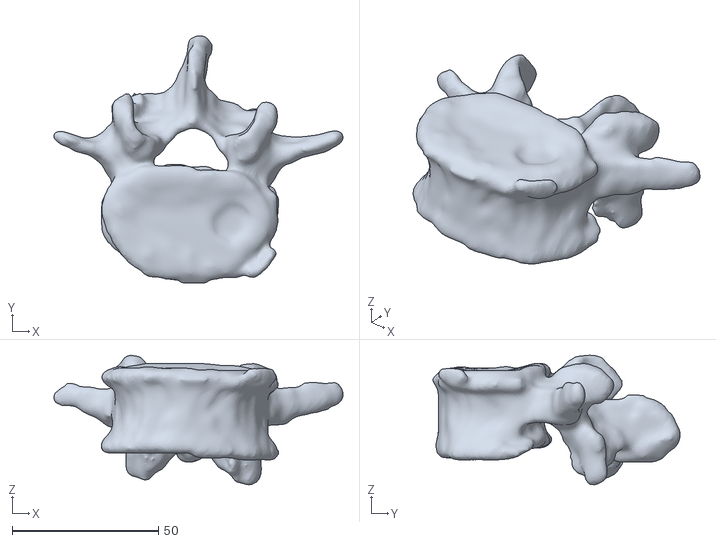
[picture p145: CAD file, 2026-08-15]
phantom/meshes/L4.stl
98.8 x 84.5 x 44.3
