LlamaLuLu/EEE4022S-AR-Spine-Registration/phantom/meshes/v3_print/post_base.stl

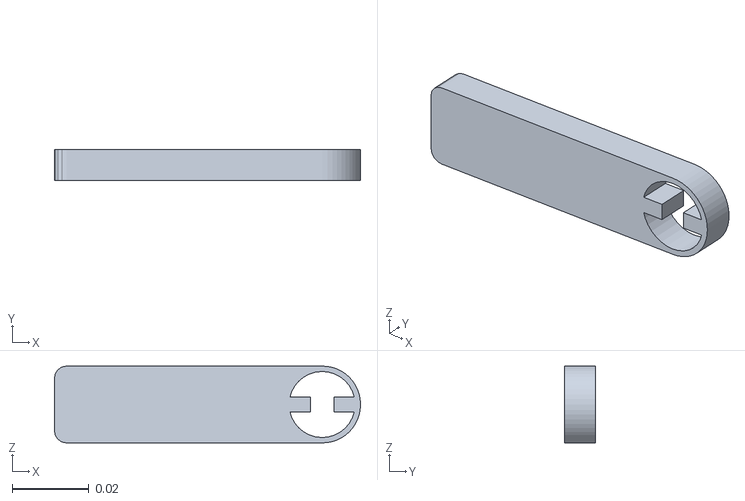
[picture p146: CAD file, 2026-10-11]
phantom/meshes/v3_print/post_base.stl
0.0797 x 0.008 x 0.02
