LlamaLuLu/EEE4022S-AR-Spine-Registration/phantom/meshes/L1.stl

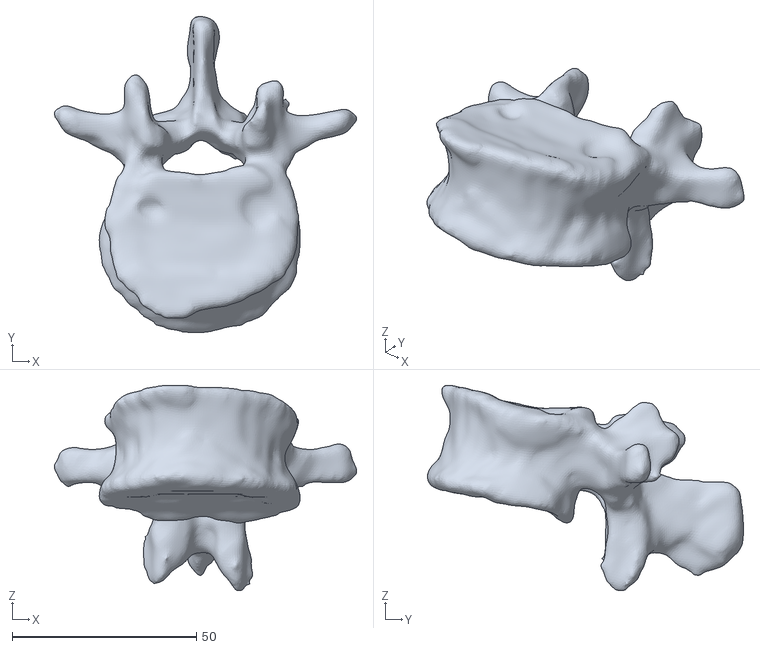
[picture p147: CAD file, 2026-08-15]
phantom/meshes/L1.stl
81.9 x 85.7 x 55.7
