LlamaLuLu/EEE4022S-AR-Spine-Registration/phantom/meshes/v3_print/segmented dome.3mf

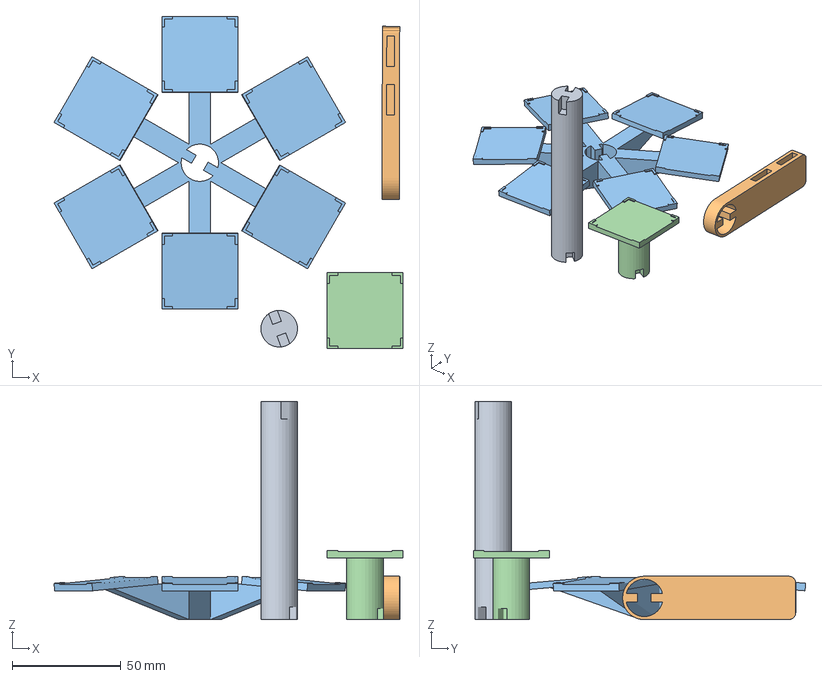
[picture p148: CAD file, 2026-10-11]
phantom/meshes/v3_print/segmented dome.3mf
160.8 x 153.1 x 100.5 mm
post_mid.stl
post_base.stl
connectors.stl
post_top.stl
