LlamaLuLu/EEE4022S-AR-Spine-Registration/phantom/meshes/L2.stl

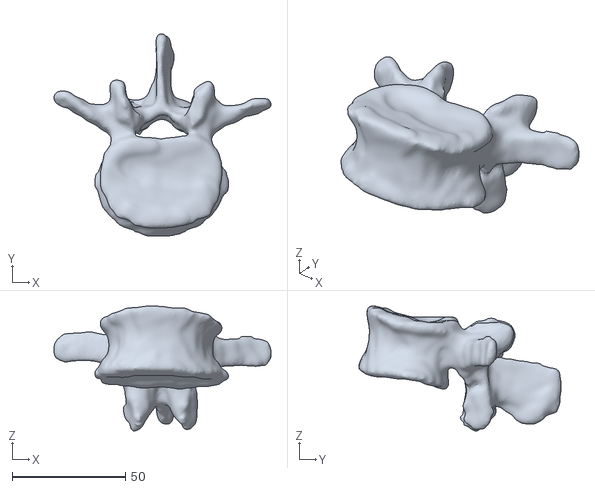
[picture p149: CAD file, 2026-08-15]
phantom/meshes/L2.stl
95.8 x 89.3 x 55.2
