LlamaLuLu/EEE4022S-AR-Spine-Registration/phantom/meshes/v3_print/connectors.3mf

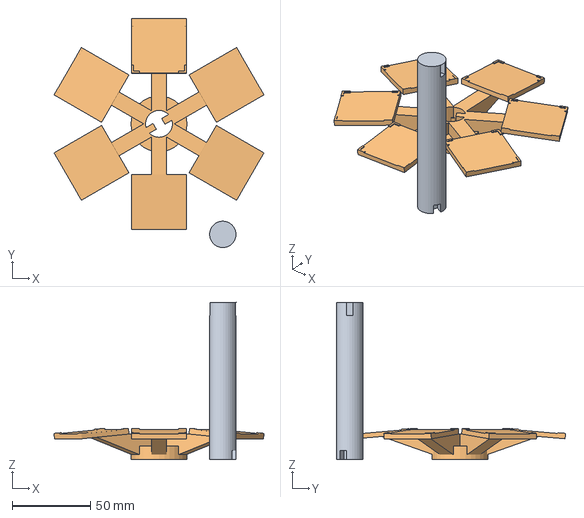
[picture p150: CAD file, 2026-10-11]
phantom/meshes/v3_print/connectors.3mf
134.3 x 146.6 x 100.5 mm
post_mid 2.stl
connector 3.stl
