LlamaLuLu/EEE4022S-AR-Spine-Registration/phantom/meshes/L5.stl

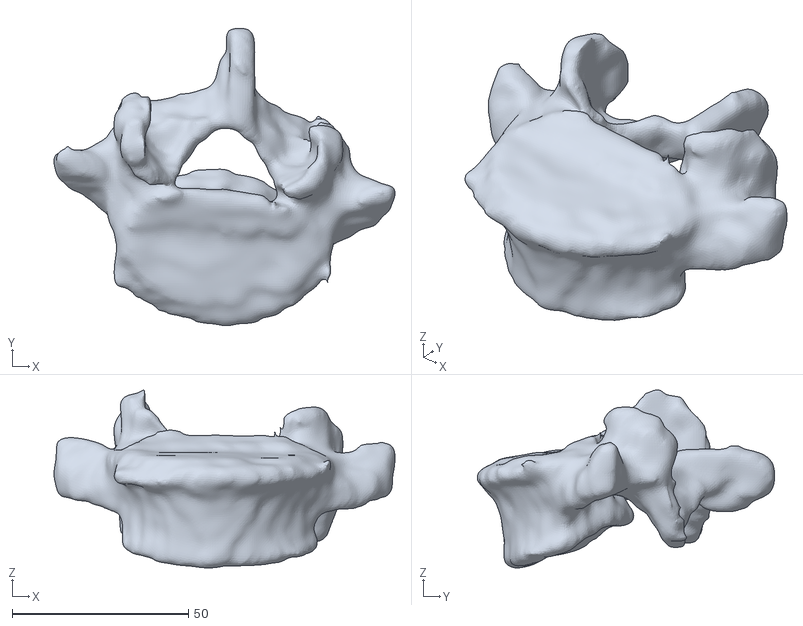
[picture p151: CAD file, 2026-08-15]
phantom/meshes/L5.stl
96.8 x 84.4 x 50.5
