LlamaLuLu/EEE4022S-AR-Spine-Registration/phantom/meshes/v3_print/dome.3mf

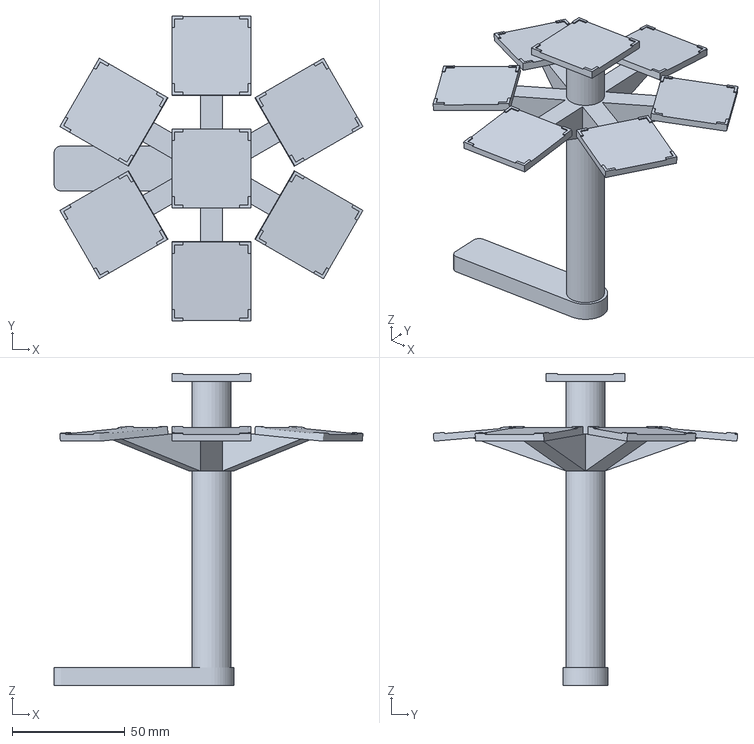
[picture p152: CAD file, 2026-10-06]
phantom/meshes/v3_print/dome.3mf
136.9 x 134.9 x 138.2 mm
