LlamaLuLu/EEE4022S-AR-Spine-Registration/phantom/meshes/L3.stl

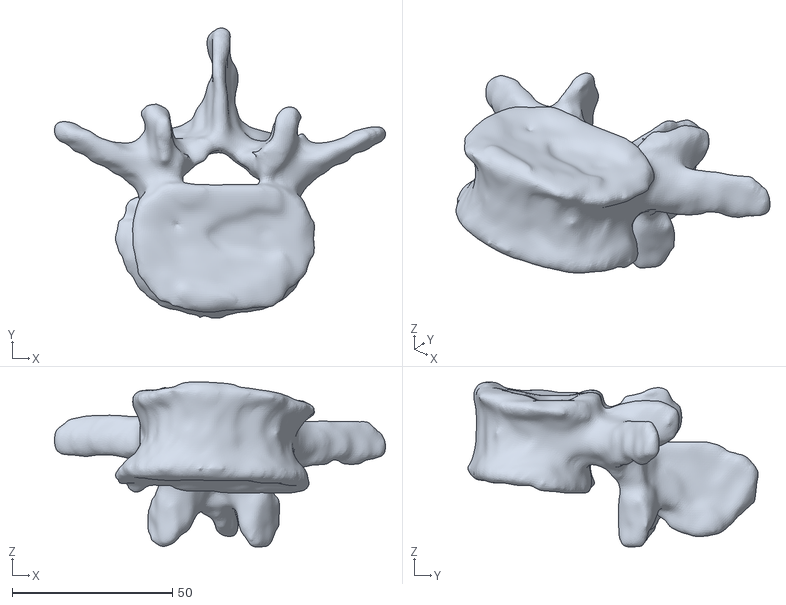
[picture p153: CAD file, 2026-08-15]
phantom/meshes/L3.stl
103.3 x 90.5 x 51.5
