LlamaLuLu/EEE4022S-AR-Spine-Registration/phantom/meshes/v3_print/spine_phantom_dome.stl

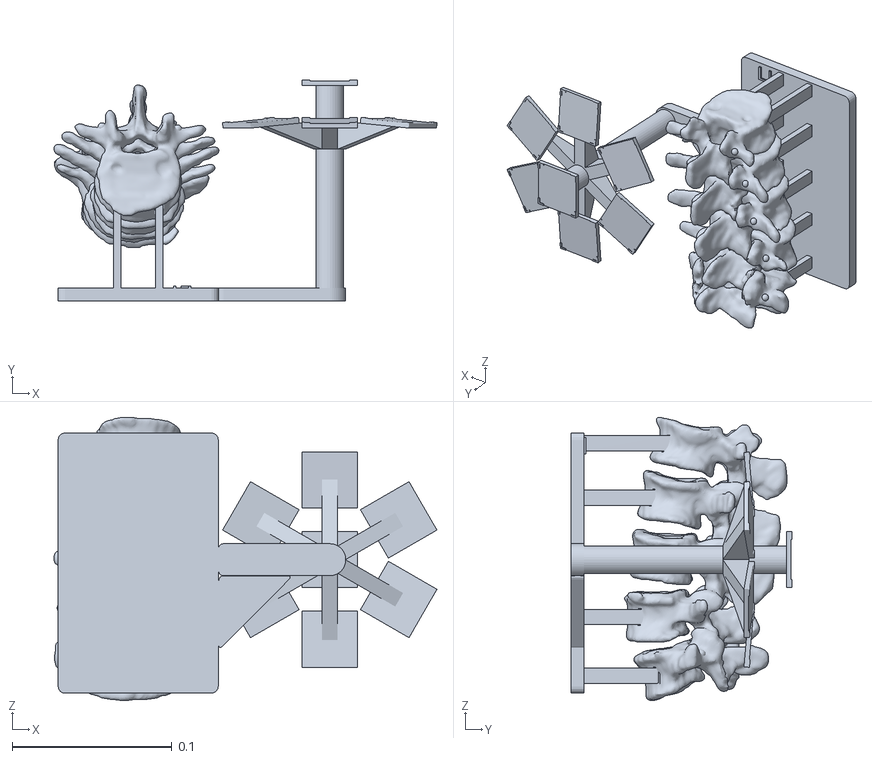
[picture p154: CAD file, 2026-10-06]
phantom/meshes/v3_print/spine_phantom_dome.stl
0.24 x 0.138 x 0.177
