LlamaLuLu/EEE4022S-AR-Spine-Registration/phantom/meshes/v3_print/dome_face.stl

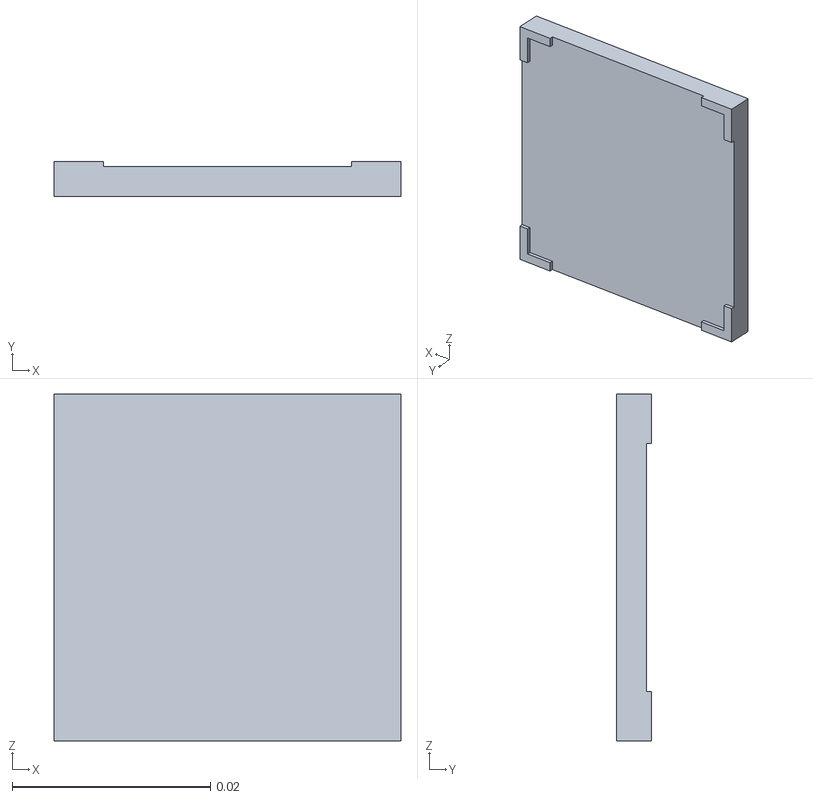
[picture p155: CAD file, 2026-10-06]
phantom/meshes/v3_print/dome_face.stl
0.035 x 0.0035 x 0.035
