LlamaLuLu/EEE4022S-AR-Spine-Registration/phantom/meshes/v3_print/gusset_face.3mf

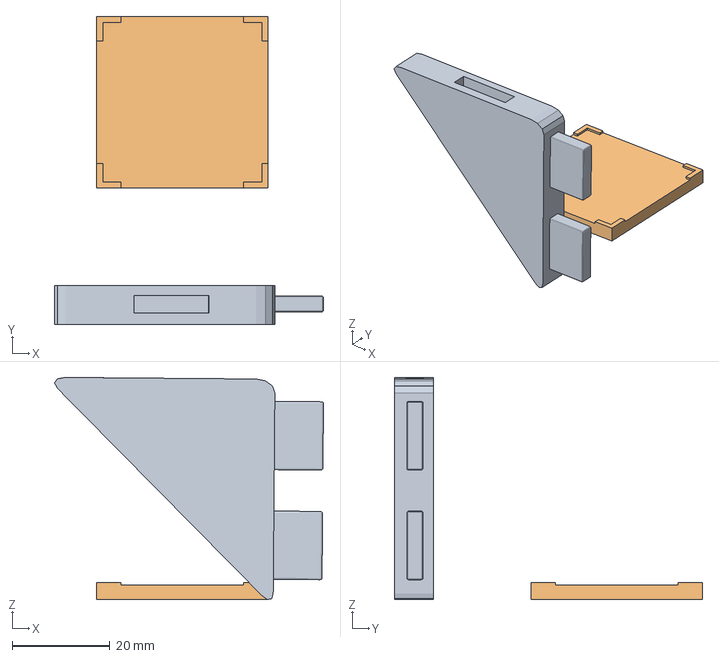
[picture p156: CAD file, 2026-10-06]
phantom/meshes/v3_print/gusset_face.3mf
54.9 x 62.9 x 45.3 mm
gusset.stl
dome_face.stl
