LlamaLuLu/EEE4022S-AR-Spine-Registration/phantom/meshes/v3_print/gusset.stl

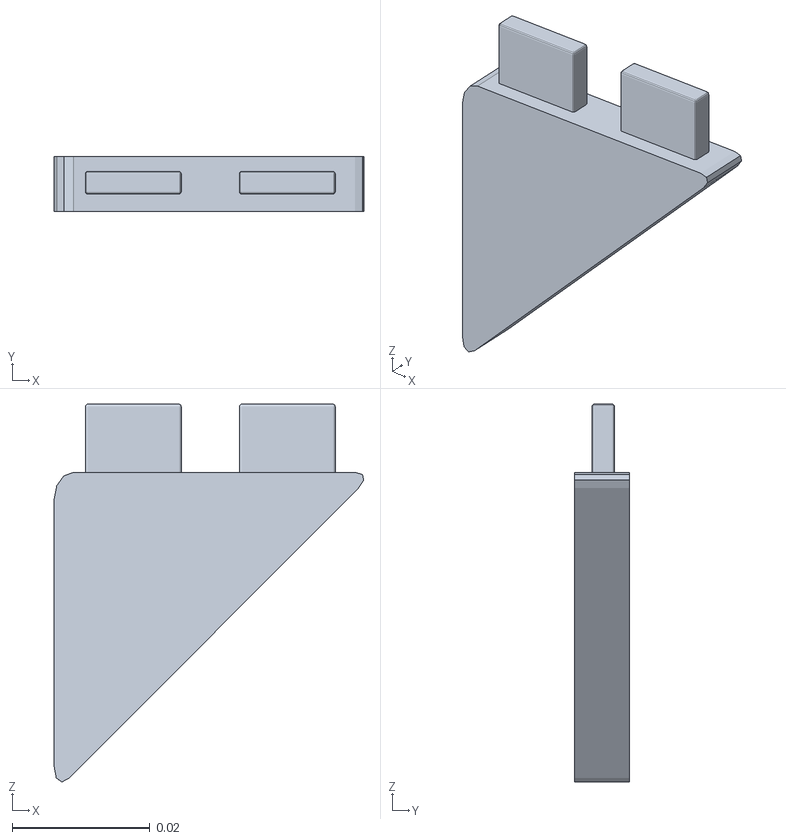
[picture p157: CAD file, 2026-10-06]
phantom/meshes/v3_print/gusset.stl
0.045 x 0.008 x 0.0549
