LlamaLuLu/EEE4022S-AR-Spine-Registration/phantom/meshes/v3_print/base_dome.stl

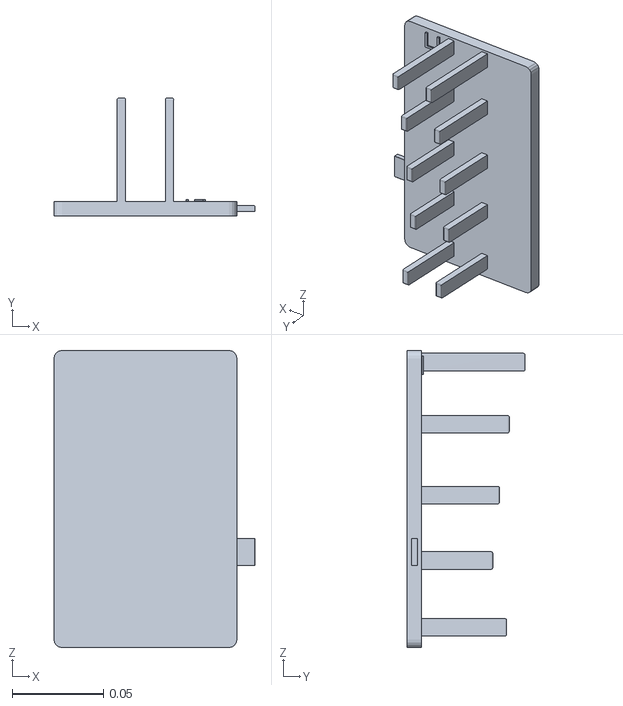
[picture p158: CAD file, 2026-10-06]
phantom/meshes/v3_print/base_dome.stl
0.11 x 0.065 x 0.163
