LlamaLuLu/EEE4022S-AR-Spine-Registration/(list of files, cad)

Other CAD files:
phantom/meshes/v3_overlay/phantom_l3.stl
phantom/meshes/v3_overlay/phantom_l4.stl
phantom/meshes/marker_variations/variation1.stl
phantom/meshes/v3_overlay/phantom_l2.stl
phantom/meshes/v3_overlay/phantom_l1.stl
phantom/meshes/v3_overlay/phantom_l5.stl
phantom/meshes/v0_print/spine_phantomL1.001.stl
phantom/meshes/v0_print/spine_phantomL2.001.stl
phantom/meshes/v0_print/spine_phantomL3.001.stl
phantom/meshes/v0_print/spine_phantomL4.001.stl
phantom/meshes/v0_print/spine_phantomL5.001.stl
phantom/meshes/v0_print/spine_phantom_supports.3mf
phantom/meshes/v0_print/spine_phantom_vertebrae.3mf
phantom/meshes/v0_print/spine_phantombase_plate.001.stl
phantom/meshes/v0_print/spine_phantomtab_L1_L.stl
phantom/meshes/v0_print/spine_phantomtab_L1_R.stl
phantom/meshes/v0_print/spine_phantomtab_L2_L.stl
phantom/meshes/v0_print/spine_phantomtab_L2_R.stl
phantom/meshes/v0_print/spine_phantomtab_L3_L.stl
phantom/meshes/v0_print/spine_phantomtab_L3_R.stl
phantom/meshes/v0_print/spine_phantomtab_L4_L.stl
phantom/meshes/v0_print/spine_phantomtab_L4_R.stl
phantom/meshes/v0_print/spine_phantomtab_L5_L.stl
phantom/meshes/v0_print/spine_phantomtab_L5_R.stl
phantom/meshes/v1_print/BASE.3mf
phantom/meshes/v1_print/BASE_v1.2.stl
phantom/meshes/v1_print/BASE_v1.3.stl
phantom/meshes/v1_print/BASE_v1.4.stl
phantom/meshes/v1_print/BASE_v1.stl
phantom/meshes/v1_print/L1.3mf
phantom/meshes/v1_print/L1_v1.stl
phantom/meshes/v1_print/L2_L3.3mf
phantom/meshes/v1_print/L2_v1.stl
phantom/meshes/v1_print/L3_v1.stl
phantom/meshes/v1_print/L4_L5.3mf
phantom/meshes/v1_print/L4_v1.stl
phantom/meshes/v1_print/L5_v1.stl
phantom/meshes/v1_print/L_BRACKET_L1 copy.3mf
phantom/meshes/v1_print/L_BRACKET_L1.3mf
phantom/meshes/v1_print/L_BRACKET_v1.2.stl
phantom/meshes/v1_print/l-bracket_v1.3.stl
phantom/meshes/v1_print/l_bracket_v1.4.stl
phantom/meshes/v1_print/spine_phantom_v1.2.stl
phantom/meshes/v1_print/spine_phantom_v1.3.stl
phantom/meshes/v1_print/spine_phantom_v1.stl
phantom/meshes/v1_print/spine_v1.stl
phantom/meshes/v1_print/spine_v1_decimated.stl
phantom/meshes/v2_print/BASE_v2.3mf
phantom/meshes/v2_print/BASE_v2.stl
phantom/meshes/v2_print/L1_L2_v2.3mf
phantom/meshes/v2_print/L1_v2.stl
phantom/meshes/v2_print/L2_v2.stl
phantom/meshes/v2_print/L3_L5_v2.3mf
phantom/meshes/v2_print/L3_v2.stl
phantom/meshes/v2_print/L4_v2.3mf
phantom/meshes/v2_print/L4_v2.stl
phantom/meshes/v2_print/L5_v2.stl
phantom/meshes/v2_print/spine_phantom_v2.stl
phantom/meshes/v3_print/DOME.stl
phantom/meshes/v3_print/connectors.stl
phantom/spine_phantom.blend
phantom/spine_phantom_v1.blend
