LlamaLuLu/EEE4022S-AR-Spine-Registration/data/calibration/printables/charuco_board.pdf

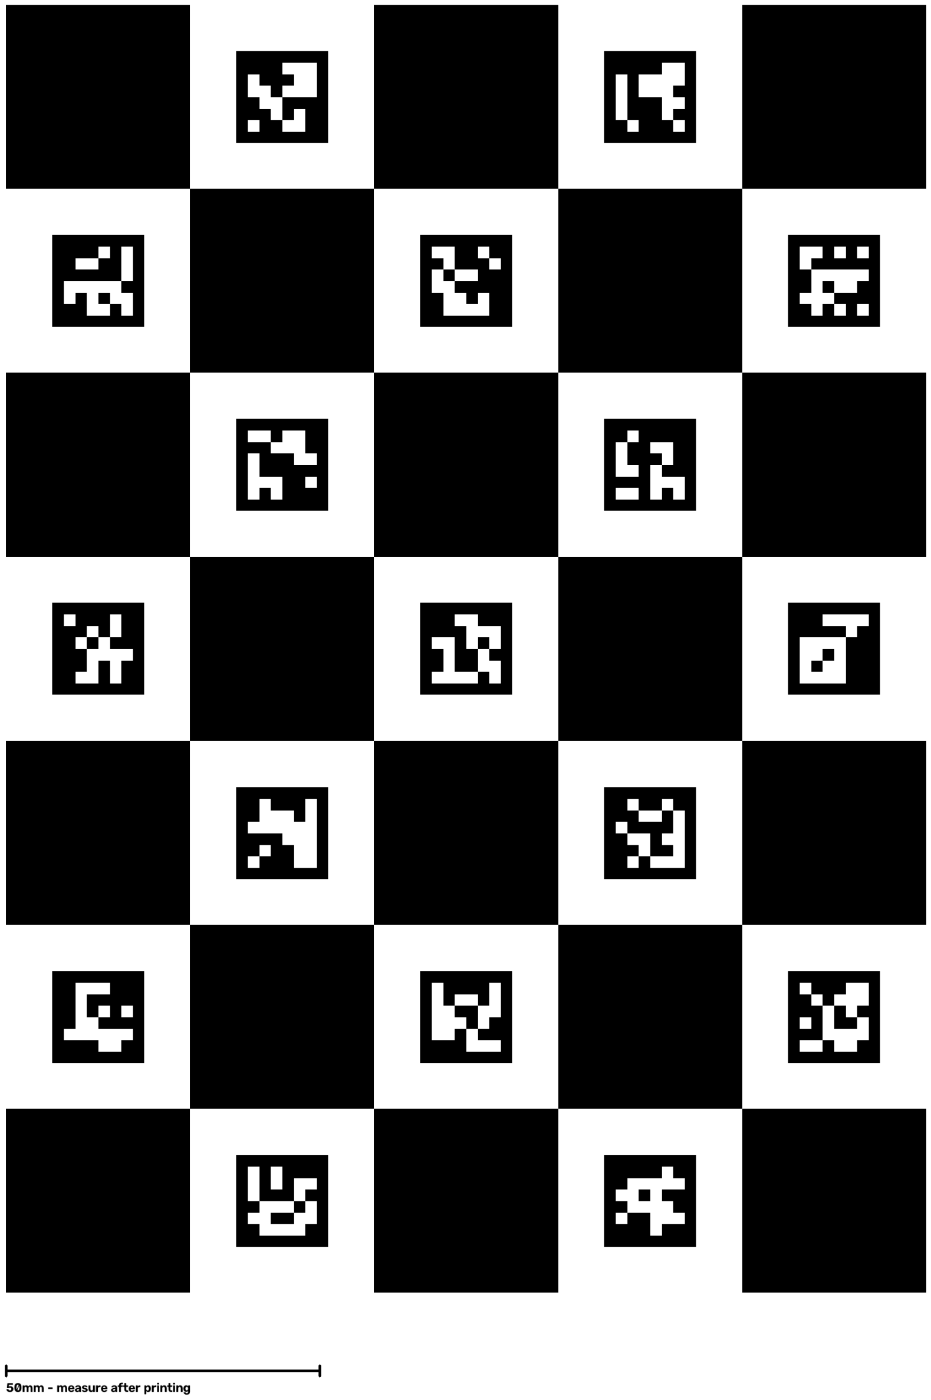
[picture p159: figure]
