LlamaLuLu/EEE4022S-AR-Spine-Registration/data/fle_measurement/printables/fle_board.pdf

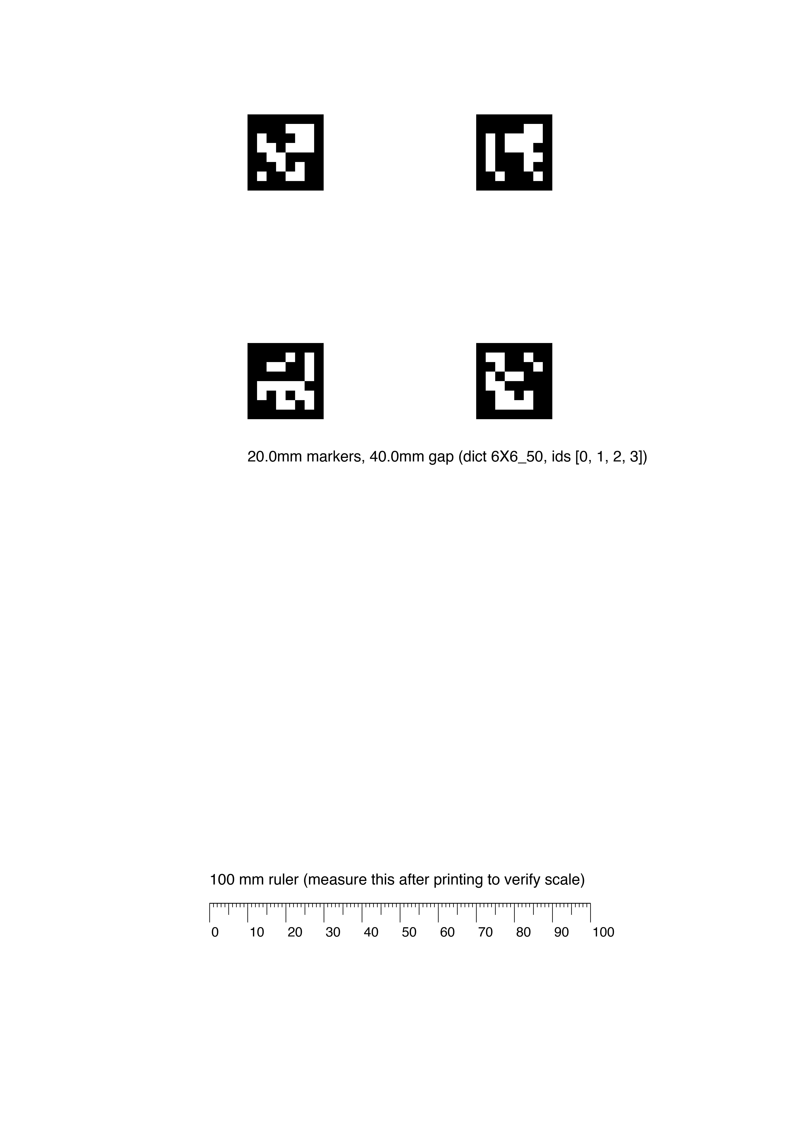
[picture p160: page 1]
