LlamaLuLu/EEE4022S-AR-Spine-Registration/data/calibration/printables/charuco_board.png

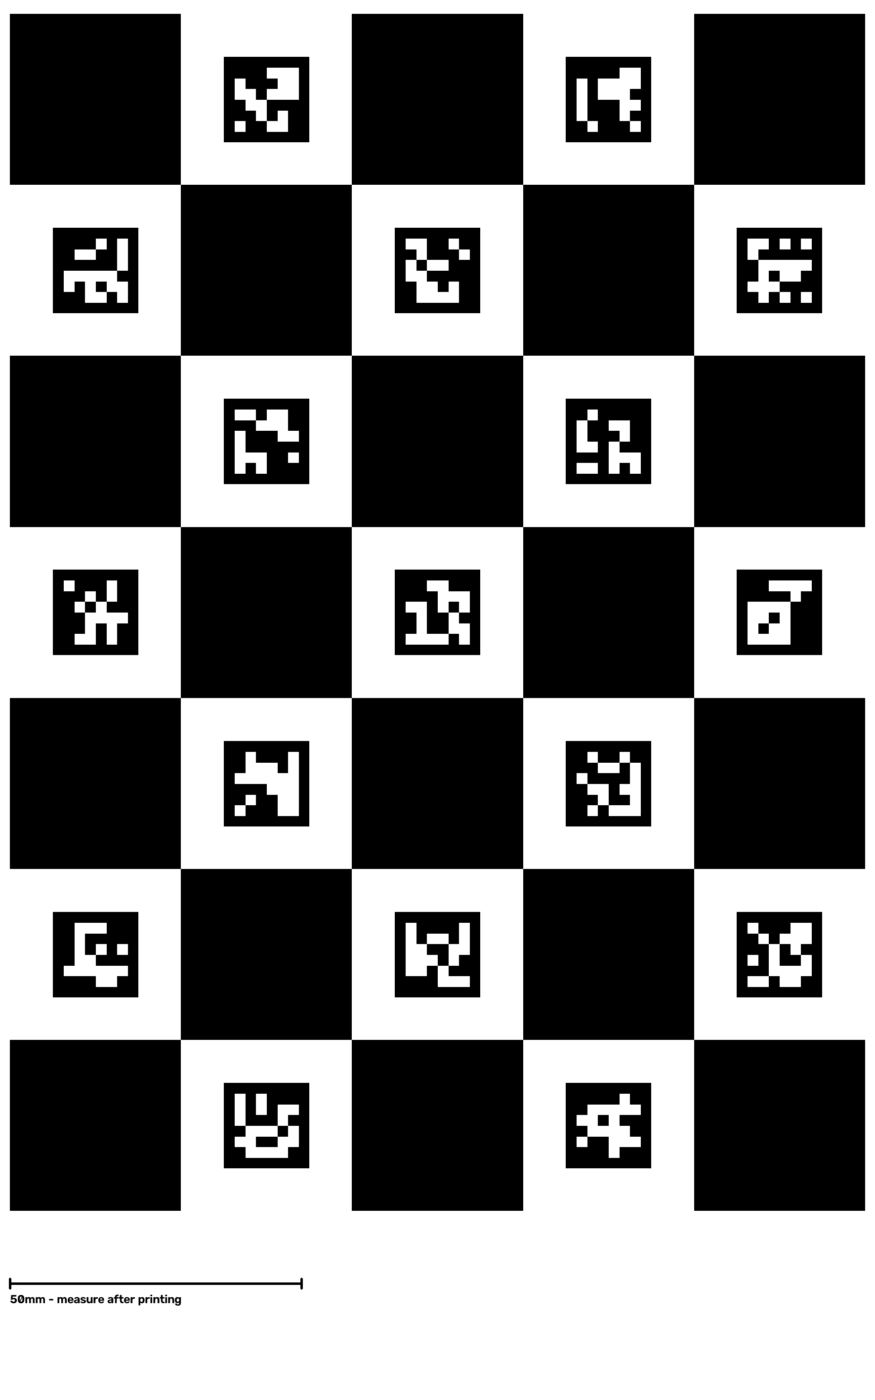
data/calibration/printables/charuco_board.png
