LlamaLuLu/EEE4022S-AR-Spine-Registration/docs/dome_operating_range.png

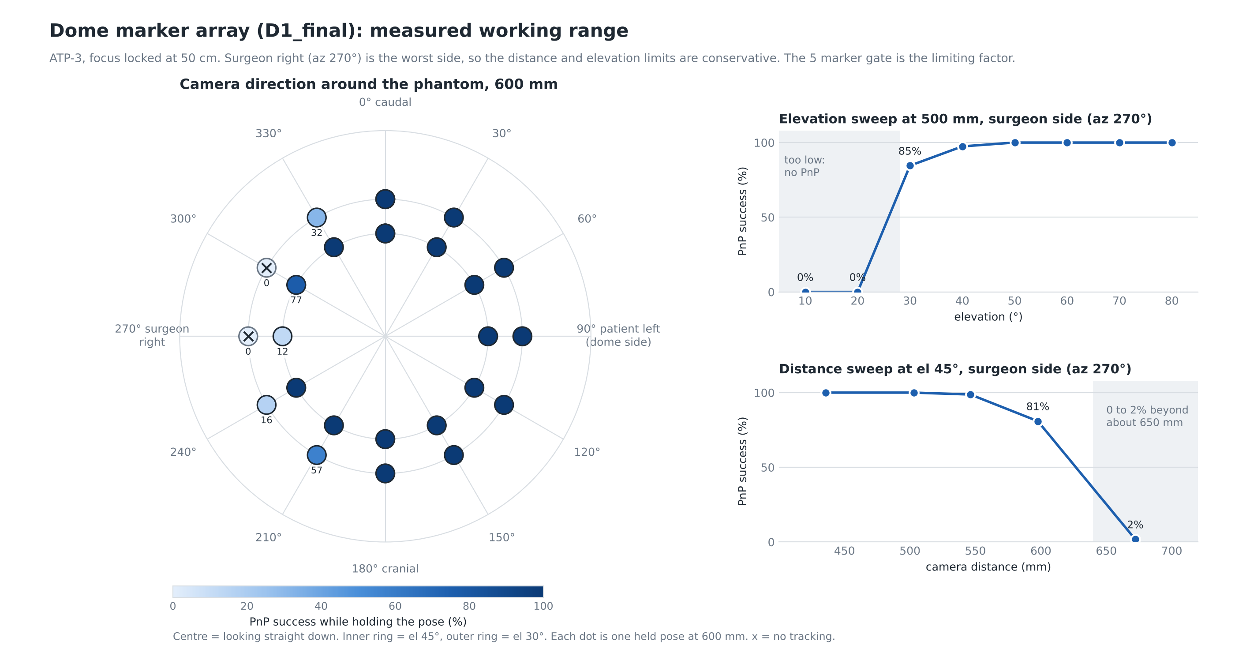
docs/dome_operating_range.png
