LlamaLuLu/EEE4022S-AR-Spine-Registration/docs/figures/assembled_dome.jpeg

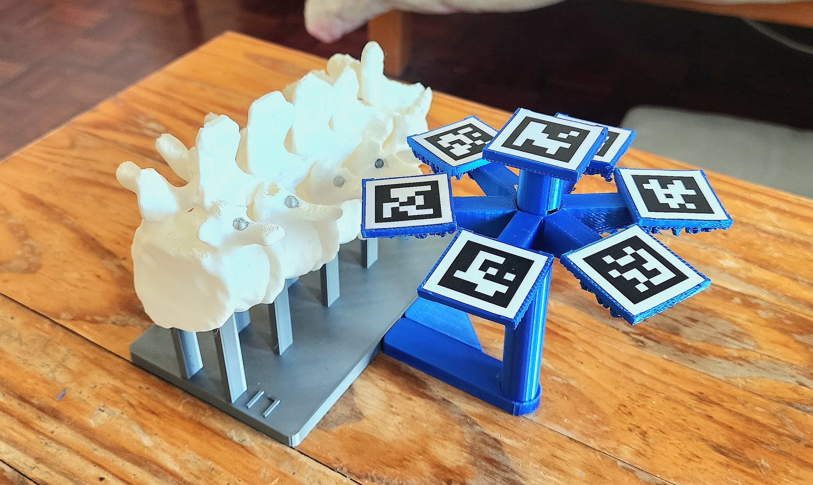
docs/figures/assembled_dome.jpeg
