LlamaLuLu/EEE4022S-AR-Spine-Registration/docs/figures/assembled_l_bracket.jpeg

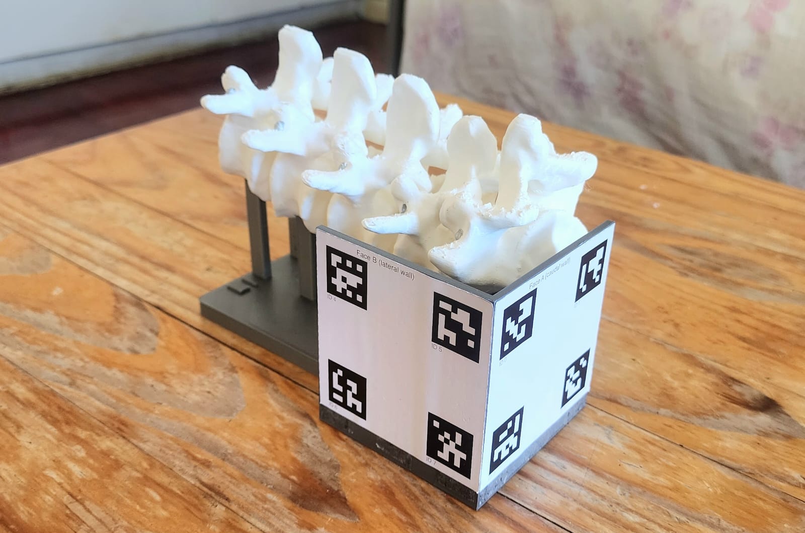
docs/figures/assembled_l_bracket.jpeg
