LlamaLuLu/EEE4022S-AR-Spine-Registration/docs/figures/fig_calibration.pdf

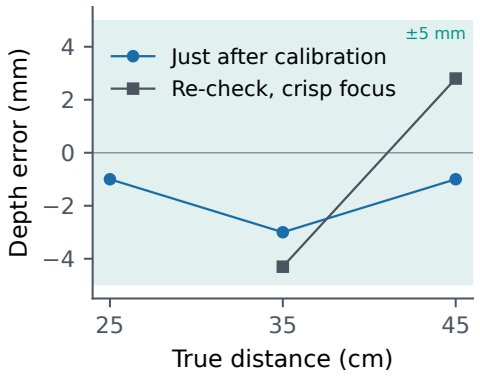
[picture p165: figure]
True distance (cm); Depth error (mm); Just after calibration Re-check, crisp focus

v0 | v1 training

v1
held-out

0.00

0.25

0.50

0.75

1.00

1.25

Reprojection RMS (px)
1.24
0.51 | 0.52
(a) Calibration residual
(b) Ruler validation
