LlamaLuLu/EEE4022S-AR-Spine-Registration/data/calibration/printables/test_markers.pdf

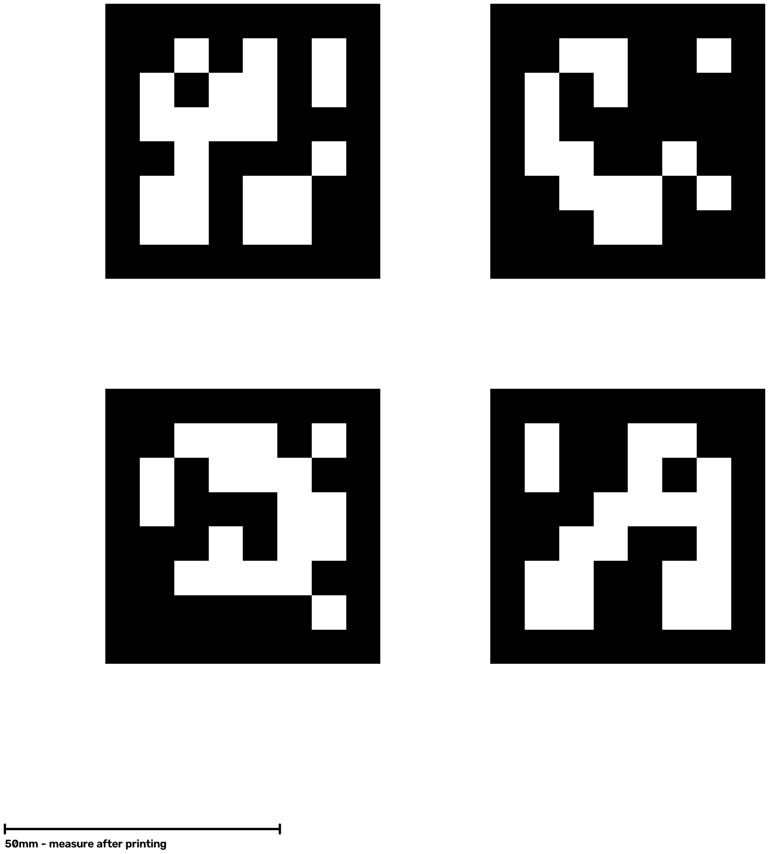
[picture p166: figure]
