LlamaLuLu/EEE4022S-AR-Spine-Registration/data/atp/smoke_test.csv

timestamp | state | n_markers | pnp_ok | rms_px | distance_mm | elevation_deg | azimuth_deg | cam_x | cam_y | cam_z | in_envelope | grab_ms | detect_pnp_ms | overlay_ms | qt_ms | visible_ids | TRE_L3_R | TRE_L3_L | TRE_L4_R | TRE_L4_L | TRE_L2_R | TRE_L2_L | TRE_L1_R | TRE_L1_L | TRE_L5_R | TRE_L5_L | TRE_L1_E_R | TRE_L1_E_L | TRE_L2_E_R | TRE_L2_E_L | TRE_L3_E_L | TRE_L3_E_R | TRE_L4_E_R | TRE_L4_E_L | TRE_L5_E_L | TRE_L5_E_R
1790576627.501 | VERIFYING | 8 | True | 0.92 | 495.6 | 28.9 | 42.9 | 295.2 | 239.7 | -317.8 | False | 0.0 | 77.6 | 27.2 | 16.3 | 5|0|7|4|2|1|6|3 | 0.864 | 0.715 | 0.719 | 0.545 | 1.031 | 0.931 | 1.219 | 1.137 | 0.668 | 0.425 | 1.274 | 1.149 | 1.096 | 0.945 | 0.731 | 0.909 | 0.778 | 0.553 | 0.430 | 0.741
1790576627.689 | VERIFYING | 8 | True | 0.95 | 495.6 | 28.9 | 42.9 | 295.3 | 239.7 | -317.8 | False | 0.0 | 22.7 | 25.3 | 2.4 | 5|0|7|4|2|1|6|3 | 0.864 | 0.715 | 0.719 | 0.545 | 1.031 | 0.931 | 1.219 | 1.137 | 0.668 | 0.425 | 1.274 | 1.149 | 1.096 | 0.945 | 0.731 | 0.909 | 0.778 | 0.553 | 0.430 | 0.741
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
