LlamaLuLu/EEE4022S-AR-Spine-Registration/results/tre_analysis/archive/README.md

# Archived solver comparison

Output of the ITERATIVE vs SQPNP comparison that led to SQPNP being used in the overlay.

- `iterative/`: sweeps and tables produced with the iterative solver
- `solver_rerun/`: the same configurations re-run with both solvers, with the console summary of each run in the matching `.txt`

The current results are in the parent folder.
