LlamaLuLu/EEE4022S-AR-Spine-Registration/results/tre_analysis/archive/iterative/tilt_sweep_600.csv

config | tilt | N | tracked | noncop | worst_lt2 | el60 | el60_n | expected | mc_live | fitz_worst
D1_left_L3 | 0.0 | 7 | 37 | 37 | 37 | 16 | 16 | 35.87330593646935 | 1.2811448397848202 | 1.2106750087568259
D1_left_L3 | 5.0 | 7 | 37 | 37 | 37 | 16 | 16 | 35.08361114340174 | 1.2972031548369005 | 1.2308574529526284
D1_left_L3 | 10.0 | 7 | 37 | 37 | 37 | 16 | 16 | 33.64904429186769 | 1.3048359716020257 | 1.250859480116624
D1_left_L3 | 15.0 | 7 | 36 | 36 | 35 | 16 | 16 | 31.92701100723932 | 1.3319092254375768 | 1.3101730274076462
D1_left_L3 | 20.0 | 7 | 31 | 31 | 31 | 16 | 16 | 29.69994578505251 | 1.3221175207712421 | 1.2801766265022818
D1_left_L3 | 25.0 | 7 | 31 | 31 | 31 | 16 | 16 | 27.742365871293146 | 1.350627967080359 | 1.3225656630903806
D1_left_L3 | 30.0 | 7 | 30 | 30 | 29 | 16 | 16 | 25.891231708568846 | 1.3591312531102462 | 1.3636464438043858
D1_left_L3 | 35.0 | 7 | 25 | 25 | 25 | 16 | 16 | 23.02505971169987 | 1.3639236321226258 | 1.3716909990729282
D2_caudal | 0.0 | 7 | 37 | 37 | 0 | 16 | 16 | 27.19623719996418 | 1.9060637603931694 | 2.594854322541617
D2_caudal | 5.0 | 7 | 35 | 35 | 0 | 16 | 16 | 26.04206782381748 | 1.888978631067993 | 2.594854322541617
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
