LlamaLuLu/EEE4022S-AR-Spine-Registration/results/tre_analysis/archive/solver_rerun/bracket_450_iterative_40.csv

variant | n_markers | elev | az | n_visible | tracked | noncoplanar | mc_static_mm | mc_live_mm | overlay_live_mm | fitzpatrick_mm | fitzpatrick_worst_mm
V0_baseline | 4 | 10.0 | 0.0 | 0 | 0 | 0
V0_baseline | 4 | 10.0 | 45.0 | 0 | 0 | 0
V0_baseline | 4 | 10.0 | 90.0 | 0 | 0 | 0
V0_baseline | 4 | 10.0 | 135.0 | 0 | 0 | 0
V0_baseline | 4 | 10.0 | 180.0 | 0 | 0 | 0
V0_baseline | 4 | 10.0 | 225.0 | 0 | 0 | 0
V0_baseline | 4 | 10.0 | 270.0 | 0 | 0 | 0
V0_baseline | 4 | 10.0 | 315.0 | 0 | 0 | 0
V0_baseline | 4 | 20.0 | 0.0 | 0 | 0 | 0
V0_baseline | 4 | 20.0 | 45.0 | 1 | 0 | 0
V0_baseline | 4 | 20.0 | 90.0 | 1 | 0 | 0
V0_baseline | 4 | 20.0 | 135.0 | 1 | 0 | 0
V0_baseline | 4 | 20.0 | 180.0 | 0 | 0 | 0
V0_baseline | 4 | 20.0 | 225.0 | 1 | 0 | 0
V0_baseline | 4 | 20.0 | 270.0 | 1 | 0 | 0
V0_baseline | 4 | 20.0 | 315.0 | 1 | 0 | 0
V0_baseline | 4 | 30.0 | 0.0 | 0 | 0 | 0
V0_baseline | 4 | 30.0 | 45.0 | 1 | 0 | 0
V0_baseline | 4 | 30.0 | 90.0 | 1 | 0 | 0
V0_baseline | 4 | 30.0 | 135.0 | 1 | 0 | 0
V0_baseline | 4 | 30.0 | 180.0 | 0 | 0 | 0
V0_baseline | 4 | 30.0 | 225.0 | 1 | 0 | 0
V0_baseline | 4 | 30.0 | 270.0 | 1 | 0 | 0
V0_baseline | 4 | 30.0 | 315.0 | 1 | 0 | 0
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
