LlamaLuLu/EEE4022S-AR-Spine-Registration/results/tre_analysis/archive/solver_rerun/dome_900_iterative.csv

variant | n_markers | elev | az | n_visible | tracked | noncoplanar | mc_static_mm | mc_live_mm | overlay_live_mm | fitzpatrick_mm | fitzpatrick_worst_mm
D1_left_L3 | 7 | 10 | 0.0 | 0 | 0 | 0
D1_left_L3 | 7 | 10 | 45.0 | 0 | 0 | 0
D1_left_L3 | 7 | 10 | 90.0 | 0 | 0 | 0
D1_left_L3 | 7 | 10 | 135.0 | 0 | 0 | 0
D1_left_L3 | 7 | 10 | 180.0 | 0 | 0 | 0
D1_left_L3 | 7 | 10 | 225.0 | 0 | 0 | 0
D1_left_L3 | 7 | 10 | 270.0 | 0 | 0 | 0
D1_left_L3 | 7 | 10 | 315.0 | 0 | 0 | 0
D1_left_L3 | 7 | 20 | 0.0 | 1 | 0 | 0
D1_left_L3 | 7 | 20 | 45.0 | 2 | 0 | 0
D1_left_L3 | 7 | 20 | 90.0 | 3 | 0 | 0
D1_left_L3 | 7 | 20 | 135.0 | 2 | 0 | 0
D1_left_L3 | 7 | 20 | 180.0 | 1 | 0 | 0
D1_left_L3 | 7 | 20 | 225.0 | 0 | 0 | 0
D1_left_L3 | 7 | 20 | 270.0 | 0 | 0 | 0
D1_left_L3 | 7 | 20 | 315.0 | 0 | 0 | 0
D1_left_L3 | 7 | 30 | 0.0 | 5 | 1 | 1 | 0.4889 | 3.6793 | 0.7507 | 1.1913 | 1.5782
D1_left_L3 | 7 | 30 | 45.0 | 7 | 1 | 1 | 0.3383 | 2.5429 | 0.5923 | 0.9403 | 1.2107
D1_left_L3 | 7 | 30 | 90.0 | 7 | 1 | 1 | 0.3097 | 2.3291 | 0.5962 | 0.9403 | 1.2107
D1_left_L3 | 7 | 30 | 135.0 | 7 | 1 | 1 | 0.3502 | 2.6334 | 0.5954 | 0.9403 | 1.2107
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
