LlamaLuLu/EEE4022S-AR-Spine-Registration/results/tre_analysis/archive/solver_rerun/marker_15.csv

variant | n_markers | elev | az | n_visible | tracked | noncoplanar | mc_static_mm | mc_live_mm | overlay_live_mm | fitzpatrick_mm | fitzpatrick_worst_mm
V3_8marker | 8 | 10 | 0.0 | 4 | 0 | 0
V3_8marker | 8 | 10 | 45.0 | 8 | 1 | 1 | 0.1168 | 0.8781 | 0.4547 | 0.8448 | 1.2502
V3_8marker | 8 | 10 | 90.0 | 4 | 0 | 0
V3_8marker | 8 | 10 | 135.0 | 4 | 0 | 0
V3_8marker | 8 | 10 | 180.0 | 0 | 0 | 0
V3_8marker | 8 | 10 | 225.0 | 0 | 0 | 0
V3_8marker | 8 | 10 | 270.0 | 0 | 0 | 0
V3_8marker | 8 | 10 | 315.0 | 4 | 0 | 0
V3_8marker | 8 | 20 | 0.0 | 4 | 0 | 0
V3_8marker | 8 | 20 | 45.0 | 8 | 1 | 1 | 0.1159 | 0.8711 | 0.4188 | 0.8448 | 1.2502
V3_8marker | 8 | 20 | 90.0 | 4 | 0 | 0
V3_8marker | 8 | 20 | 135.0 | 4 | 0 | 0
V3_8marker | 8 | 20 | 180.0 | 0 | 0 | 0
V3_8marker | 8 | 20 | 225.0 | 0 | 0 | 0
V3_8marker | 8 | 20 | 270.0 | 0 | 0 | 0
V3_8marker | 8 | 20 | 315.0 | 4 | 0 | 0
V3_8marker | 8 | 30 | 0.0 | 4 | 0 | 0
V3_8marker | 8 | 30 | 45.0 | 8 | 1 | 1 | 0.1159 | 0.8721 | 0.3794 | 0.8448 | 1.2502
V3_8marker | 8 | 30 | 90.0 | 4 | 0 | 0
V3_8marker | 8 | 30 | 135.0 | 4 | 0 | 0
V3_8marker | 8 | 30 | 180.0 | 0 | 0 | 0
V3_8marker | 8 | 30 | 225.0 | 0 | 0 | 0
V3_8marker | 8 | 30 | 270.0 | 0 | 0 | 0
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
