LlamaLuLu/EEE4022S-AR-Spine-Registration/results/tre_analysis/archive/solver_rerun/marker_20.csv

variant | n_markers | elev | az | n_visible | tracked | noncoplanar | mc_static_mm | mc_live_mm | overlay_live_mm | fitzpatrick_mm | fitzpatrick_worst_mm
V3_8marker | 8 | 10 | 0.0 | 4 | 0 | 0
V3_8marker | 8 | 10 | 45.0 | 8 | 1 | 1 | 0.1143 | 0.8592 | 0.4427 | 0.8448 | 1.2502
V3_8marker | 8 | 10 | 90.0 | 4 | 0 | 0
V3_8marker | 8 | 10 | 135.0 | 4 | 0 | 0
V3_8marker | 8 | 10 | 180.0 | 0 | 0 | 0
V3_8marker | 8 | 10 | 225.0 | 0 | 0 | 0
V3_8marker | 8 | 10 | 270.0 | 0 | 0 | 0
V3_8marker | 8 | 10 | 315.0 | 4 | 0 | 0
V3_8marker | 8 | 20 | 0.0 | 4 | 0 | 0
V3_8marker | 8 | 20 | 45.0 | 8 | 1 | 1 | 0.1137 | 0.8549 | 0.4089 | 0.8448 | 1.2502
V3_8marker | 8 | 20 | 90.0 | 4 | 0 | 0
V3_8marker | 8 | 20 | 135.0 | 4 | 0 | 0
V3_8marker | 8 | 20 | 180.0 | 0 | 0 | 0
V3_8marker | 8 | 20 | 225.0 | 0 | 0 | 0
V3_8marker | 8 | 20 | 270.0 | 0 | 0 | 0
V3_8marker | 8 | 20 | 315.0 | 4 | 0 | 0
V3_8marker | 8 | 30 | 0.0 | 4 | 0 | 0
V3_8marker | 8 | 30 | 45.0 | 8 | 1 | 1 | 0.1141 | 0.8584 | 0.3717 | 0.8448 | 1.2502
V3_8marker | 8 | 30 | 90.0 | 4 | 0 | 0
V3_8marker | 8 | 30 | 135.0 | 4 | 0 | 0
V3_8marker | 8 | 30 | 180.0 | 0 | 0 | 0
V3_8marker | 8 | 30 | 225.0 | 0 | 0 | 0
V3_8marker | 8 | 30 | 270.0 | 0 | 0 | 0
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
