LlamaLuLu/EEE4022S-AR-Spine-Registration/data/calibration/printables/test_markers.png

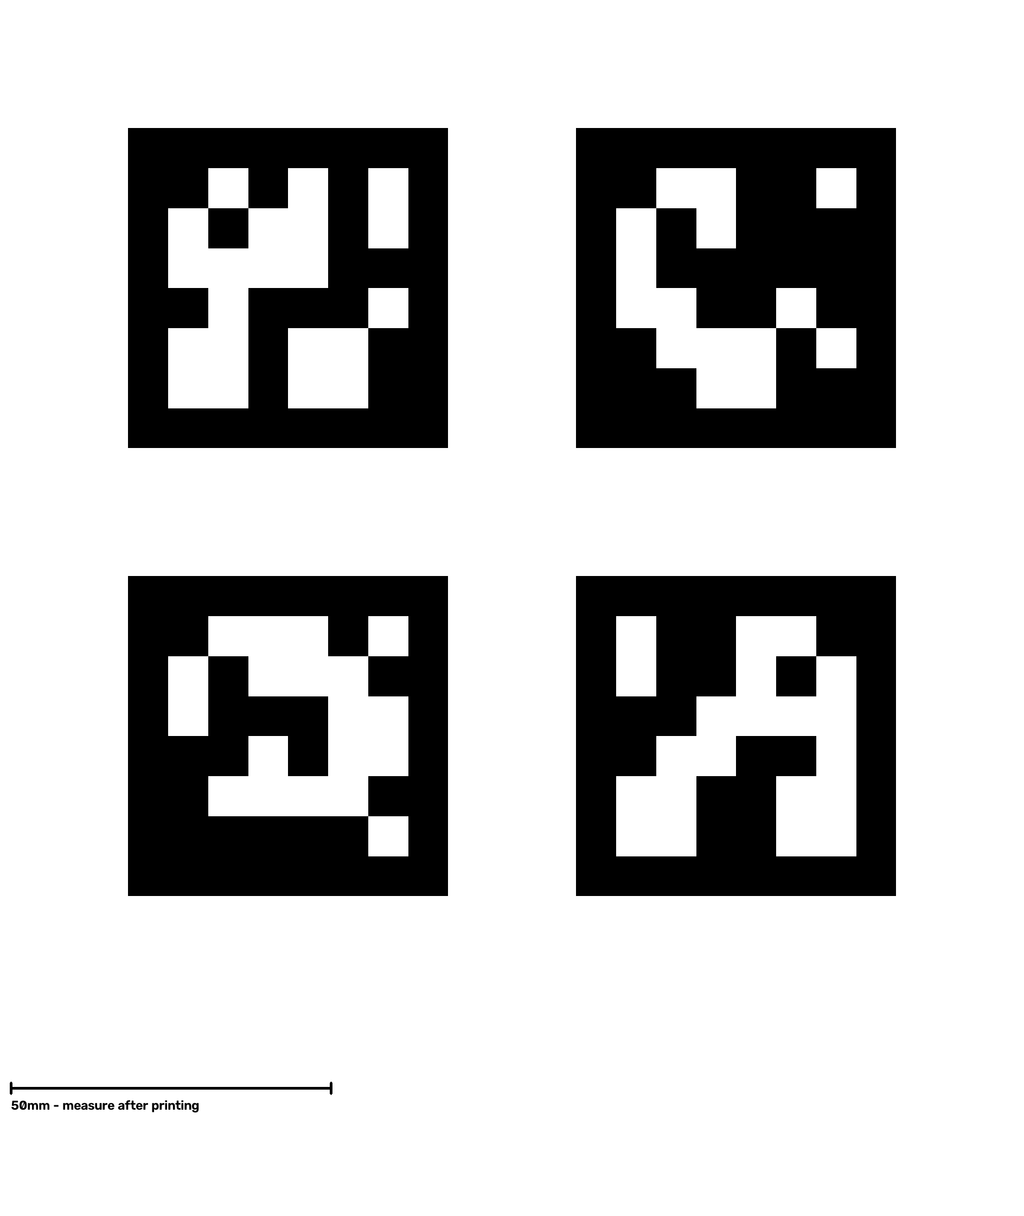
data/calibration/printables/test_markers.png
