LlamaLuLu/EEE4022S-AR-Spine-Registration/data/calibration/s22_ultra/overlay1.png

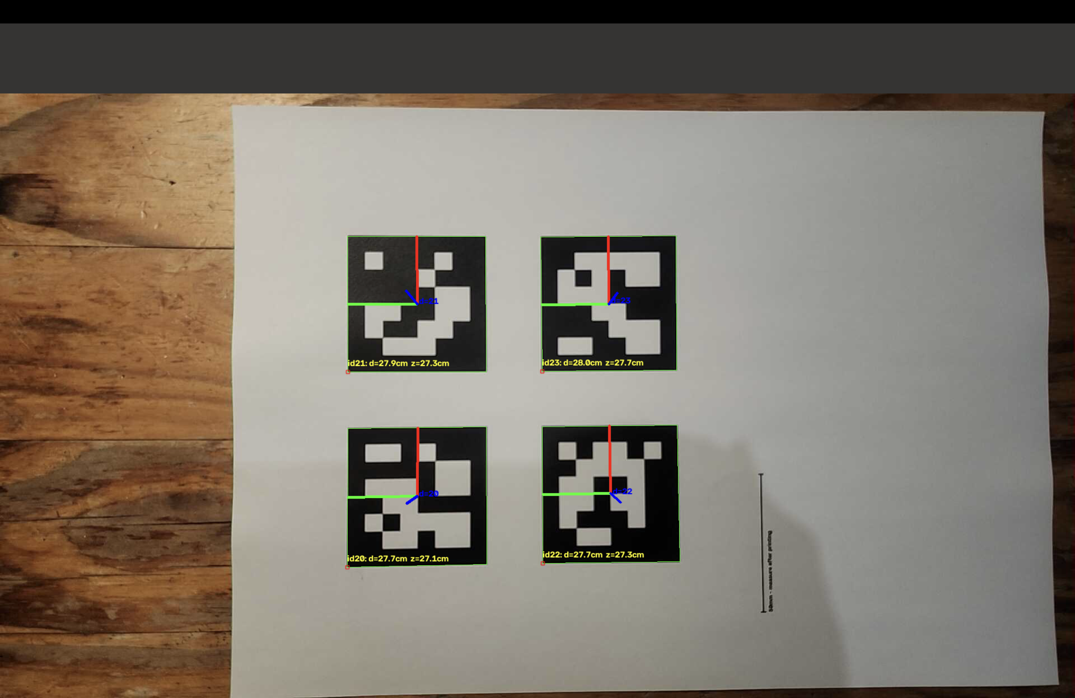
data/calibration/s22_ultra/overlay1.png
