LlamaLuLu/EEE4022S-AR-Spine-Registration/data/calibration/s22_ultra/overlay 2.png

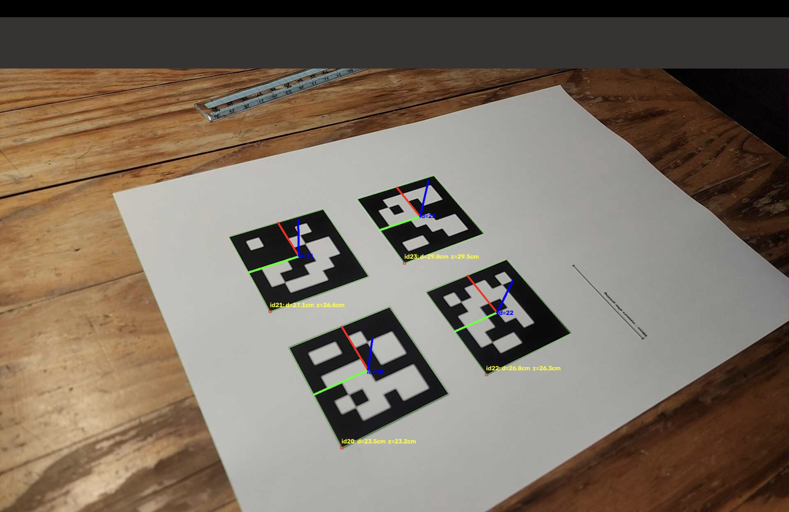
data/calibration/s22_ultra/overlay 2.png
