LlamaLuLu/EEE4022S-AR-Spine-Registration/docs/figures/calibration_board_view1.png

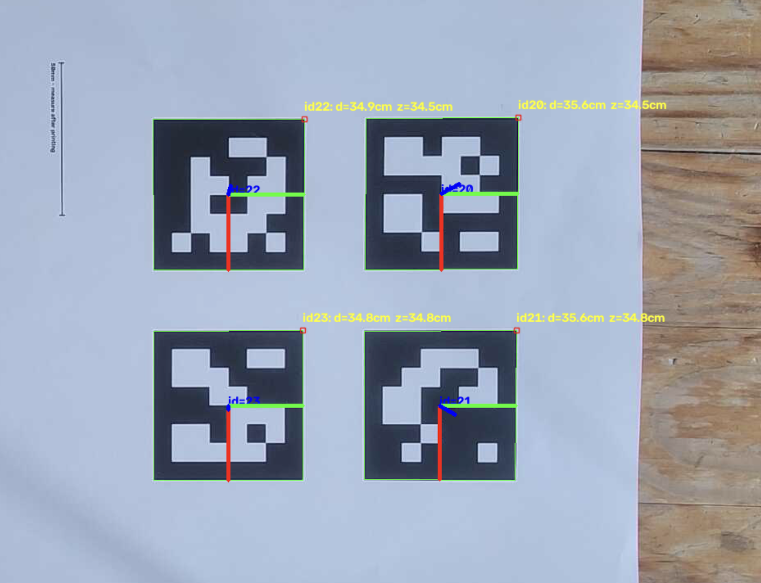
docs/figures/calibration_board_view1.png
