LlamaLuLu/EEE4022S-AR-Spine-Registration/docs/figures/click_test1.png

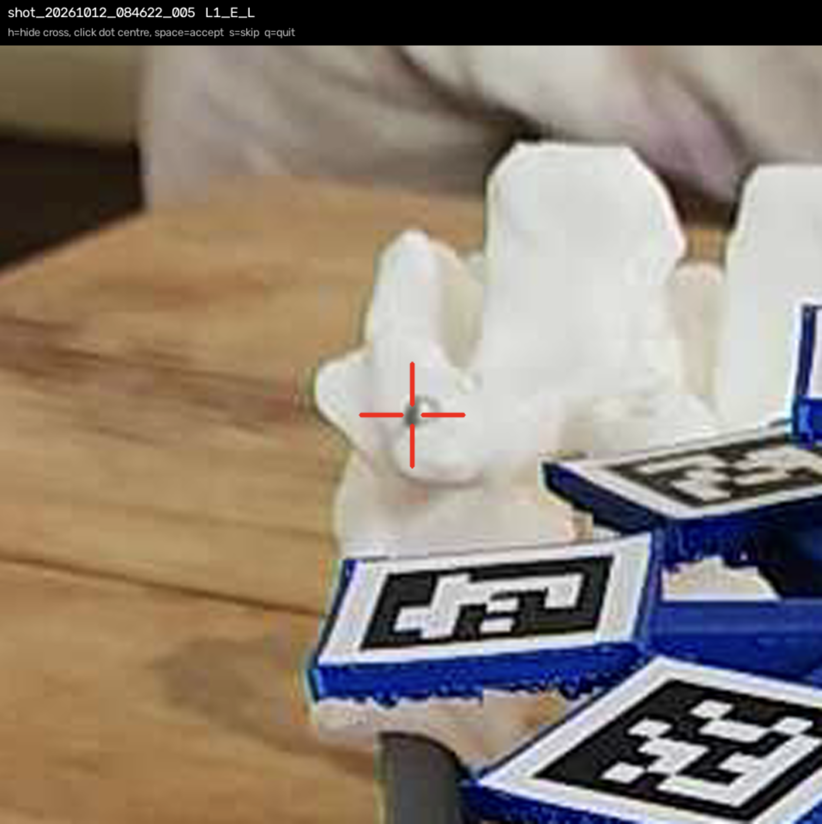
docs/figures/click_test1.png
