LlamaLuLu/EEE4022S-AR-Spine-Registration/docs/figures/fig_calibration.png

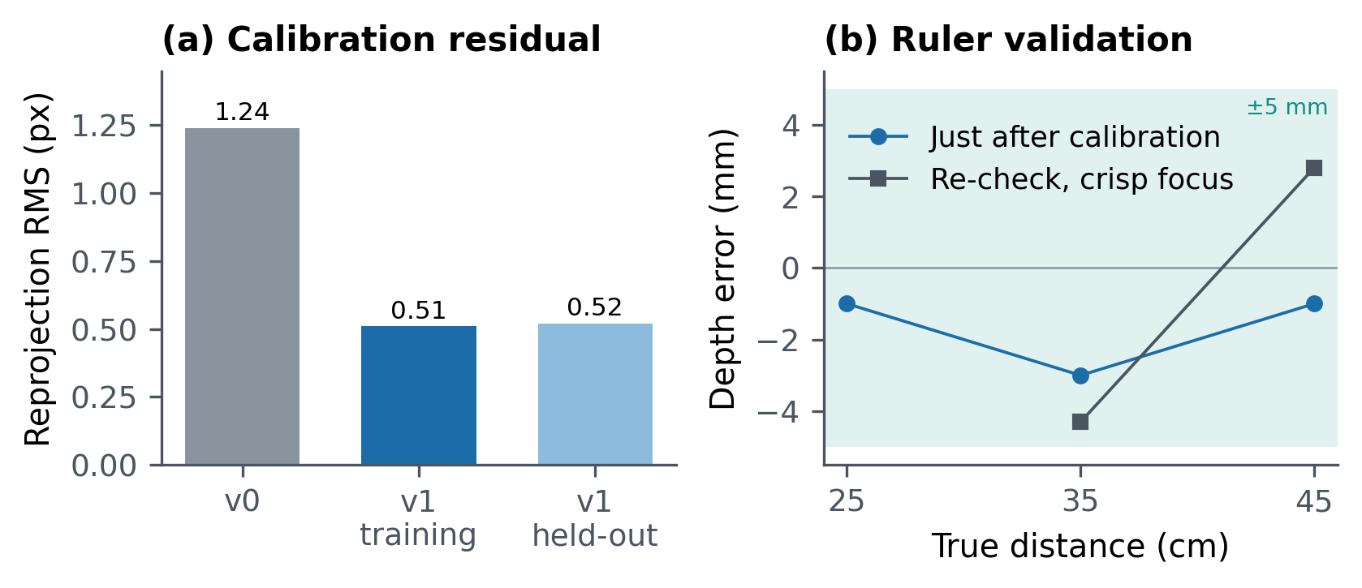
docs/figures/fig_calibration.png
