LlamaLuLu/EEE4022S-AR-Spine-Registration/docs/figures/method_architecture.pdf

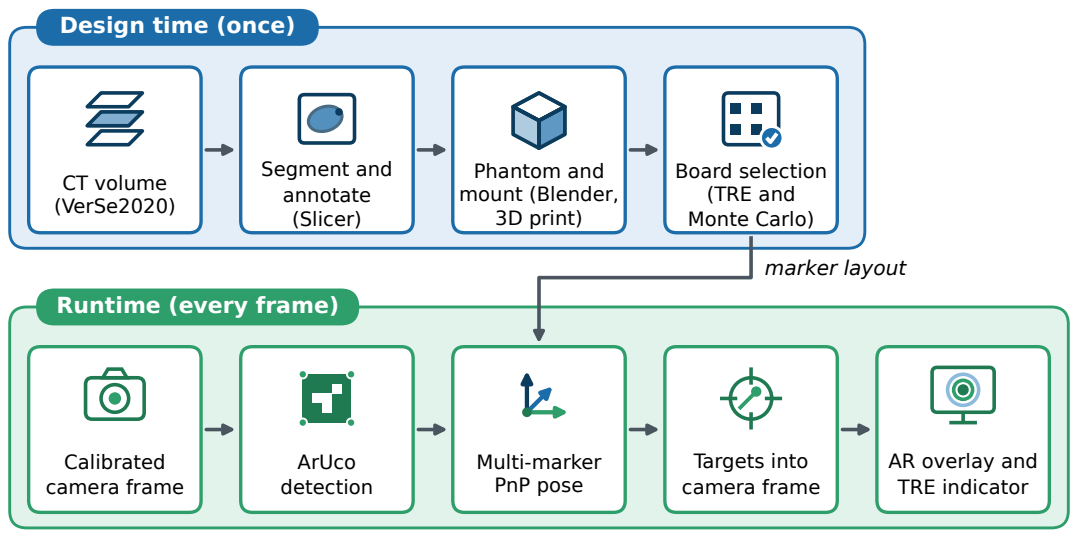
[picture p176: page 1]
CT volume (VerSe2020); Segment and annotate (Slicer); Phantom and mount (Blender, 3D print); Board selection (TRE and Monte Carlo); Calibrated camera frame; ArUco detection; Multi-marker PnP pose; Targets into camera frame; marker layout

Design time (once)

Runtime (every frame)

AR overlay and
TRE indicator
