LlamaLuLu/EEE4022S-AR-Spine-Registration/data/dome_markers/dome_markers_D1_final.pdf

# D1_final dome markers: DICT_6X6_50, 25 mm black, 32 mm cut

### ID 10 TOP

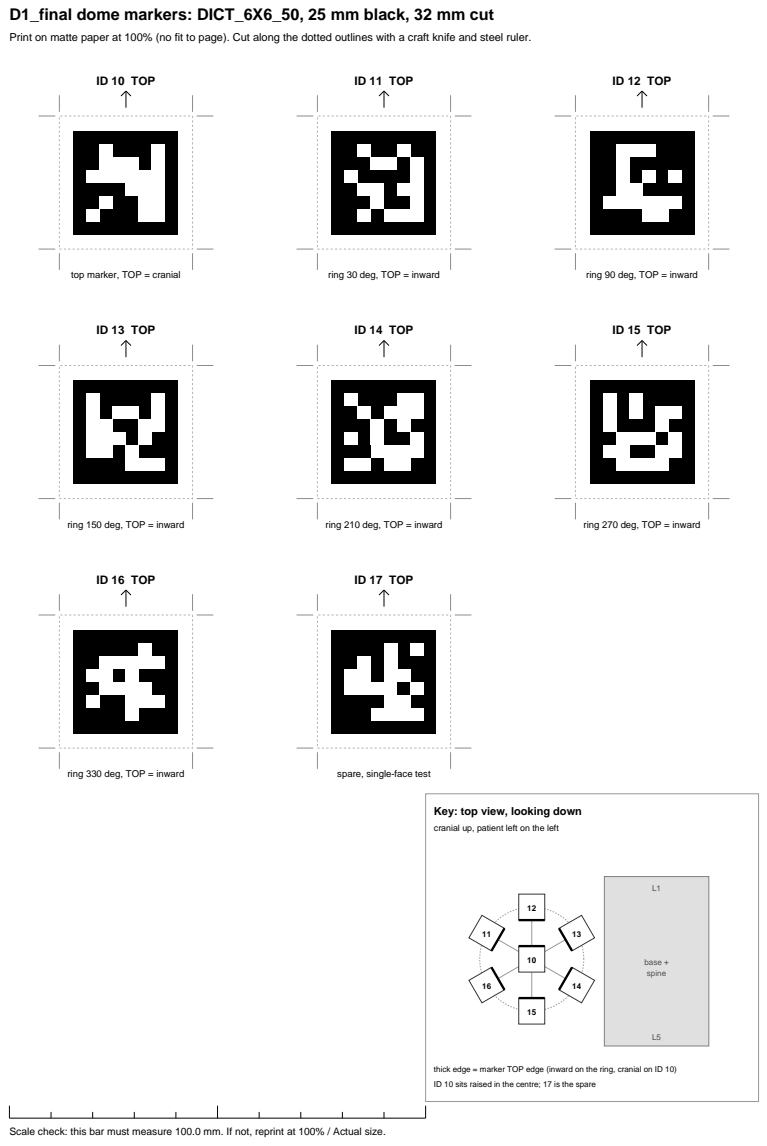
[picture p177: page 1]
ID 11 TOP; ID 12 TOP; ID 13 TOP; ID 14 TOP; ID 15 TOP; ID 16 TOP; ID 17 TOP; base + spine

Print on matte paper at 100% (no fit to page). Cut along the dotted outlines with a craft knife and steel ruler.

top marker, TOP = cranial

ring 30 deg, TOP = inward

ring 90 deg, TOP = inward

ring 150 deg, TOP = inward

ring 210 deg, TOP = inward

ring 270 deg, TOP = inward

ring 330 deg, TOP = inward

spare, single-face test

Key: top view, looking down
cranial up, patient left on the left

thick edge = marker TOP edge (inward on the ring, cranial on ID 10)
ID 10 sits raised in the centre; 17 is the spare

Scale check: this bar must measure 100.0 mm. If not, reprint at 100% / Actual size.
