LlamaLuLu/EEE4022S-AR-Spine-Registration/docs/figures/fig_atp2_by_level.pdf

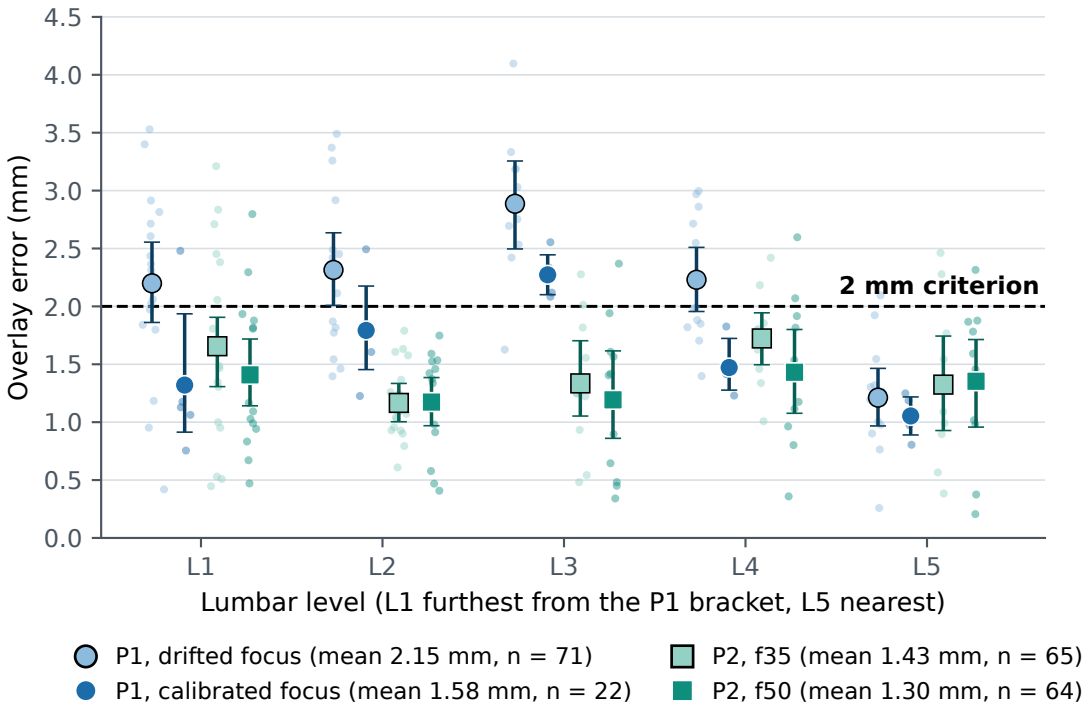
[picture p178: page 1]
2 mm criterion; P2, f35 (mean 1.43 mm, n = 65) P2, f50 (mean 1.30 mm, n = 64)

Overlay error (mm)

Lumbar level (L1 furthest from the P1 bracket, L5 nearest)

P1, drifted focus (mean 2.15 mm, n = 71)
P1, calibrated focus (mean 1.58 mm, n = 22)
