LlamaLuLu/EEE4022S-AR-Spine-Registration/docs/figures/fig_atp2_overlay_error.pdf

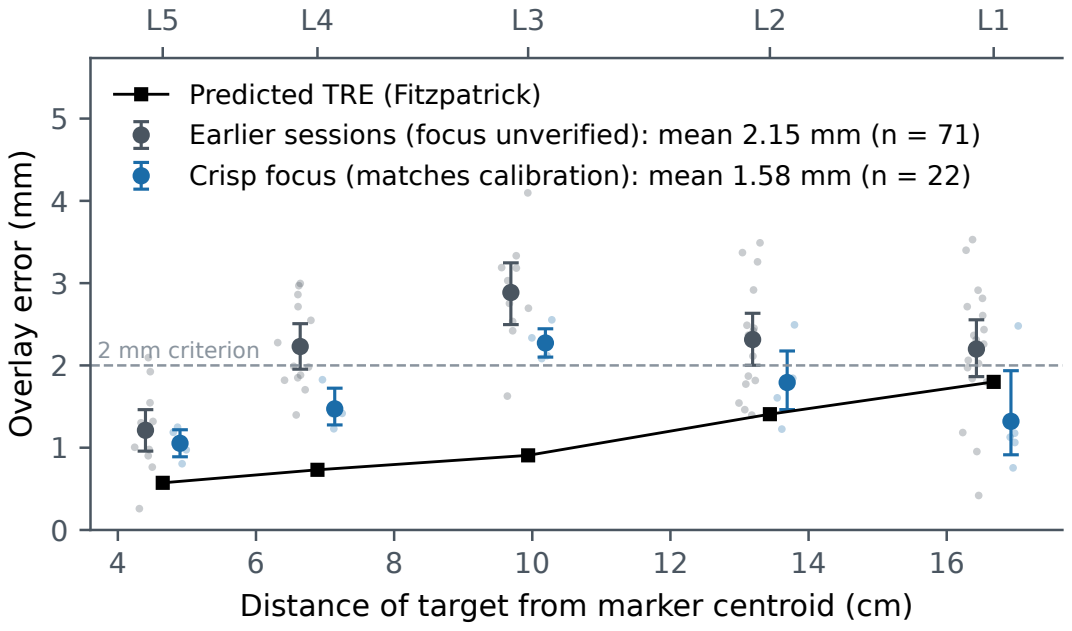
[picture p179: page 1]
2 mm criterion

Predicted TRE (Fitzpatrick)
Earlier sessions (focus unverified): mean 2.15 mm (n = 71)
Crisp focus (matches calibration): mean 1.58 mm (n = 22)

Overlay error (mm)

Distance of target from marker centroid (cm)
