LlamaLuLu/EEE4022S-AR-Spine-Registration/docs/figures/fig_atp3_tracking.pdf

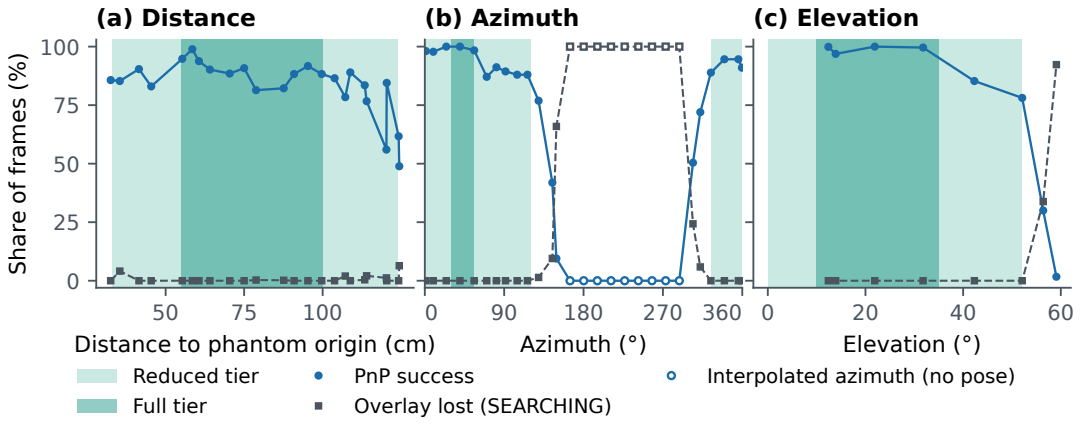
[picture p180: page 1]
(a) Distance; Azimuth (°); (b) Azimuth; Elevation (°); (c) Elevation

Share of frames (%)

Distance to phantom origin (cm)
Reduced tier
Full tier

PnP success
Overlay lost (SEARCHING)

Interpolated azimuth (no pose)
