LlamaLuLu/EEE4022S-AR-Spine-Registration/docs/figures/fig_atp4_occlusion.pdf

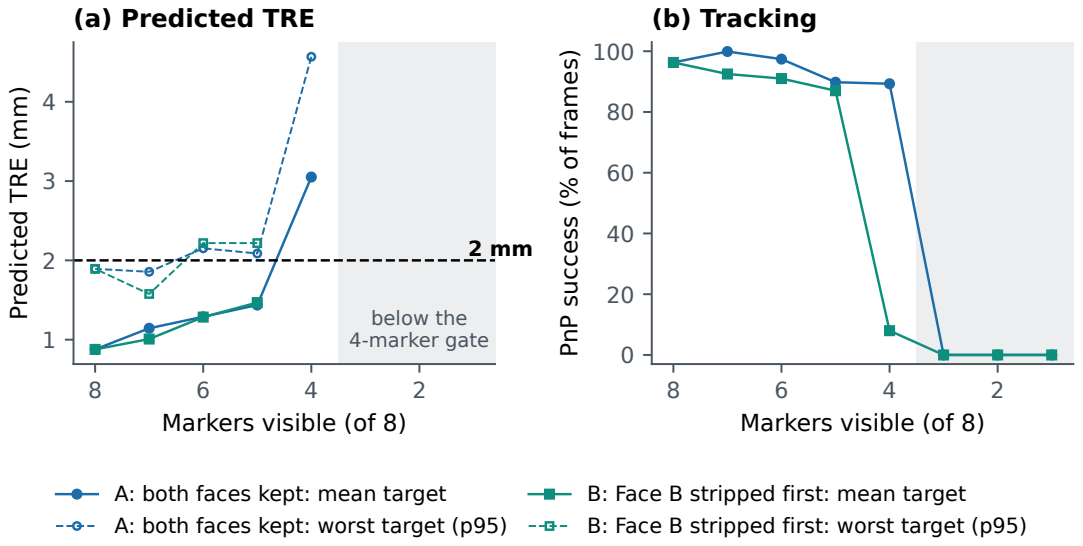
[picture p181: page 1]
below the 4-marker gate; (a) Predicted TRE; (b) Tracking

PnP success (% of frames)

Predicted TRE (mm)

Markers visible (of 8)

A: both faces kept: mean target
A: both faces kept: worst target (p95)

B: Face B stripped first: mean target
B: Face B stripped first: worst target (p95)
