LlamaLuLu/EEE4022S-AR-Spine-Registration/docs/figures/fig_envelope_3d.pdf

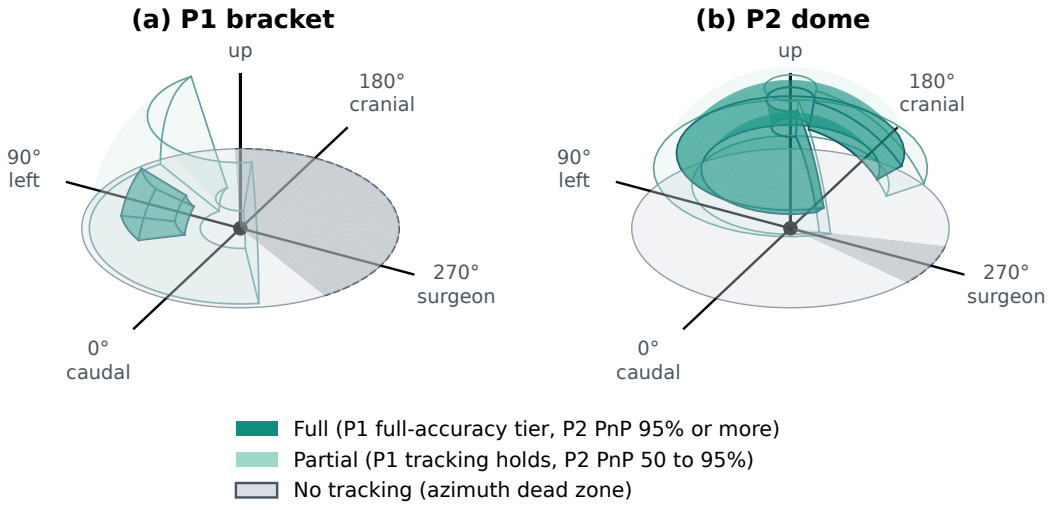
[picture p182: page 1]
0° caudal; 90° left; 180° cranial; 270° surgeon; (a) P1 bracket; (b) P2 dome

Full (P1 full-accuracy tier, P2 PnP 95% or more)
Partial (P1 tracking holds, P2 PnP 50 to 95%)
No tracking (azimuth dead zone)
