LlamaLuLu/EEE4022S-AR-Spine-Registration/docs/figures/fig_envelope_p1p2.pdf

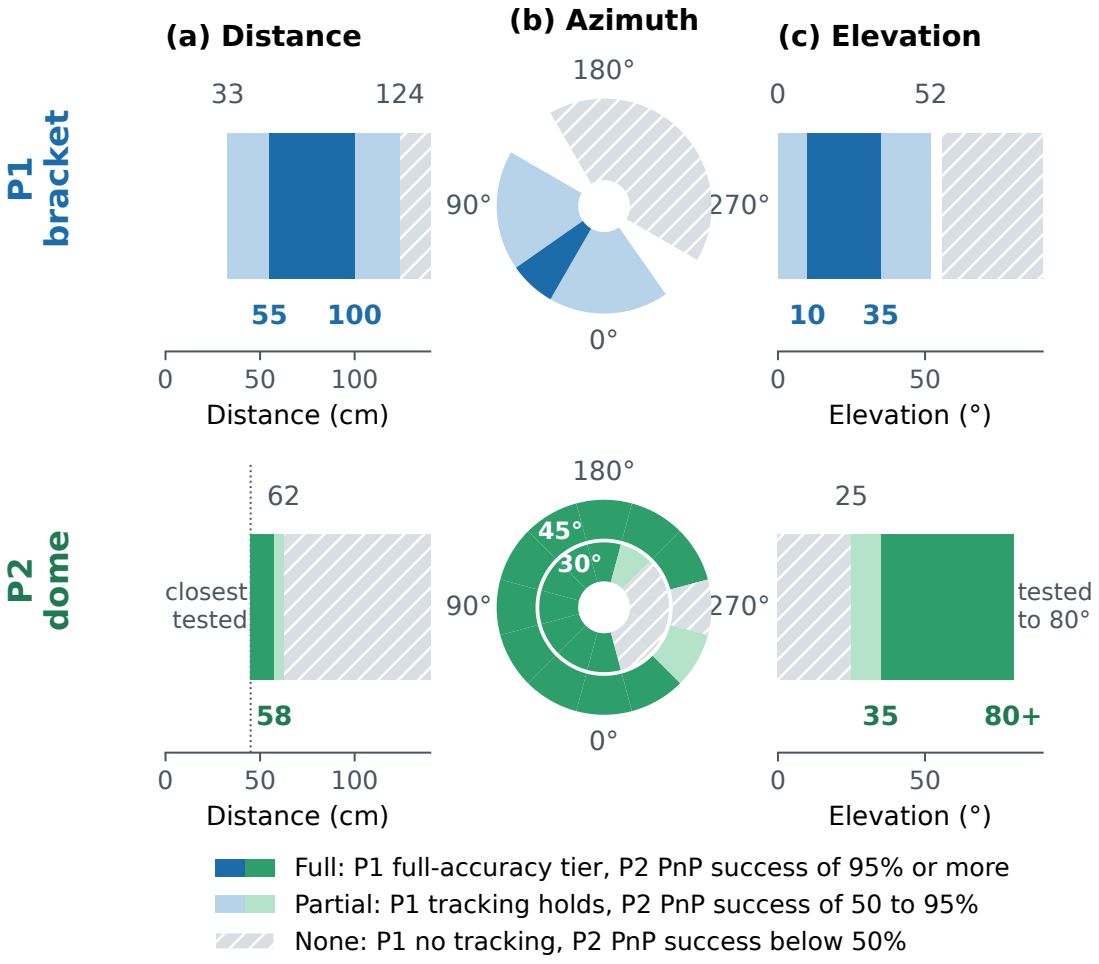
[picture p183: page 1]
Distance (cm); (a) Distance; Elevation (°); (c) Elevation; (b) Azimuth; closest tested; tested to 80°; bracket; dome

Full: P1 full-accuracy tier, P2 PnP success of 95% or more
Partial: P1 tracking holds, P2 PnP success of 50 to 95%
None: P1 no tracking, P2 PnP success below 50%
