LlamaLuLu/EEE4022S-AR-Spine-Registration/docs/figures/fig_p2_range.pdf

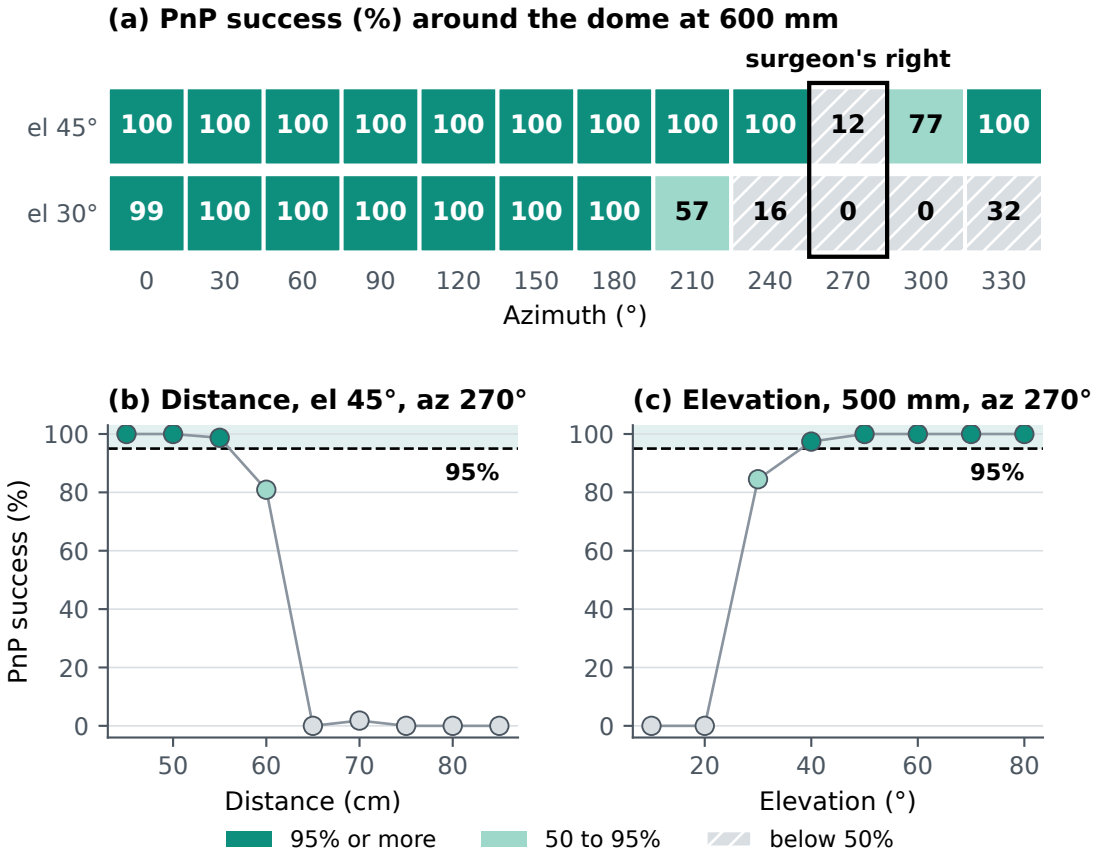
[picture p184: page 1]
Azimuth (°); surgeon's right; Distance (cm); PnP success (%); Elevation (°); 95% or more; below 50%

(a) PnP success (%) around the dome at 600 mm

(b) Distance, el 45°, az 270°

(c) Elevation, 500 mm, az 270°
