LlamaLuLu/EEE4022S-AR-Spine-Registration/docs/figures/fig_p2_range_row.pdf

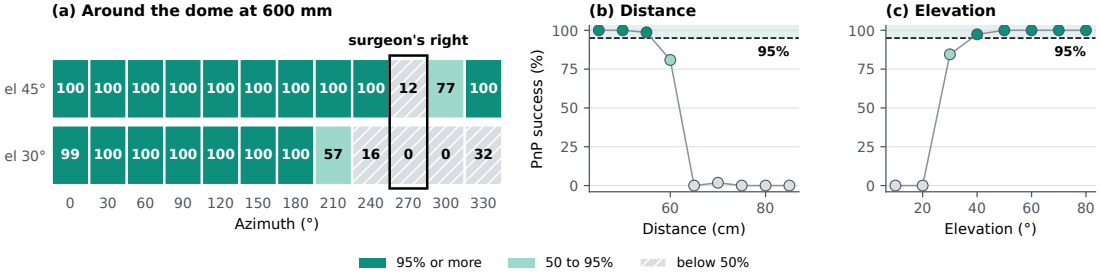
[picture p185: page 1]
Azimuth (°); surgeon's right; Distance (cm); PnP success (%); (b) Distance; Elevation (°); (c) Elevation; 95% or more; below 50%

(a) Around the dome at 600 mm
