LlamaLuLu/EEE4022S-AR-Spine-Registration/docs/figures/fig_sweep_grids.pdf

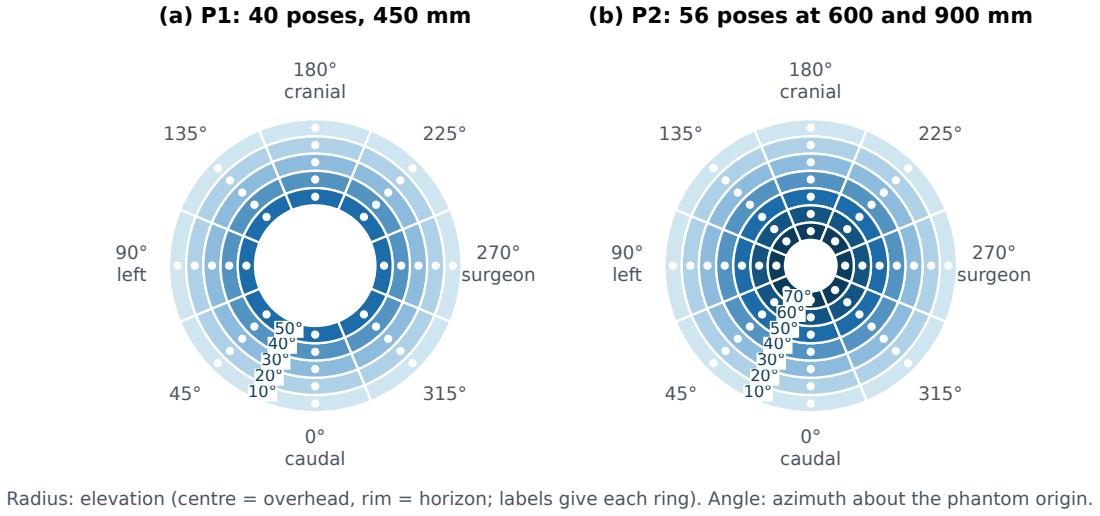
[picture p186: page 1]
0° caudal; 90° left; 180° cranial; 270° surgeon; (a) P1: 40 poses, 450 mm

(b) P2: 56 poses at 600 and 900 mm

Radius: elevation (centre = overhead, rim = horizon; labels give each ring). Angle: azimuth about the phantom origin.
