LlamaLuLu/EEE4022S-AR-Spine-Registration/docs/figures/method_cycles.pdf

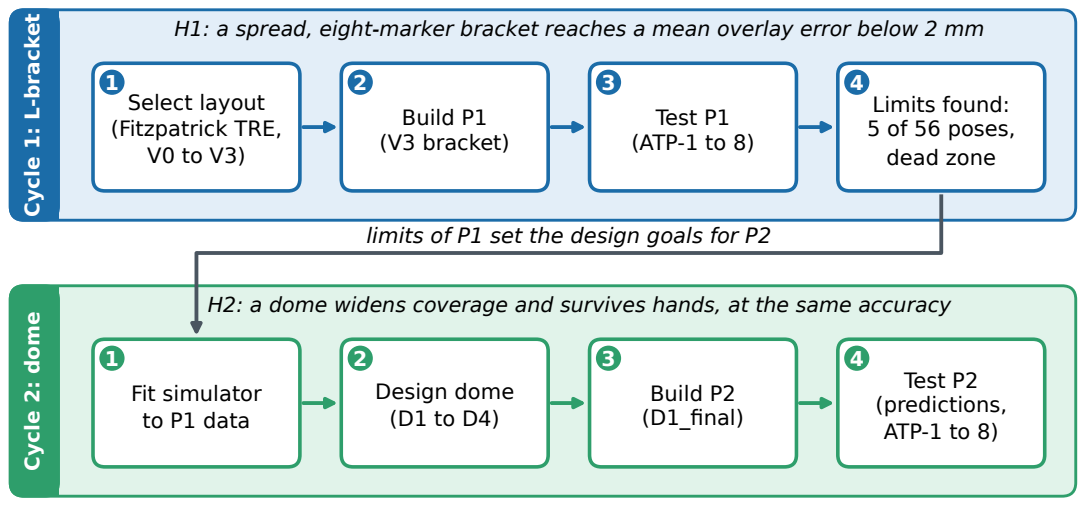
[picture p187: page 1]
Select layout (Fitzpatrick TRE, V0 to V3); Build P1 (V3 bracket); Test P1 (ATP-1 to 8); Limits found: 5 of 56 poses, dead zone; Fit simulator to P1 data; Design dome (D1 to D4); Build P2 (D1_final); Test P2 (predictions, ATP-1 to 8)

Cycle 1: L-bracket Cycle 2: dome

H1: a spread, eight-marker bracket reaches a mean overlay error below 2 mm

limits of P1 set the design goals for P2

H2: a dome widens coverage and survives hands, at the same accuracy
