LlamaLuLu/EEE4022S-AR-Spine-Registration/docs/figures/fig_method_mcflow.pdf

Measured inputs | Simulation | Used for

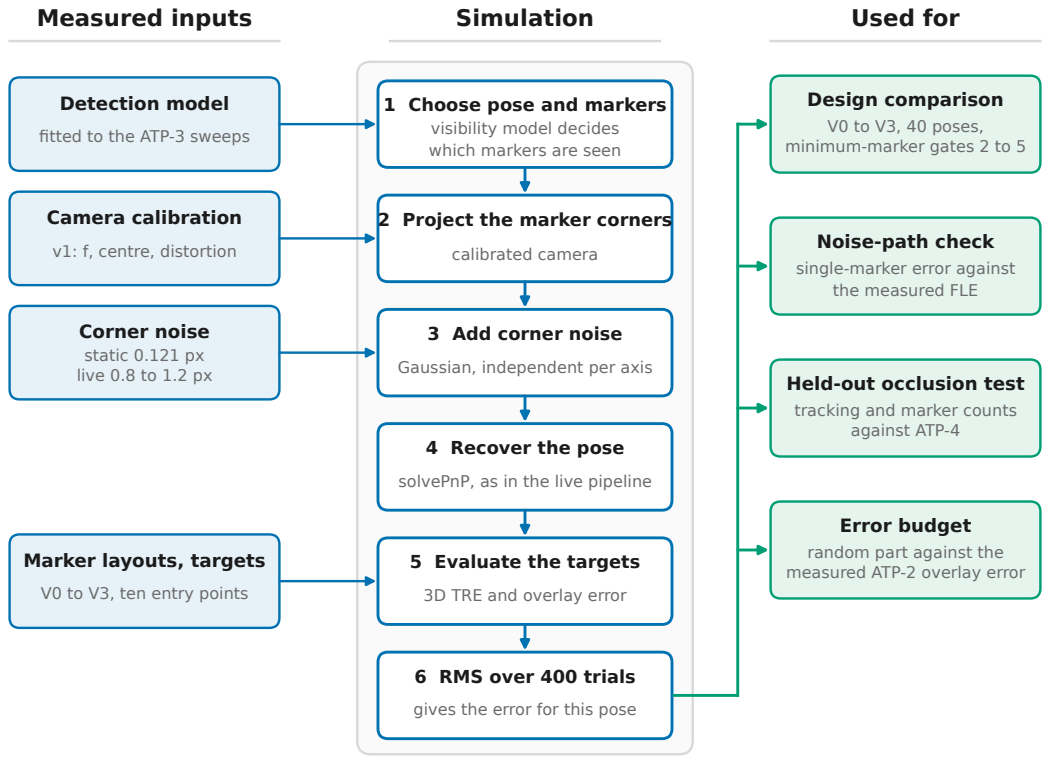
[picture p188: page 1]
calibrated camera; Camera calibration; v1: f, centre, distortion

Detection model
fitted to the ATP-3 sweeps

1 Choose pose and markers
visibility model decides
which markers are seen

Design comparison
V0 to V3, 40 poses,
minimum-marker gates 2 to 5

2 Project the marker corners

Noise-path check
single-marker error against
the measured FLE

Corner noise
static 0.121 px
live 0.8 to 1.2 px

3 Add corner noise
Gaussian, independent per axis

Held-out occlusion test
tracking and marker counts
against ATP-4

4 Recover the pose
solvePnP, as in the live pipeline

Error budget
random part against the
measured ATP-2 overlay error

Marker layouts, targets
V0 to V3, ten entry points

5 Evaluate the targets
3D TRE and overlay error

6 RMS over 400 trials
gives the error for this pose
