LlamaLuLu/EEE4022S-AR-Spine-Registration/docs/figures/fig_mc_tracking_validation.pdf

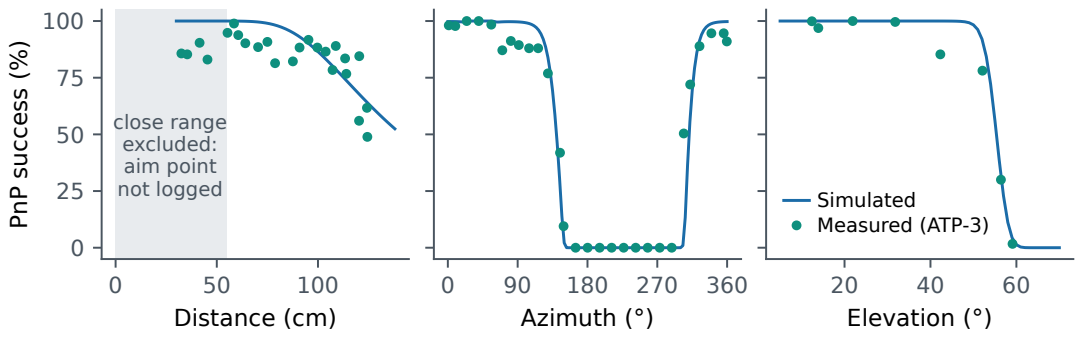
[picture p189: page 1]
Distance (cm); PnP success (%); close range excluded: aim point not logged; Azimuth (°); Elevation (°); Simulated Measured (ATP-3)
