LlamaLuLu/EEE4022S-AR-Spine-Registration/docs/ui_wireframes_sheet.pdf

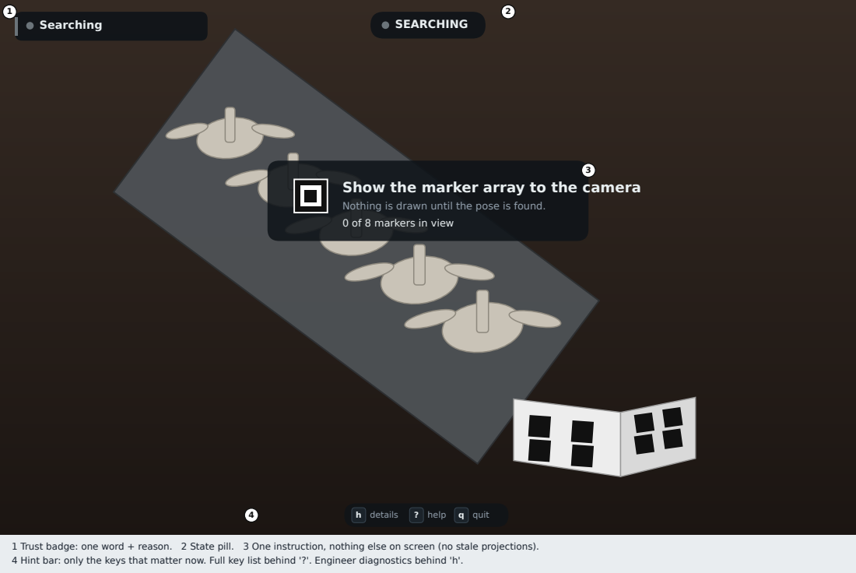
[picture p190: page 1]
Searching; SEARCHING; h details; ? help; q quit

Show the marker array to the camera
Nothing is drawn until the pose is found.
0 of 8 markers in view

1 Trust badge: one word + reason. 2 State pill. 3 One instruction, nothing else on screen (no stale projections).
4 Hint bar: only the keys that matter now. Full key list behind '?'. Engineer diagnostics behind 'h'.

## Does the outline sit on the bone?

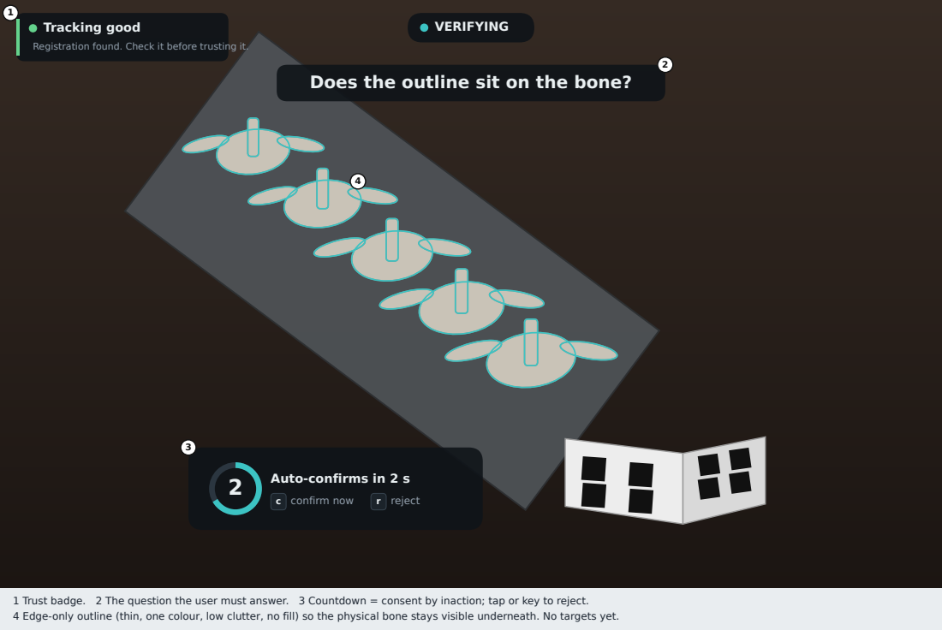
[picture p191: page 2]
Tracking good; VERIFYING; c confirm now; r reject

Registration found. Check it before trusting it.

Auto-confirms in 2 s

1 Trust badge. 2 The question the user must answer. 3 Countdown = consent by inaction; tap or key to reject.
4 Edge-only outline (thin, one colour, low clutter, no fill) so the physical bone stays visible underneath. No targets yet.

## Choose a level to see its screw paths

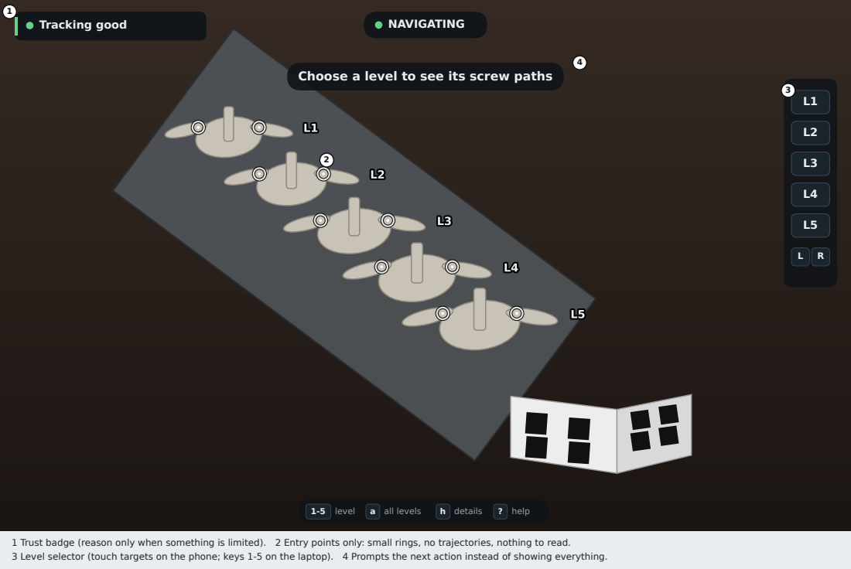
[picture p192: page 3]
Tracking good; NAVIGATING; 1-5 level; a all levels; h details; ? help

1 Trust badge (reason only when something is limited). 2 Entry points only: small rings, no trajectories, nothing to read.
3 Level selector (touch targets on the phone; keys 1-5 on the laptop). 4 Prompts the next action instead of showing everything.

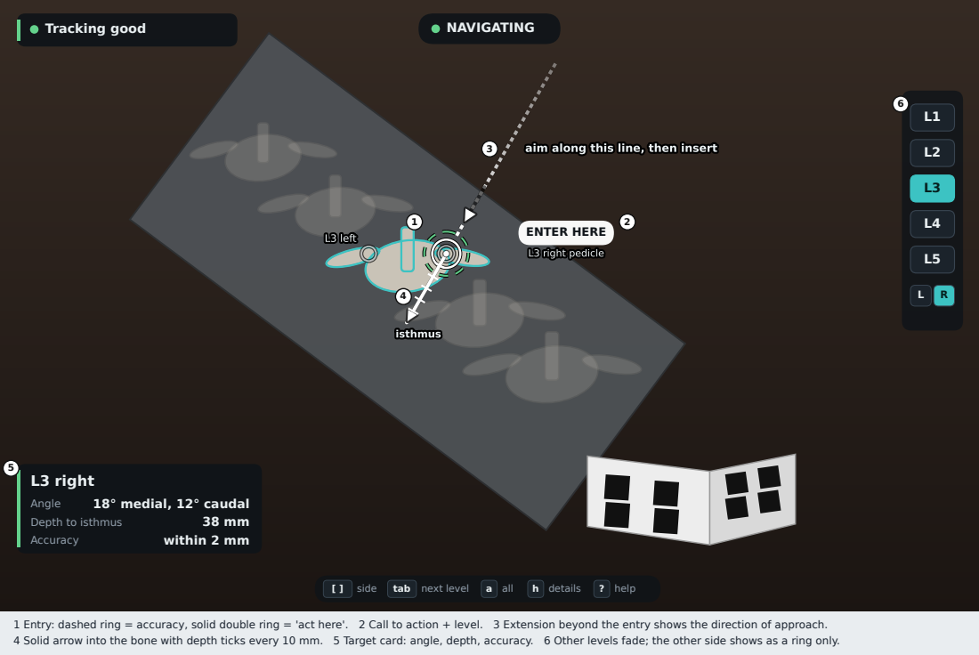
[picture p193: page 4]
Tracking good; NAVIGATING; L3 right; Angle; 18° medial, 12° caudal; Depth to isthmus; Accuracy; within 2 mm; side; tab next level; a all; h details; ? help; ENTER HERE

1 Entry: dashed ring = accuracy, solid double ring = 'act here'. 2 Call to action + level. 3 Extension beyond the entry shows the direction of approach.
4 Solid arrow into the bone with depth ticks every 10 mm. 5 Target card: angle, depth, accuracy. 6 Other levels fade; the other side shows as a ring only.

Tracking lost | STALE

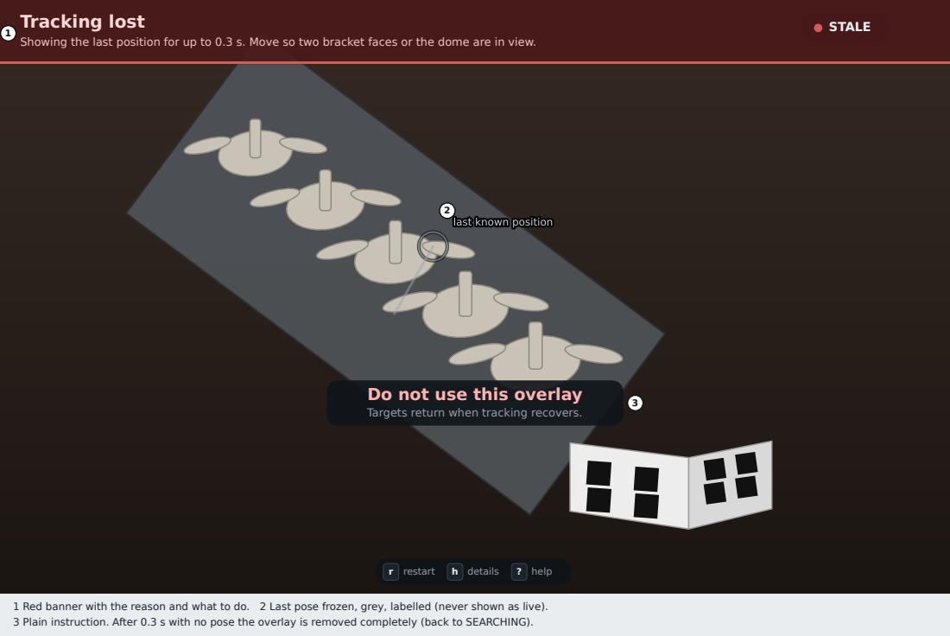
[picture p194: page 5]
r restart; h details; ? help

Showing the last position for up to 0.3 s. Move so two bracket faces or the dome are in view.

Do not use this overlay
Targets return when tracking recovers.

1 Red banner with the reason and what to do. 2 Last pose frozen, grey, labelled (never shown as live).
3 Plain instruction. After 0.3 s with no pose the overlay is removed completely (back to SEARCHING).
