LlamaLuLu/EEE4022S-AR-Spine-Registration/docs/figures/lit_fre_tre_layout.pdf

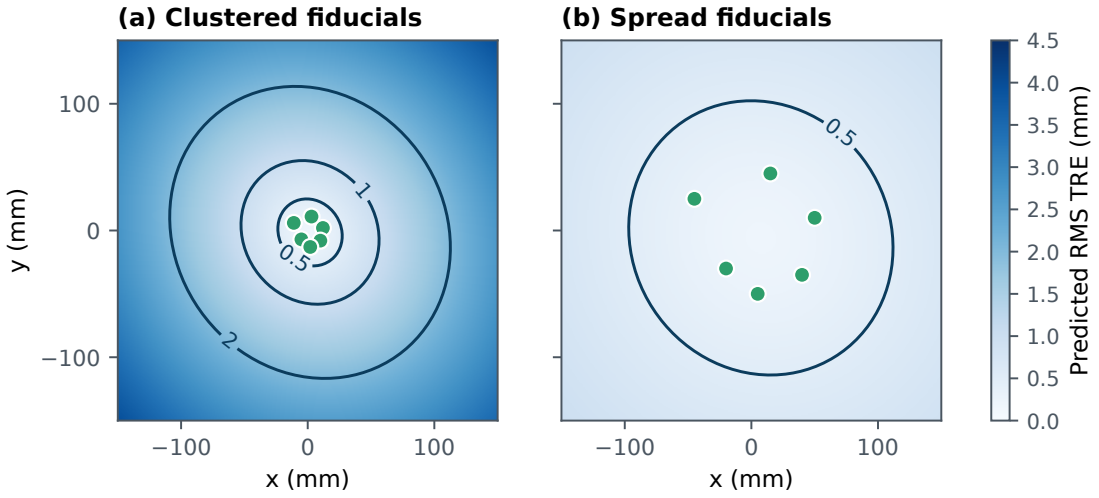
[picture p195: page 1]
(a) Clustered; fiducials 0.5; (b) Spread; fiducials0.5

Predicted RMS TRE (mm)
