LlamaLuLu/EEE4022S-AR-Spine-Registration/(commit log)

2026-08-08 Added stage 2 filter script for VerSe shortlist ranking
2026-08-11 Scoped MVP targets to pedicle isthmus centres; defer 3-point trajectories for future prototype iterations
2026-08-15 Added phantom design
    - L1-L5 STL meshes, Blender assembly with base plate, tabs, bridge
    - still need to refine before sending for printing
2026-08-24 Track 2 baseline pipeline v0 complete, phantom v0 ready to print
    Pipeline (scripts/calibration/, scripts/registration/)
    - ChArUco board + test marker generator with PDF export and printed
    50mm scale bar for verifying print scale
    - Live capture with on-screen corner count and detection status
    - Camera intrinsics calibration via matchImagePoints + calibrateCamera
    (OpenCV 5 API, replaces removed calibrateCameraCharuco)
    - Live ArUco detection with solvePnP and axis overlay, tvec readout
    on screen and throttled to stdout
    - All four scripts support phone stream, USB index, and --rotate flag
    - DICT_6X6_50 across all scripts, tighter inter-marker Hamming distance
    than DICT_6X6_250 for the sm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
2026-09-13 Add TRE analysis simulation pipeline (Fitzpatrick + Monte Carlo)
    Predicts Target Registration Error at pedicle targets for candidate marker
    board layouts before physical construction, so only the winning design gets
    3D printed.
    Scripts:
    - fitzpatrick_tre.py: closed-form TRE predictor (Fitzpatrick 1998 eq 46)
    - design_variants.py: V0-V3 marker layouts + pedicle target loader
    - evaluate_designs.py: runs Fitzpatrick across variants, produces CSV
    - monte_carlo_tre.py: simulates PnP with noisy corners to validate ranking
    - measure_fle.py: empirical FLE from static-board frames
    - README.md: pipeline description, coordinate convention, usage
    Physical FLE capture and board-generation scripts to fo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
2026-09-14 Add camera-pose sweep and geometry-aware Monte Carlo visibility
    Adds angle-based and occlusion-based marker visibility filtering to
    Monte Carlo before running PnP per trial. Occlusion approximates the
    phantom as a Z-aligned cylinder (radius 50mm), replacing an earlier
    bounding box that over-occluded empty corner regions.
    New script sweep_camera_poses.py runs MC across a grid of camera
    elevations/azimuths to quantify pose-robustness instead of testing a
    single fixed viewpoint.
    Fixed a left-handed camera basis bug in make_camera_pose that silently
    misplaced the simulated camera (caught via det(R) = -1).
    Updated design_variants.py / design_variants_oriented.py marker
    positions to match the a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
2026-09-15 feat(registration): scaffold live AR overlay pipeline
    Split live overlay into focused modules under scripts/registration/:
    live_ar_overlay (orchestrator + state machine), ar_board (corner LUT,
    multi-marker solvePnP, pose decomposition), ar_tre (scalar + covariance
    + image-plane ellipse), ar_overlay (crosshairs, trajectories, wireframe,
    HUD), ar_targets (dual-JSON loader + trajectory pairing), ar_stl
    (binary/ASCII loader with backface-cull normals).
    Add generate_bracket_markers.py: per-slot PNGs, A4 print-ready PDF with
    20mm markers by face and slot, cut guides, 50mm verification ruler, and
    marker_map.json for ID-to-slot resolution.
    Re-annotate pedicle targets in Slicer as separate isthmus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
2026-09-16 feat(overlay): themed HUD, axis triad, target radar
    Rebuild HUD with flat dark panels, thin teal accent bars, and compact
    label/value rows inspired by clinical navigation aesthetics (7D, Medivis).
    Add live LPS orientation gizmo (red X / green Y / blue Z axes rotated
    by current camera pose) and per-pedicle target radar showing worst-case
    TRE status per level and side.
    Buffer all Pillow text rendering into a single RGBA overlay flushed once
    per frame, eliminating per-draw BGR/RGB conversions.
    Frame now resized crop-to-fill to eliminate letterbox padding, window
    close via X button or Q, ESC toggles shortcut panel (visible by default).
    New keys: g axis gizmo, x target radar, esc toggle help.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
2026-09-16 feat(registration): migrate live overlay to PySide6
    Rebuild the display layer as Qt widgets styled with QSS while keeping
    the OpenCV pipeline (detection, PnP, TRE) untouched. Widgets only
    repaint when their input values change, eliminating the per-frame full
    redraw that made the cv2 version laggy.
    - ar_qt_styles: QSS palette mirroring ar_theme, monospace + sans stacks
    - ar_qt_hud: StatusPanel, PosePanel, TrePanel, StatePill, ShortcutsPanel,
    AxisTriadWidget, TargetRadarWidget as themed QFrame / QWidget subclasses
    - live_ar_overlay_qt: QMainWindow entry point with QTimer frame loop,
    video shown in a QLabel with HUD widgets parented directly to it
    Layout: status top-left, axis triad + pos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
2026-09-16 perf(overlay): add frame timing, buffer fix, USB tether docs
    Add per-frame perf_counter instrumentation logging grab/detect/overlay/qt
    timing and FPS once per second to terminal.
    Set CAP_PROP_BUFFERSIZE=1 to discard stale frames from the OpenCV
    internal buffer, reducing perceived latency on WiFi streams.
    Fix timing clock mismatch (time.time vs perf_counter) that silenced
    the log output.
    Update README: Qt version as primary entry point, USB tethering setup
    via adb forward (consistent 3-5ms grab, 30 FPS vs 15-17 FPS over WiFi),
    full module reference, HUD layout diagram, measured performance table.
2026-09-21 fix(geometry): correct bracket model to match physical L-bracket v1.3
    Three root causes of the ~100px multi-marker RMS identified and fixed:
    1. Face positions wrong: Face A at Z=-103.7 (was -95), Face B at
    X=70.1 (was +30), junction at X=70.1/Z=-103.7
    2. Face B direction flipped: extends cranially (+Z) from junction,
    not caudally (-Z) as originally modeled
    3. Face block orientation: left column of Face A is near junction,
    left column of Face B is far from junction. Both _fA/_fB and
    R_FACE_A/R_FACE_B updated to match physical placement.
    Multi-marker RMS: ~100px → 0.7-1.5px (8/8 markers).
    Other changes in this commit:
    - Threaded FrameGrabber eliminates FFmpeg buffer lag (grab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
2026-09-27 Setting up scripts for ATPs
    Record values between frames
    Updating camera calibration script to show more detailed readings
2026-09-28 feat(atp2): overlay error measurement with pose-saving screenshots
    - Screenshots now save a clean frame and camera pose (_clean.png,
    _pose.json) for offline measurement
    - Add measure_overlay_error.py: click ground-truth dots, compute
    in-plane error at target depth, triangulate 3D error across views
    - Fix state machine: brief PnP dropouts resume the previous state
    instead of restarting the verify countdown
    - Add entry-point reference dots to phantom .blend
    ATP-2 result (after reseating vertebrae): mean in-plane error
    1.68 mm, max 2.81 mm, 37 measurements across 7 views.
2026-09-30 feat(atp3): measured operating envelope and 3-tier HUD; feat(atp2): hidden-cross overlay error measurement
    - ATP-3 sweeps: usable distance 55-100 cm, azimuth 30-55 deg
    (both faces), elevation 10-35 deg; dead zone ~150-300 deg az
    and above ~56 deg elevation
    - ar_theme: measured full/reduced envelope, envelope_tier()
    - HUD: Zone row, targets capped at amber in reduced tier;
    fix stale colours when tier changes without text change
    - Log env_tier per frame and in screenshot pose JSON
    - analyse_atp_log: --by-step, --by-tier, --trim/--trim-end,
    dropout duration and lost-tracking metrics
    - measure_overlay_error: per-tier accuracy summary
    - Step counter key ('n') and printable azimuth dial
    -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
2026-10-01 feat(atp1.2,atp5): single-face check and wireframe alignment results
    - check_single_face.py: per-face RMS, wrong-side frame count, fresh
    acquisition count, and pose consistency across re-locks (catches
    tilt flips that the side check cannot see)
    - Overlay logs amb_rejected per frame (single-face side check)
    ATP-1.2: 0 of 24,358 accepted single-face frames on the wrong side;
    33 fresh acquisitions at 2-25 deg elevation, max pose change 1.1 deg
    at re-lock; safeguard never triggered.
    ATP-5: wireframe alignment 2 Good, 2 Fair, 0 Poor over 4 views.
2026-10-01 feat(atp6): timing and latency results
    - analyse_atp_log: --timing view (FPS and per-stage ms per step)
    ATP-6.1: 30.4 FPS wireframe on (29.7 ms/frame), 31.3 FPS off (10.6 ms).
    ATP-6.2: glass-to-glass latency 182 ms mean (SD 43, n=11), 3 of 11
    above 200 ms; software is ~6-16% of it, remainder is camera/stream.
2026-10-01 feat(atp7,atp8): lighting robustness and repeatability
    - analyse_repeatability: per-cycle RMS/TRE, pose scatter across cycles
    ATP-7: 100% PnP and 0% lost in normal, dim, bright, shadow conditions.
    ATP-8: 12 re-registrations, RMS 0.87 +/- 0.03 px (CV 3.4%), pose scatter
    0.59 mm / 0.05 deg, predicted TRE < 2 mm in every cycle.
2026-10-03 Add MC validation, method figures, true plate footprint
    - mc_validation.py: fit, design, atp2, atp4, fle, figs; per-shot noise;
    drops the end-of-run ATP-3.3 step from the fit
    - make_method_figures.py: variants, state machine, MC flow, detection model
    - make_report_figures.py, generate_azimuth_dial.py: BASE_v2 plate and
    bracket-seat outline
    - regenerate MC figures; add design_sweep.csv
2026-10-05 Add dome marker designs and SQPNP-based design sweeps
    * design_variants_oriented: add dome_oriented generator, DOME_CONFIGS
    (D1 to D6, D1_final) and build_dome; default dome tilt 5 deg; fix
    mirrored R_FLAT_UP (det was -1) and assert det = +1 on all frames
    * mc_validation: add tilt subcommand, hand/forearm occlusion stand-in
    (--hands), non-coplanarity test replacing per-face counts,
    --marker-mm, --elevs, --az-step, --variants; switch solver to
    SOLVEPNP_SQPNP via PNP_FLAG (ITERATIVE failed on near-planar sets)
    * ring_sweep: ring radius and top-marker height sweeps, ITERATIVE vs
    SQPNP at 600 and 900 mm
    * results: new design, tilt and marker-size sweeps (SQPNP, 5 deg tilt);
    earlier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
2026-10-06 Add D1_final dome CAD, marker generator and updated sweeps
    * phantom/meshes: add dome STLs (DOME, base_dome, dome_face test piece,
    gusset, spine_phantom_dome assembly); update spine_phantom_v1.blend
    * phantom renders: fix "phaontom" filename typo, add v1.0 and v2.0 to v2.2
    * design_variants_oriented: D1_final moved to centre (120, 105, 0) with the
    ring rotated 30 deg, to clear the left transverse processes and the
    screw-driver corridor
    * results: rerun 25 mm design sweeps at 600 and 900 mm for the final
    D1_final geometry
    * scripts/markers: move generate_bracket_markers.py here from registration,
    add generate_dome_markers.py (IDs 10 to 17, 25 mm markers on 32 mm
    stickers with cut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
2026-10-06 Fix: STL file of dome had issues with some objects when slicing
2026-10-11 feat(UI): added improvements for isolated vertebrae select mode and better trajectory indicator
    Printed dome structure (still has issue after slicing, need to reprint eventually but not hindrance to ATPs)
    Changing ring marker orientation to all face inwards
    Starting out with ATPs
2026-10-12 Add dome support to MC simulator and ATP-2 to ATP-4 analysis scripts
    mc_validation.py: add --marker-map/--variant and predict command; atp2 runs on the as-built dome. fit and atp4 remain V3 only.
    measure_overlay_error.py: load dome maps via load_corner_lut (distance and predicted TRE were computed against the V3 bracket).
    New in scripts/atp: atp2/3/4 summaries, bias_check, error_field_fit, fix_dome_cols.
    Add ATP-3 prediction for D1_final (V3-fitted model, not refitted).
2026-10-12 Finished with all ATPs for dome version of marker prototype
2026-10-12 Add replay source for running the UI on saved clean frames
2026-10-13 Code cleanup & separation of funcs (tracking vs rendering)
    Remove detach mode, trajectory toggle and unused level_pairs
    Split tracking from rendering: add ar_tracker.Tracker and FrameResult
2026-10-13 Added pedicle selection, calibrated error and to-scale circle for pedicles
    Add pedicle selection (level + side) with new key map
    Show calibrated expected error (95%) with true-scale circle, graded on measured accuracy
2026-10-13 Add docked left rail, trust badge and hint bar; move diagnostics to engineer mode; fit window to camera aspect
2026-10-13 Separate qt & drawing modules; update readme for UI pkg
    Move Qt and drawing modules into scripts/registration/ui/ package
    Update registration README for ui/ package, rail layout and new key map
2026-10-13 Add zoom view with +/- steps, crop box and auto-open
    Add multi-view framework and zoom view on the selected entry point (Z)
    Zoom view fills the video area with the camera as an inset; V swaps to side by side
    Zoom view: +/- steps, reset, crop box on camera inset, thicker outline and exact tint
    Zoom view: tinted crop box, level zoom controls
    Zoom controls: hand-placed pill; rename Engineer to Debug mode, swap with Help
    Auto-open zoom on first pedicle pick, close on all levels
2026-10-13 Added axial view (cross-section)
    Add axial view: cross-section of the selected vertebra with trajectory and error circle (X)
    Move axial view into the rail, float debug panels over video, enlarge axes gizmo
    Axial view fills its pane and is on by default; taller default window; compact debug panels; smaller axes gizmo
2026-10-13 Add sagittal view and a multi-view layout, plus zoom for the all-levels view
    Zoom for all-levels view, add sagittal view (L), restyle debug card as one panel
    Axial/sagittal: V moves them between rail and right column; zoom keeps camera inset; reserve title strip
    Axial/sagittal column is the default layout; only Z closes zoom; tighter debug rows
2026-10-14 Add click-to-check, options column and thinner all-levels zoom outlines; fit hint bar
    Add click-to-check: click the real entry dot for overlay error, pinned mark and CSV log
    Thinner outlines for the all-levels zoom view
    Add options column to the rail (outline, error circle, side views) and a click-to-check line in the target card
    Fit the hint bar to the free width beside the camera inset
2026-10-14 Add rolling pose jitter (mm) to the debug card and CSV log
2026-10-14 Add scene description (ar_scene.py): per-frame JSON for the UI, --scene-log, scene saved with screenshots
2026-10-14 Add unit tests (error model, selection, scene, jitter, click-check, geometry); factor click-check maths into ar_check.py
2026-10-16 Auto board mode: pick dome or L-bracket from the visible markers, B to override
2026-10-21 Add --solver option to the Monte Carlo design sweeps
    simulate() hard-coded SOLVEPNP_ITERATIVE, so the dome sweeps could not
    use the solver of the live pipeline (SQPNP). Add --solver
    {iterative,sqpnp} (default iterative), pass it to solvePnP through a
    module-level SOLVER_FLAG, and print the solver in the design header so
    each saved output records it.
2026-11-03 Chose images for report; track data; update gitignore
2026-11-03 Pin dependency versions
2026-11-03 Remove debug prints from the Qt overlay
