LlamaLuLu/EEE4022S-AR-Spine-Registration/(notices)

Notices in the files:
README.md:
License: MIT
